2jkbr252t7-debug/Robot/obrazky/postupne/03_koncept_otocny_krk/B_rozpracovane/MG90S_porovnanie_s_modelom.png

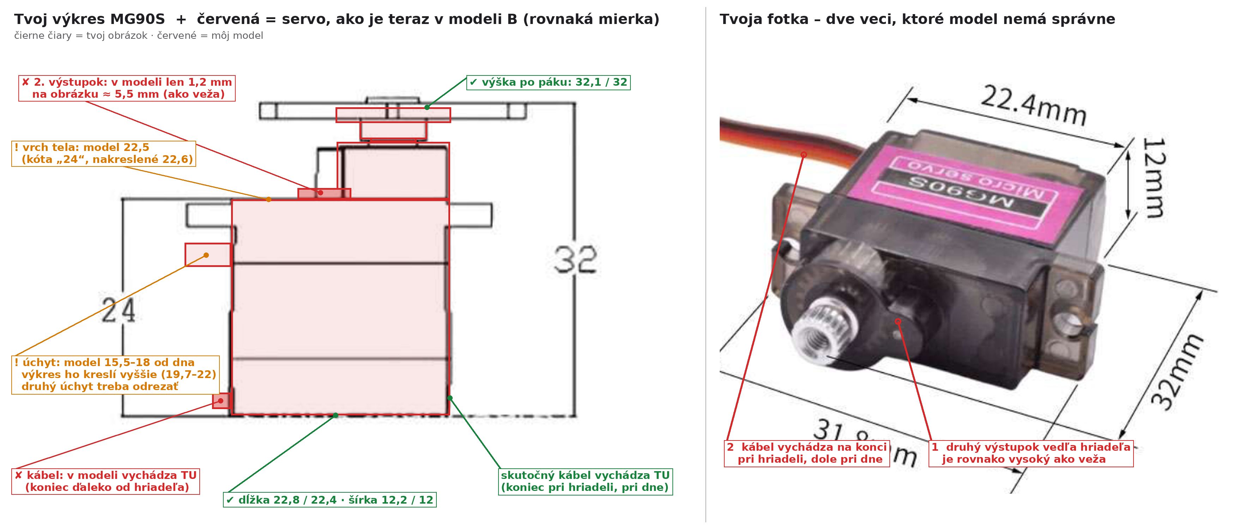
obrazky/postupne/03_koncept_otocny_krk/B_rozpracovane/MG90S_porovnanie_s_modelom.png
