2jkbr252t7-debug/Robot/obrazky/postupne/04_trup_rozpracovane/k2/koncept.md

# NOVA mini – K2 "off-axis gears, compact": internal packaging of torso + base

Files in `/tmp/claude-0/gapwf/fin/T1/k2/`: `layout.json` (t1lib, generated by `gen_layout.py`), `check.json`,
`envelope.json`, `head_keepout.json`, `head_real_check.json`, `prev_*.png` (rest + awake: iso, front, side, cut and
full sections `prev_*_rez_cut_side/front.png`). Coordinates: world mm, Z up, floor z = 0, FRONT = −Y, robot RIGHT = −X.
All shells in the layout are **soft placeholders** (torso superellipse n 2.35 with R16 edges, base n 2.35 with R10
edges, arms = rf 11.4 pills); they only prove that the internals fit a soft, modern body of R01 size.

## 0. Key numbers

| item | K2 value | R01 target | deviation |
|---|---|---|---|
| Z_TT (collar top) | 133.0 | – | head top 215 (range 205–215, upper end) |
| torso W × D × H | 89 × 80 × 89 (z 43–132) + collar plateau r 29.8 to z 133 | 91 × 78 × 87 | −2 % / +2.6 % / +2.3 % |
| base W × D × H | 142 × 110 × 34 (z 6–40), ground clearance 6 | 138 × 110 × 36–40 | +2.9 % / 0 / ok |
| arms | pill paddles 23 × 30 × 83, outer face ±69.5, shoulder axis X at (y 2, z 112) | 18–22 × 30 × 75–85, face ±67 | thickness +4.5 %, face +3.7 % |
| static clashes | **0** | | |
| sweep (18 STD + 23 own poses) | **0 unresolved** – residuals = 10 arm↔head instances in 4 STD poses forbidden by the firmware arm table + 3 t1lib head-envelope artefacts (2 poses at the B tilt-table limits) cleared with the real head mesh | | |
| mass / CoG | 892 g (head 165, neck + foot 49, pan stage 43, torso 232, arms 2 × 18, base 367); CoG rest (−0.1, −1.6, 74.8) | | |
| tipping (support: wheels ±54, casters y ±34) | rest: margin 27.4 mm, 20.1°, 16.1 mm left at 0.15 g; worst (arms 100° forward, head lifted + nodding 40°): 22.1 mm, 15.9°, 10.4 mm at 0.15 g | | stable |
| runtime (4 × 18650) | idle 13–15 h, typical 8.4–9.8 h (3000 / 3500 mAh, 85 % usable) | > 8 h | ok |

Why "K2": the two yaw joints are driven by spur gears from servos that sit **off the axis**, where a soft shell still
has room, and the vertical stack is kept as short as possible:

| z (world) | centre column (what sits on the J1 axis region) |
|---|---|
| 0–10.5 | ball casters Ø10 at y ±34; wheels Ø32 × 9 at x ±54 (axle z 16) |
| 6–8.2 | base bottom (battery covers) |
| 10–22.5 | 2 × N20 + magnetic encoders on the axle line, connectors meet at the centre |
| 10.8–30.0 | 4 × 18650 (2S2P): parallel group 1 = 2 cells in front of the axle, group 2 = 2 cells behind it, cells along X, series link over the axle |
| 23–30.8 | J1 hub bridge + steel-cored post (between the two battery groups) |
| 30.2–37.4 | J1 rolling-loop channel r 21.5–34 + 6805-2RS bearing r 12.5–18.5 |
| 38.8–42.0 | J1 gears: fixed brass sun m1 18T on the hub (slip clutch) + POM pinion m1 18T on the STS3215, centre distance 18 |
| 40 / 41–42.4 / 43 | base top / dark rotating plinth skirt r 34 / torso bottom |
| 45.5–80.5 | STS3215 shaft-down, offset −18 in X; pan servo STS3032 at the front (y −15…−28) |
| 81–82.8 | deck (carries the pan pivot pin, the pan servo, the frame) |
| 82.8–86.7 | PTFE washer, pan gear m0.8 36T + pinion 18T (front), pan rolling loop (back half, r 15.6–26.3, z 82.9–86.5) |
| 87.5–127 | pan stage: well 47 × 22, lift MG90S + crank behind the well, neck-wire lift loop at the +X end |
| 89.5–92.5 | neck foot at rest (109.5–112.5 extended) |
| 112 | shoulder axis (arm servos are in the paddles) |
| 118.5–124.5 | pan journal Ø56.4 in a POM-lined ring |
| 127–133 | collar disc + ring (finished variant B) |

## 1. Joints

### J1 – torso yaw ±150°
* **Actuator:** Feetech STS3215 (7.4 V version, 19.5 kg·cm = 1.91 N·m stall, 12-bit magnetic encoder over 360°,
  45.2 × 24.7 × 35 mm, 55 g; datasheet / vendor listings, confidence high for the footprint, medium for the height –
  I used the larger envelope 35 mm case + 2.6 mm spline boss, plus 11.3 mm for the two 5264 plugs and their bend).
  Inside the torso, shaft **down**, shaft at (−18, 0).
* **Transmission:** 1:1 external spur pair, module 1.0, 18T/18T (pitch Ø18, tip Ø20), centre distance 18.0, face 3.2
  (the stack has exactly 1.0 mm to the hub below and to the torso floor above). The sun gear is fixed to the base hub; the pinion (25T female spline + M3 axial screw) orbits it with the torso, so the
  servo turns exactly by the torso angle (310° of its 360° used). Why off-axis: with the shaft on the axis the servo's
  plug end lands at x ≈ 44.7, outside the soft torso (interior a 42.3 and smaller in the rounded bottom); with the 18 mm
  offset servo + plugs span x −29.5…+27 and stay centred. The pinion/sun pair lives in the 3 mm plinth gap and the base
  top layer, so the servo body starts directly on the torso floor.
* **Bearing:** 6805-2RS 25 × 37 × 7 (C 4.3 kN) – inner ring snapped on the static hub (POM collet on a steel M8 core,
  PETG post on a bridge between the battery groups), outer ring pressed into the rotating dark foot ring r 18.5–20.5. The bearing carries weight and
  tipping moments; the pinion floats axially (0.3 mm) on the spline, so the servo only sees torque.
* **Range / stops:** firmware ±150°; hard stops ±155° = tooth on the foot ring against a block on the hub (below the
  gears, outside the cable channel).
* **Torque:** yaw inertia of torso + head + arms ≈ 6·10⁻⁴ kg·m²; 90° in 0.6 s (triangular profile) → α 17.5 rad/s² →
  0.011 N·m; friction (2RS seals ≈ 0.015, mesh 5 %, rolling loop 0.002) ≈ 0.02 N·m → **0.03 N·m needed vs 1.91 N·m
  stall (≈ 60×)**. Holding: zero (vertical axis).
* **Tooth strength (the K2 weak point):** at full servo stall the m1 tooth would see 212 N (Lewis σ ≈ 220 MPa at 3.2 mm face) – too
  much for POM. Therefore (a) STS3215 torque limit 15 % (0.29 N·m → 32 N, σ ≈ 33 MPa on the 3.2 mm POM pinion, still ≈ 10× the need),
  (b) the brass sun gear sits on a **slip clutch** (wave spring + friction ring, slip 0.25 N·m) so a child twisting the torso
  slips the clutch instead of stripping teeth; the STS3215 load register detects a slip and the firmware re-homes on the
  ±155° stop at low torque, (c) preferred material: brass sun gear + POM pinion (quiet, wear-matched).
* **Backlash:** printed m1 pair 0.08–0.12 mm → 0.5–0.75° of torso yaw (0.6–0.8 mm at the display corner, r 64). Fix:
  slotted servo cradle (±0.3 mm centre distance) set to 0.02–0.03 mm → ≈ 0.2°; option: scissor sun gear (2 × 1.9 mm,
  wire spring). Firmware: approach targets from one side.

### PAN – head yaw ±85° (±90° mechanical)
* **Actuator:** Feetech STS3032 bus servo (360° magnetic encoder, 4.5 kg·cm @ 6 V, ≈ 3.7 kg·cm @ 5 V; vendor listings
  give 23.2 × 12.1 × 28.5 mm, 20–21 g – envelope used 23.5 × 12.5 case, 32.5 tabs, spline top 28.5; confidence medium),
  static in the torso front, shaft up at (0, −21.6).
* **Transmission:** spur m0.8, pinion 18T (Ø14.4) → gear 36T (Ø28.8) on the pan stage, **2:1 reduction**, centre
  distance 21.6, face 3.2/3.5 (POM). Servo ±170° → pan ±85°; resolution 0.044°/step. The gear is toothed only over the
  ~200° that can face the pinion; the remaining back sector is a smooth drum on which the pan rolling loop lies.
* **Bearing:** two-point: bottom = Ø6 steel pin fixed in the deck + bronze sleeve in the gear hub (radial) and a PTFE
  washer under the gear (axial, ≈ 3 N); top = Ø56.4 journal around the well (z 118.5–124.5) in a POM-lined ring of the
  frame (0.05–0.1 mm radial). Bearing span 36 mm → joint play ≤ 0.1/36 rad → ≤ 0.25 mm at the head top.
* **Stops:** pin under the gear in a 180° arc slot of the deck → ±90°; firmware ±85°.
* **Torque:** pan inertia (head + neck + stage) ≈ 2.7·10⁻⁴ kg·m², 85° in 0.35 s → 48 rad/s² → 0.013 N·m; friction
  (PTFE thrust 0.003, journal 0.007, loop 0.002) → 0.026 N·m needed vs 0.72 N·m at the gear (≈ 28×). Tooth: with the
  servo torque limit at 40 % the m0.8 tooth stays < 30 MPa; a 5 N push on the head edge gives only 19 N on the tooth.
* **Backlash:** gear 0.08 mm at r 14.4 (0.32°) + servo internal backlash halved by the 2:1 (≈ 0.25°) → ≈ 0.6° ⇒
  ≈ 0.6 mm at the display corner. Option: a light torsion spring (0.01 N·m) between frame and pan stage to bias one flank.

### LIFT – neck 0…20 mm
* **Actuator:** MG90S (22.8 × 12.2 × 28.5, 13.4 g, 1.8 kg·cm @ 4.8 V / 2.2 @ 6 V; electronics_dims.json) on the pan stage
  **behind the well**, shaft along X at (y 19.1, z 104.8); its lower mounting tab is cut off (as the B neck servo).
* **Mechanism:** crank r 10 (POM) with a Ø2 steel pin in a 2.2 × 12.2 horizontal slot of the **ear** of the neck foot.
  The foot (POM, 45 × 20 × 3) is screwed into the neck bottom (allowed new part) and passes through the collar slot; the
  ear is a separate POM link screwed to the foot through a 4.5 mm window in the well's back wall. lift = 10·(1 − cos θ),
  θ 0 → 180°: **dead centres at rest and at full lift → zero holding torque in both end positions**; the well (47 × 22,
  1 mm clearance, two PTFE tape strips) remains the linear guide.
* **Stops:** crank dead centres; backups: foot 1.0 mm above the well floor, ear 1.4 mm below the journal ring at 20 mm.
* **Torque:** neck + head + foot 213 g → 2.1 N, guide friction (CoG offset y −8 → 0.4 N) + loop 0.1 N → 2.6 N ×
  r 10 = 0.026 N·m max (mid-stroke) vs 0.177 N·m stall @ 5 V → **6.8×**. Holding at the awake pose (12.5 mm, θ 104.5°):
  0.025 N·m (≈ 15 % of stall, acceptable; dead centres are used for rest and full lift). Full stroke 0.36 s at 5 V
  (firmware ramps to ≈ 0.5 s).

### TILT – unchanged (variant B rev. E2)
MG90S in the neck, tilt-vs-lift interlock table of `B/montaz.txt`; PWM and 5 V from the torso controller through the
pan loop. Verified here with the **real head mesh** against the K2 placeholder top over the whole table and pan
−85…85: min 0.45 mm at the collar plateau edge (r 29.8, same B criterion ≥ 0.25), ≥ 1 mm elsewhere; real hinge lugs vs
the K2 well: 1.0 mm (`head_real_check.json`).

### ARMS – one servo inside each paddle
* **Actuator:** slim metal-gear micro servo, EMAX ES9052MD class (listings: 19.9 × 8.8 × 23.1–26.35 mm, 5.5–6 g,
  1.3 kg·cm @ 6 V; envelope used 21 case + 5.35 boss/spline along X, 20.5 × 9.4 – larger listing, confidence medium).
  The case is fixed in the paddle and turns with the arm; its spline sits in a **static spline socket** on the side
  column of the torso frame (r 7 hub at |x| 37.5–43). The arm pulls off sideways (magnetic detent) for service.
* Why in the paddle: inside the torso the shoulder servos would sit exactly in the pan-stage sweep (r ≤ 35.9 around the
  well); in the paddle they cost only 2–3 mm of paddle thickness.
* **Range:** −45…+135° (180° servo travel, verify 500–2500 µs on purchase). The head (|x| 55, ears 58.8) is wider than
  the arm's inner face (|x| 46.5), so the upper limit depends on the head pose – firmware table `check.json →
  arm_limit_table_deg` (every entry verified with ≥ 2 mm to the head envelope). Right arm at pan 0: 102° (rest), 125°
  (lift 20), 95–98° while the head nods down (lift 12.5/+30°, lift 20/+40°), 144–151° while it looks up; with the head
  panned ≥ 60° and not nodding towards that arm the geometry allows 180°, i.e. the full 135° servo travel. Left arm =
  same table with the pan sign inverted. The firmware clamps the arm command to this table (interpolated, −2° margin).
* **Torque:** paddle 10.6 g with CoG 25 mm below the axis + servo on the axis → 0.003 N·m holding at 90°, 0.0014 N·m to
  accelerate 90° in 0.25 s → 0.0045 N·m vs 0.108 N·m @ 5 V (≈ 24×).
* Clearances: paddle ↔ torso 2.0 mm, black cap ↔ shoulder pocket 1.0 mm, paddle ↔ base ≥ 5.0 mm (tip at z 45 over the
  base top z 40, also over J1 ±150°), the two arms never meet.

### WHEELS – differential drive
* 2 × N20 6 V 1:150 with magnetic encoder (12 × 10 × 34 + encoder 8 + plug 5; 7 PPR × 4 × 150 = 4200 counts/wheel
  rev), wheels Ø32 × 9 (TPU tyre) at x ±54, track 108, axle z 16, 6 mm below the base bottom; DRV8833 (Pololu
  20.3 × 15.2). Two 3/8″ ball casters at y ±34 (support diamond). Ground clearance 6 mm.
* **Torque:** robot ≈ 0.89 kg: rolling 0.2 N + 0.5 m/s² + 5° ramp 0.85 N → 1.55 N → 0.012 N·m per wheel vs
  ≈ 0.2 N·m stall (≈ 16×). Speed ≈ 110 rpm → 0.18 m/s at 6 V (desk use 0.05–0.12 m/s).

### Checks (t1lib, `check.json`)
* **Static:** 0 clashes (73 K2 components + 10 B envelopes, all pairs except the listed intended fits: gear meshes,
  bearing seats, journal, PTFE washer, crank pin in the ear slot, light guides / ports through the shells).
* **Sweep STD_POSES (18):** 10 clash instances in 4 poses, all arm ↔ head (arm at 135–180° with the head in front of it);
  every one is outside the arm limit table and therefore forbidden by firmware. Nothing else.
* **Own extra poses (23):** pan ±85 with lift 0 / 5 / 10 / 12.5 / 15 / 20 and the table tilts (+5/−10 at lift 0, +30/−40
  at 12.5, ±40 at 20), intermediate pans/lifts (±30, ±45, ±60), awake pose, arms −45/0/45/100/180 combined with head
  poses, J1 ±150 / ±75 with arms forward/up/back. Result: 3 instances in 2 poses (pan −85 with lift 12.5/tilt −40 and lift 0/tilt −10:
  T_shell ↔ B_hlava, P_sachta ↔ B_uska) – all at the limits of the B tilt table and caused by the t1lib head envelopes
  (rf-14 box, lug box), which are lower/larger than the real head. Re-checked with the real B rev. E2 meshes over the
  whole tilt table × pan −85…85 (`head_real_check.json`): head ↔ torso top ≥ 0.45 mm (over the plateau, B criterion),
  real lugs ↔ K2 well 1.0 mm. 0 unresolved.
* **Min clearances of K2 moving parts:** lift servo/crank/loop ↔ torso internals 1.0; neck foot + ear ↔ torso 1.15,
  ↔ well 1.0; well corners ↔ pan channel 1.0; pan stage ↔ torso shell 1.9; J1 rotating parts ↔ base 1.0 (foot ring ↔ FPC
  channel, sun gear ↔ torso floor); arm ↔ torso 1.0 (cap in the pocket) / 2.0 (paddle); arm ↔ base 5.0; arm ↔ head ≥ 2.0
  inside the table. Intended < 1 mm: collar disc/ring seam 0.25 (B), pan journal running fit, pan loop resting on its
  drum, real head over the collar plateau 0.45 (B criterion ≥ 0.25).

## 2. Cable routing

**J1 (6 conductors, ±155°):** VBAT ×2, GND ×2, servo/node bus, wake/spare. Default: custom polyimide FPC 6.0 × 0.15 mm
(2 oz Cu: VBAT/GND traces 1.3 mm, bus/wake 0.4 mm; ≈ 4 A peak total); alternative: 4 × AWG26 + 2 × AWG30 silicone
Kapton-bonded on edge (6.4 mm). Path: base charger/BMS area (back) → static anchor on the outer wall of the channel
(inner face r 32.5, ≈ 120°) → outer run on the static wall → U-turn → inner run on the rotating foot ring (r 20.5) → rotating anchor →
up through the torso floor at r ≈ 20 → JST-GH 6p on the torso controller. Rolling loop in the annulus r 21.5–34,
z 30.6–37.2: U-turn centreline radius ≈ 5.3 mm (≈ 35× FPC thickness), U-turn travel 0.40 × Δθ (125° for 310°),
**loop length in the channel ≈ 103 mm** (+ 2 × 15 mm leads → 135 mm). No slip ring, no twist.

**PAN (8 conductors, ±85° + 20 mm lift):** head 4 (5 V_H, GND_H AWG28 PTFE Ø0.85; TX, RX AWG30) + servo group 4
(5 V_S, GND_S AWG28; PWM tilt, PWM lift AWG30) as a 2 × 4 Kapton-bonded ribbon 3.6 × 1.8 mm. Path: head → neck
channels (B) → neck bottom exit (x 13.8) → channel inside the POM foot → foot +X end → window in the well's +X end wall →
**vertical lift loop** on the outside of that wall (x 25.3–27.8, z 89.5–113; U-turn rises 10 mm for 20 mm lift) → down
under the well → rotating anchor on the smooth drum sector of the pan gear → inner run on the drum (r 15.7) → U-turn
(centreline R 5.2) → outer run on the static back-half wall (r 26.1) → static anchor ≈ 20° → through the deck to the
controller (JST-SH 4p + 4p). Loop in the channel ≈ 56 mm; U-turn travel 0.37 × Δθ (63° for 170°); everything stays in the
back half, away from the pan pinion at the front. Lift-servo leads (3) join the ribbon on the pan stage via a 2 × 3 pin
micro-junction (shared 5 V_S/GND_S).

**Arms:** 3 × AWG30 per arm, one-turn flat spiral in the shoulder pocket (r 7.5–12.5, |x| 41.2–43.2), JST-SH 3p inside
the torso. Range 180° → spiral rotates ±0.25 turn.

## 3. Electronics and power

```
 2S2P 18650 (7.2 V nom, 6.0–8.4 V, 43–50 Wh) ── 2S BMS (balance, OCP 8 A) ── AO4407A main switch (self-locking button, back)
   │ base                                         │ J1 rolling FPC (VBAT×2, GND×2, BUS, WAKE)
   ├ DRV8833 → 2× N20 (PWM-limited to 6 V)        │ torso
   ├ D24V10F5 5 V/1 A → RP2040-Zero node,        ├ STS3215 J1 (VBAT direct, bus ID 1)
   │   encoders (PIO), 4× ITR8307 cliff (ADC),   ├ D36V28F5 5 V/2.8 A + 470 µF → 5 V rail:
   │   VL53L1X ToF (I2C), base LED bar (8× 2020)  │     head (5 V_H, UART 1 Mbps via pan loop), tilt MG90S, lift MG90S,
   └ IP2326 2S charger ← USB-C 5 V/2 A (back)     │     2× arm ES9052MD, pan STS3032 (bus ID 2), ESP32-S3-Zero,
                                                  │     torso LED bar (6× 2020), MAX98357A → Ø28 speaker
                                                  └ ESP32-S3-Zero: UART head, half-duplex bus (74LVC1G126), 4× PWM, I2S, LED
```
* The base node (RP2040-Zero, 23.5 × 18) is bus ID 20: wheel speeds, encoder counts (PIO quadrature), cliff stop
  locally within 1 ms, ToF, charger status, LED bar. Battery voltage is read from the STS3215 voltage register.
* **5 V rail (torso):** typical 0.55 A; firmware-capped peak 2.5 A (max. two micro-servos in fast motion at once, audio
  peaks buffered by 470 µF) < 2.8 A of the D36V28F5.
* **Charging:** IP2326 boost charger (5 V/2 A in, 8.4 V CC/CV ≈ 1 A, ≈ 6–7 h for 6 Ah). The robot may stay on while
  charging (USB 10 W > 2.8 W idle), but the charger only terminates when the robot is off or asleep (< 50 mA); a full
  charge is therefore done with the main switch off. Charge state shown on the base LED bar + a small LED at the port.
  (True power-path is a phase-2 option: buck-boost NVDC charger.)

| power at the battery | idle (awake, no motion) | typical | peak (< 1 s) |
|---|---|---|---|
| head board + LCD + ears | 1.25 W | 1.6 W | 2.5 W |
| torso MCU + bus driver | 0.20 | 0.25 | 0.4 |
| STS3215 / STS3032 | 0.23 | 0.45 | 7.4 + 2.0 |
| 4 micro servos (tilt, lift, 2 arms; lift holding at 12.5 mm) | 0.28 | 0.6 | (5 V cap) |
| LED bars (20 %) | 0.20 | 0.25 | 1.2 |
| audio | 0.01 | 0.15 | 1.8 |
| base node, encoders, ToF, cliff | 0.35 | 0.40 | 0.5 |
| N20 + DRV8833 | 0 | 0.20 | 7 |
| converter + BMS losses | 0.30 | 0.45 | 3 |
| **total** | **≈ 2.8 W** | **≈ 4.35 W** | **≈ 30 W** (5 V rail capped at 14 W; pack 4.7 A = 2.3 A/cell) |

Runtime, 85 % usable: 3000 mAh (36.7 Wh) → idle 13.1 h, typical 8.4 h; 3500 mAh (42.8 Wh) → idle 15.3 h, typical 9.8 h;
sleep (display off, servos unpowered, ≈ 0.35 W) > 100 h.

## 4. Mass, CoG, tipping
| group | g | main items (bought = datasheet/listing, printed = volume × density) |
|---|---|---|
| head (finished B) | 165 | shell, display board, ears (t1lib B_HEAD_MASS) |
| neck + foot (lift group) | 49.4 | neck + MG90S tilt 45, POM foot + ear 4.4 |
| pan stage | 43.0 | collar disc 8.8, well + journal (resin) 15.1, MG90S lift 13.4, pan gear 3.8, crank 0.9, wires 1 |
| torso | 232.1 | resin shell 2.2 mm 69.6, STS3215 55, 6805-2RS 22, STS3032 21, deck/cradle/columns/ring PETG ≈ 23, controller 8, speaker 6, J1 skirt/foot/pinion ≈ 9, buck/amp/cap/LED ≈ 9.5, cables ≈ 4 |
| arms (2×) | 36.2 | per arm: resin paddle 10.6, ES9052MD 6, cap 1, cable 0.5 |
| base | 366.5 | 4 × 18650 incl. strips 196, resin shell 77.7, 2 × N20 + encoder 24, wheels 14, casters 8, brass sun gear 8.5, hub/channel/FPC ≈ 15, charger/BMS/USB/switch 11, node/driver/buck/ToF/LED/cliff ≈ 11 |
| **total** | **892** | CoG rest (−0.1, −1.6, 74.8) |

| pose (t1lib `tipping`, accel 0.15 g) | CoG (x, y, z) | static margin | tip angle | margin at 0.15 g |
|---|---|---|---|---|
| rest | (−0.1, −1.6, 74.8) | 27.4 mm | 20.1° | 16.1 mm |
| awake (lift 12.5, tilt 10, pan 30, arms 60/−20) | (1.2, −3.0, 77.6) | 25.6 | 18.2° | 13.9 |
| arms 100/100, lift 20, tilt 40 (worst) | (−0.1, −7.9, 77.4) | 22.1 | 15.9° | 10.4 |
| J1 90, pan 85, lift 20, tilt 40, arms 90 | (1.9, 6.3, 77.3) | 22.4 | 16.2° | 10.9 |
| J1 45, pan 85, lift 20, tilt 40, arms 100 | (5.8, 3.2, 77.4) | 22.9 | 16.5° | 11.3 |
| arms −45, lift 20, tilt −40 | (−0.1, 5.1, 78.6) | 24.4 | 17.3° | 12.6 |

Support polygon = diamond of the wheels (±54, 0) and casters (0, ±34); its four diagonal edges are 28.8 mm from the
centre. 41 % of the mass sits in the base below z 40, which keeps the CoG at 75–79 mm in every pose.

## 5. Assembly order, service, hidden fasteners
**Base:** (1) heat-set inserts in the white top shell; (2) chassis (PETG) with motor clamps, hub bridge, J1 hub
(steel M8 core) + slip-clutch sun gear, J1 channel with the FPC static anchor; (3) motors + encoders + wheels; (4) PCBs:
node, DRV8833, buck (corner pockets beside the battery bays), BMS, charger + USB-C + switch (on top of the battery
groups, outside r 35), ToF + LED bar at the front; (5) dark bottom plate with casters and cliff boards; (6) the two
battery groups (series link + balance lead, XT30 + JST-XH, no hot glue) drop into two bays from below, each closed by
a cover with 2 × M2 – **the only screws of the base, all on the underside**.
**Torso:** (1) printed frame = cradle + deck + 4 columns + top journal ring (2 parts, screwed); (2) STS3215 into the
cradle (4 × M2 side holes), pinion; (3) STS3032 + pinion (2 tab screws); (4) pan stage: pivot pin, PTFE washer, pan gear
(stop pin), well, lift MG90S + crank; (5) controller, buck, amp, cap, speaker, LED bar, arm spline sockets + cable
spirals; (6) shell = rear shell + front panel (R01 front-panel seams): rear shell screwed from the torso bottom (inside
the plinth gap, invisible), front panel on 4 N52 magnets + 2 locating pins; (7) collar ring glued in; (8) neck + head
from above per B montaz: neck + foot pass through the collar slot, then the ear link is screwed to the foot through
the back-wall window (rear shell off), collar disc on; (9) torso onto the base: the 6805 (pressed into the foot ring)
slides over the sun gear (Ø20 < bore Ø25) and snaps over a 3-finger POM collet lip of the hub (pull-off ≈ 30 N, 8× the
weight of the base, so the robot can be lifted by the torso), the pinion meshes vertically, FPC plugged through the
rear opening.
**Service:** battery – bottom covers; USB-C/switch – on the back of the base; arm servo – pull the arm off, unplug
JST-SH; lift servo, controller, pan loop – rear shell off (screws under the torso); pan servo – front panel off;
STS3215 – pull the torso off the collet, unplug the FPC (15 mm slack), 4 screws. No screws on top/front/sides.

## 6. How much the soft shell constrains K2
The minimum interior that encloses all K2 internals + 1.0 mm (`envelope.json`, slices every 5 mm, superellipse with the
placeholder aspect b/a = 0.9) is **a ≥ 40.9 mm** for n 2.35–3.0 (41.2 for n 2.2), set by the pan/lift sweep at
z 88–118 and by the J1-servo zone at z 53–73 → with a 2.2 mm wall the smallest soft torso is **≈ 86 × 78 mm**; R01's
91 × 78 fits. The placeholder is 89 × 80 because parts that are screwed to the shell anyway (side columns with the arm
spline sockets at |x| ≤ 41.5, speaker at |y| ≤ 36.6) sit right at the wall. The base needs a ≥ 68.0 (n 2.35,
b/a 0.775) → **≥ 140.4 × 109.8 mm**; the exponent barely matters (68.1 at n 2.2) because the critical points are the
wheels (|x| 59.5), the ToF window and the battery-pack ends, not the corners.

What the soft shell actually cost:
1. **J1 servo off the axis.** With the STS3215 shaft on the axis its plug end (+11 mm) lands at x ≈ 44.7, outside the
   rounded interior (42.3, less in the R16 bottom). The 18 mm offset + 1:1 spur pair keeps servo and plugs within
   x −29.5…+27 – the main reason for K2's gears.
2. **Depth is set by the lift crank:** the crank/ear sweep r 35.9 about Z (back and right sector) needs an interior
   depth ≥ 2 × 36.9 → 78.2 mm outside with a 2.2 wall (placeholder 80).
3. **Bottom rounding (R16):** below z 53 only the centred STS3215 fits; the amp, buck and controller moved up to
   z ≥ 52–55, the pan servo into the front band (y −15…−28) where the superellipse still has full depth.
4. **Top:** a 1 mm collar plateau r 29.8 is needed in every direction, because pan ±85° swings the nodding head over the
   wide X sides where a plain R16 edge stays too high (real-head check: 0.45 mm over the plateau, ≥ 1 mm beyond). The
   arm sockets (axis 21 mm below the top) sit just under the R16 top edge, so the shoulder pockets are partly cut into
   the rounded shoulder – the R01 look of caps on the upper corners.
5. **Base corners:** the four 66.5 mm cells end 1–2 mm from the n 2.35 / 142 × 110 interior; the four small boards
   (node, driver, buck, charger) live in the triangular pockets beside the cell ends.
6. **Plinth:** with ≥ R15 edges the torso's flat bottom is only ≈ 57 × 48, so the rotating dark skirt r 34 shows under
   the rounded belly as the R01 plinth ring – a feature, but it fixes the base top as flat to r 36.

## 7. Top risks
1. **J1 gear mesh is the weakest link** against a user twisting the torso → slip clutch + torque limit + re-homing are
   mandatory, brass sun gear recommended.
2. **Yaw backlash** of two gear pairs (J1 + pan) ≈ 0.2–0.8° each → visible head wobble of 0.3–0.8 mm if not adjusted.
3. **Zero vertical slack** in the torso stack (STS3215 top 80.5 → deck 81). The STS3215 height is taken as the larger
   envelope (35 + 2.6); if the real servo is 35 overall we gain 2.6 mm.
4. **Pan loop on a half-toothed drum** is novel; fallback = loose 8-wire S-loop behind the well (needs ≈ 8 mm more torso
   height).
5. **Arm/head interference** is inherent to R01 proportions → firmware table; the slim arm servo (8.8 mm class) must be
   verified for 180° travel and availability; with an MG90S the paddle grows to ≈ 26 mm.
6. **Lift holds torque away from the dead centres** (awake pose 12.5 mm): MG90S hum; consider dead-centre-only poses or a
   bus servo (SCS0009) for silent holding.
7. **Base corners:** the battery groups end 1–2 mm from the placeholder base wall at the four corners – the exterior
   must keep ≥ 142 × 110 at z 11–30 with n ≥ 2.3 or the base grows.
8. **Head top clearance in X:** the wide torso (89) must still drop ≥ 1 mm beyond r 30 in every direction (pan ±85 swings
   the nodding head over the X sides) – collar plateau r 29.8 + 1 mm step in the placeholder.

## Zhrnutie (SK)
* K2 = otočné kĺby poháňané ozubenými kolesami zo serv mimo osi: trup (J1) Feetech STS3215 posunutý o 18 mm s prevodom
  1 : 1 (modul 1, 18/18 zubov), otáčanie hlavy Feetech STS3032 vpredu s prevodom 2 : 1 (modul 0,8, 18/36 zubov).
* Vďaka tomu sa všetko zmestí do mäkkého trupu 89 × 80 × 90 mm (R01: 91 × 78 × 87); najmenší možný mäkký trup je ≈ 86 × 78.
* Zdvih krku: MG90S za šachtou, kľuka r 10 s mŕtvymi bodmi na oboch koncoch (v pokoji aj hore servo nedrží záťaž).
* Servá ramien sú priamo v lopatkách (hrúbka 23 mm), ramená idú −45…+135°; horná hranica závisí od polohy hlavy (tabuľka).
* Podstavec 142 × 110 × 34: 4 × 18650 (2S2P) v dvoch dvojiciach pred a za nápravou, výmena zospodu, USB-C a vypínač vzadu.
* Káble cez otočné kĺby idú vo valivých slučkách (J1: 6 vodičov, 103 mm; hlava: 8 vodičov, 56 mm) – bez zberacích krúžkov.
* Kontroly: 0 statických kolízií, 0 nevyriešených kolízií v 41 polohách; hmotnosť 892 g, ťažisko vo výške 75 mm,
  robot sa prevráti až pri náklone 20°.
* Výdrž: v pokoji 13–15 h, pri bežnom používaní 8,4–9,8 h. Hlavné riziká: zuby J1 pri násilnom otočení trupu (riešenie:
  trecia spojka + obmedzenie momentu), vôľa ozubení (0,2–0,8°) a nulová výšková rezerva v trupe.
