2jkbr252t7-debug/Robot/obrazky/00_NOVA_prehlad.png

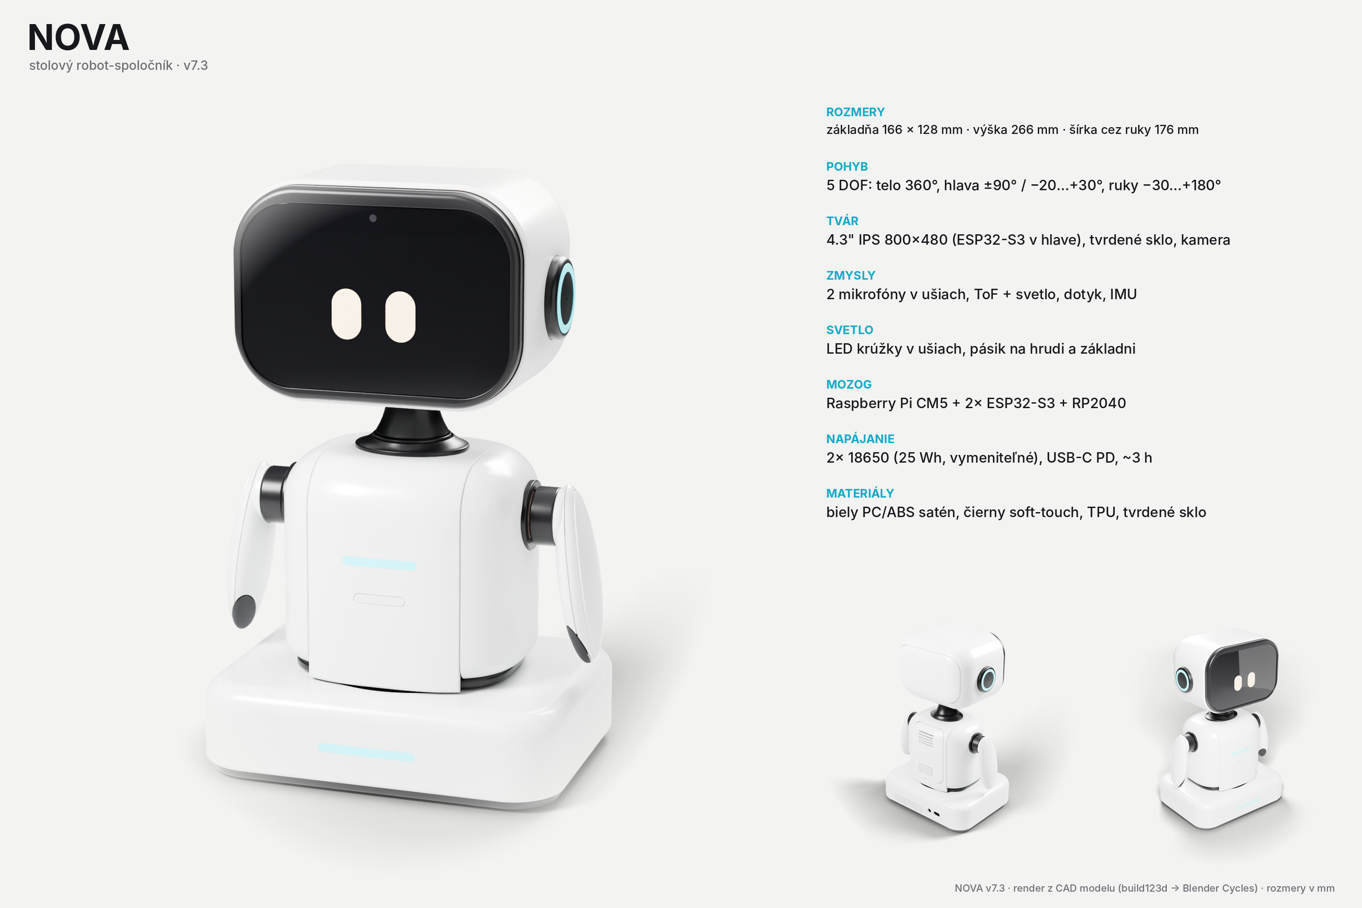
obrazky/00_NOVA_prehlad.png
