2jkbr252t7-debug/Robot/obrazky/00b_NOVA_hero.png

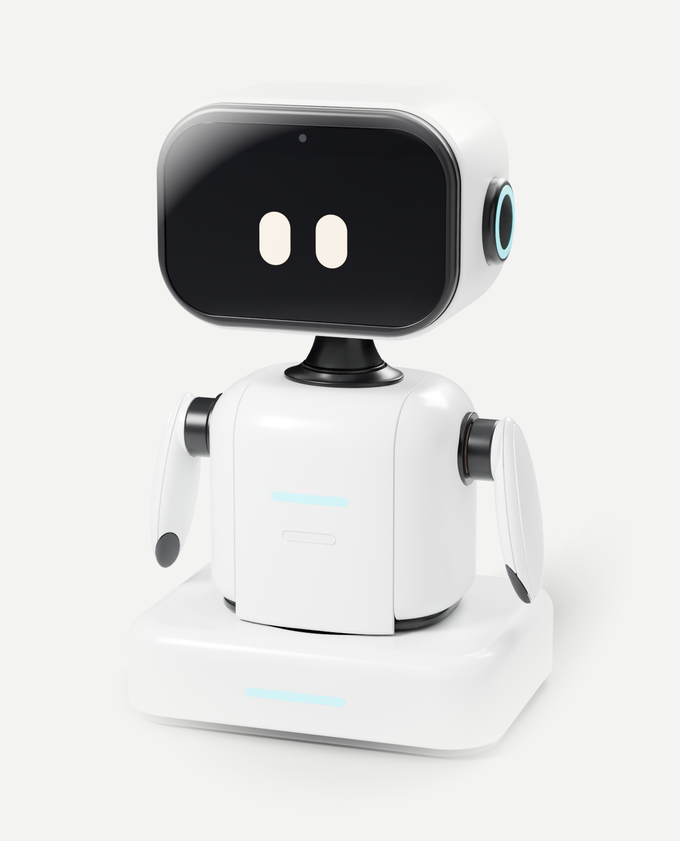
obrazky/00b_NOVA_hero.png
