2jkbr252t7-debug/Robot/obrazky/01_NOVA_celok_6_pohladov.png

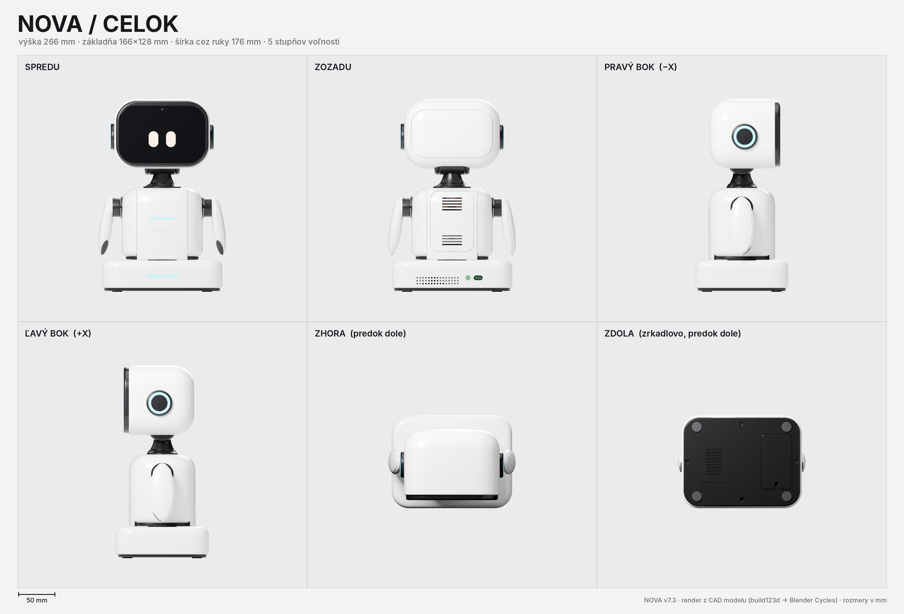
obrazky/01_NOVA_celok_6_pohladov.png
