2jkbr252t7-debug/Robot/obrazky/02_NOVA_rozmery.png

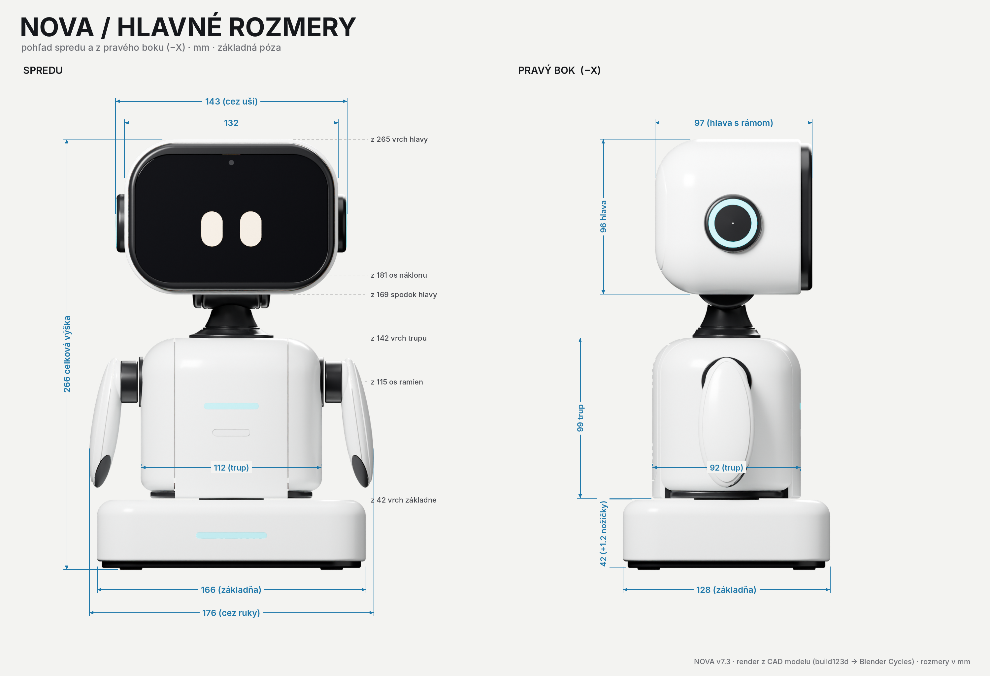
obrazky/02_NOVA_rozmery.png
