2jkbr252t7-debug/Robot/obrazky/03_NOVA_rozlozeny_pohlad.png

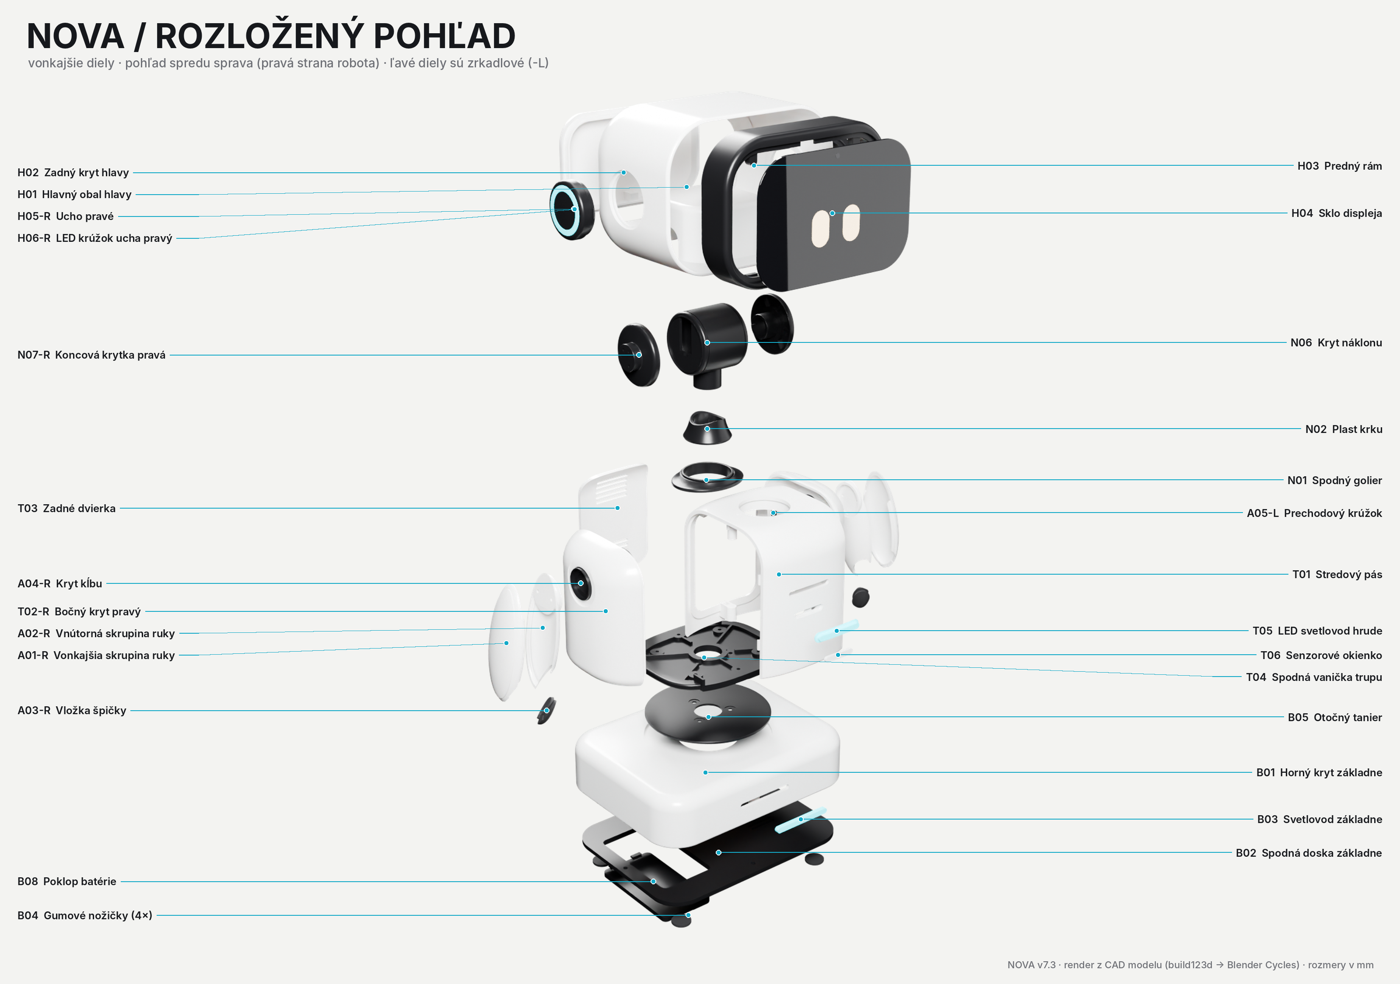
obrazky/03_NOVA_rozlozeny_pohlad.png
