2jkbr252t7-debug/Robot/obrazky/04_NOVA_rezy.png

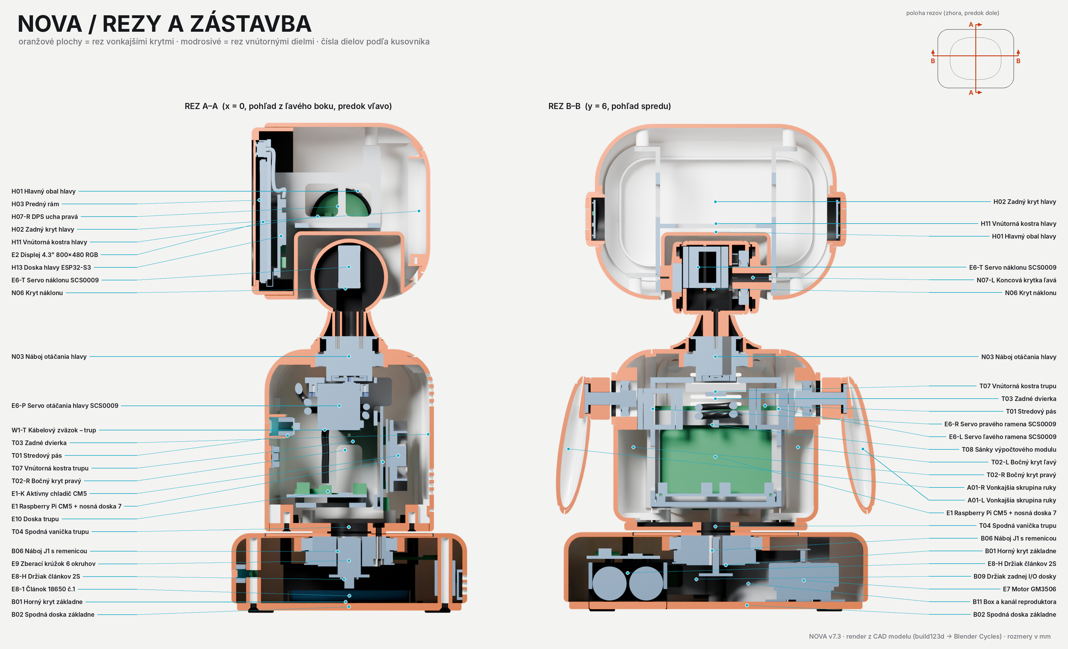
obrazky/04_NOVA_rezy.png
