2jkbr252t7-debug/Robot/obrazky/05_NOVA_vnutro.png

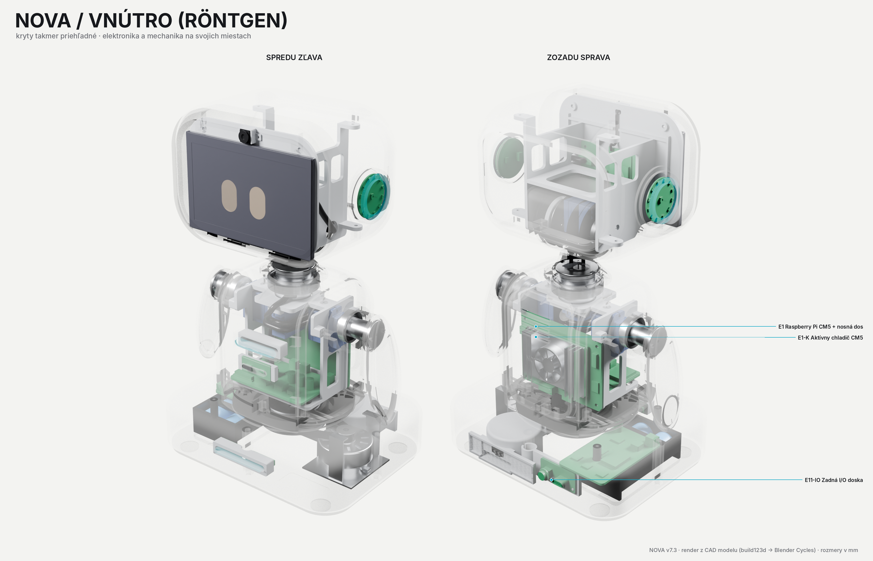
obrazky/05_NOVA_vnutro.png
