2jkbr252t7-debug/Robot/obrazky/06_NOVA_kinematika.png

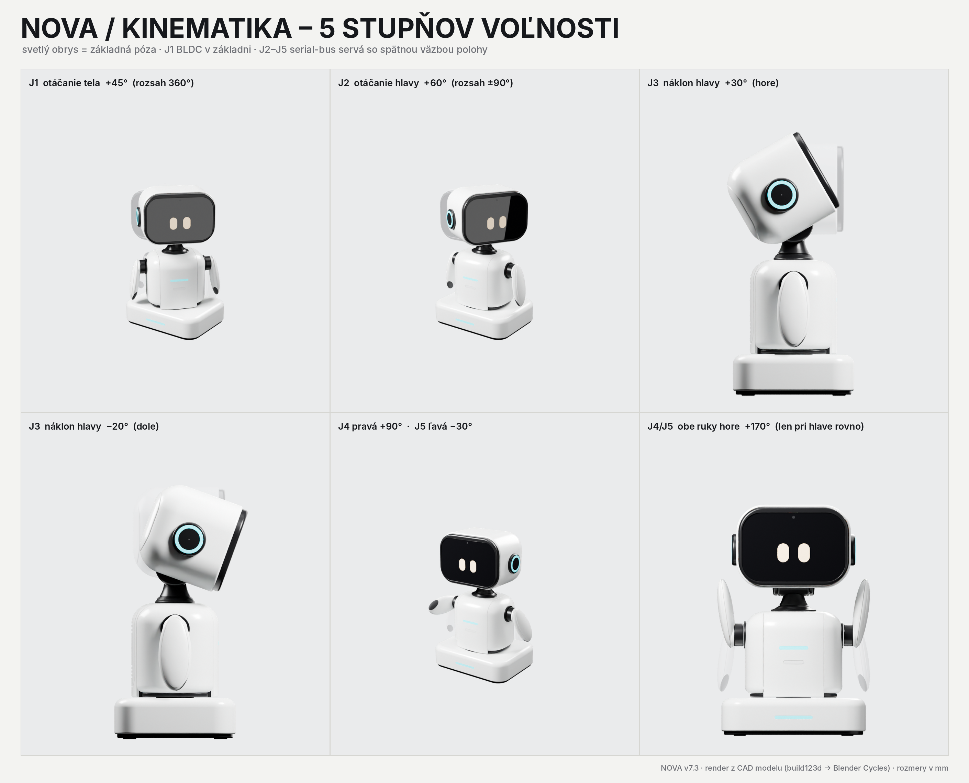
obrazky/06_NOVA_kinematika.png
