2jkbr252t7-debug/Robot/obrazky/07_NOVA_hlava.png

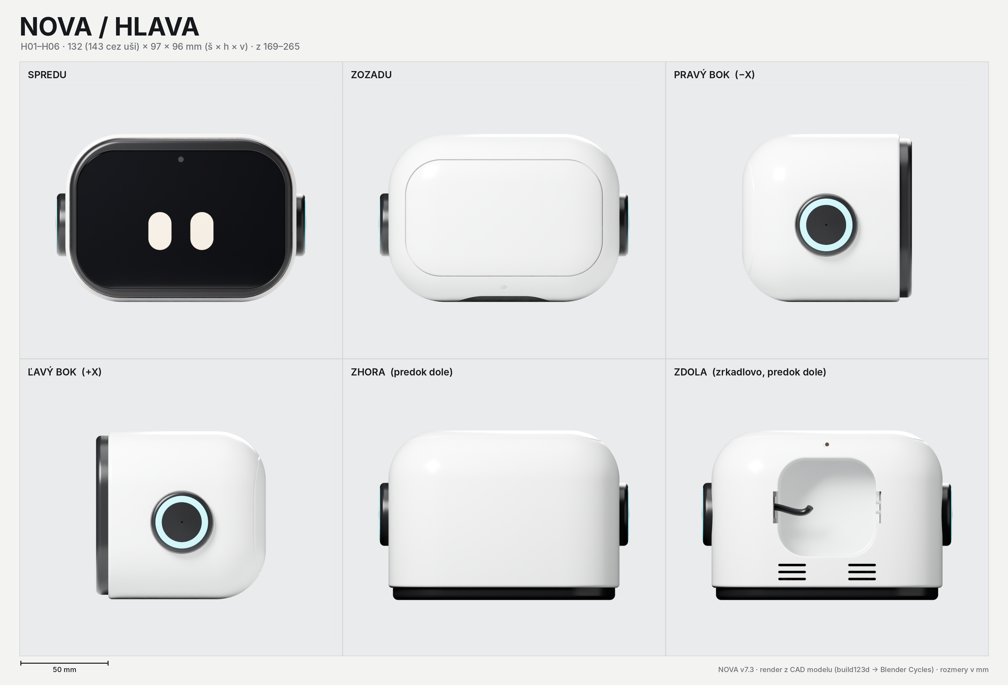
obrazky/07_NOVA_hlava.png
