2jkbr252t7-debug/Robot/obrazky/08_NOVA_kryty_hlavy.png

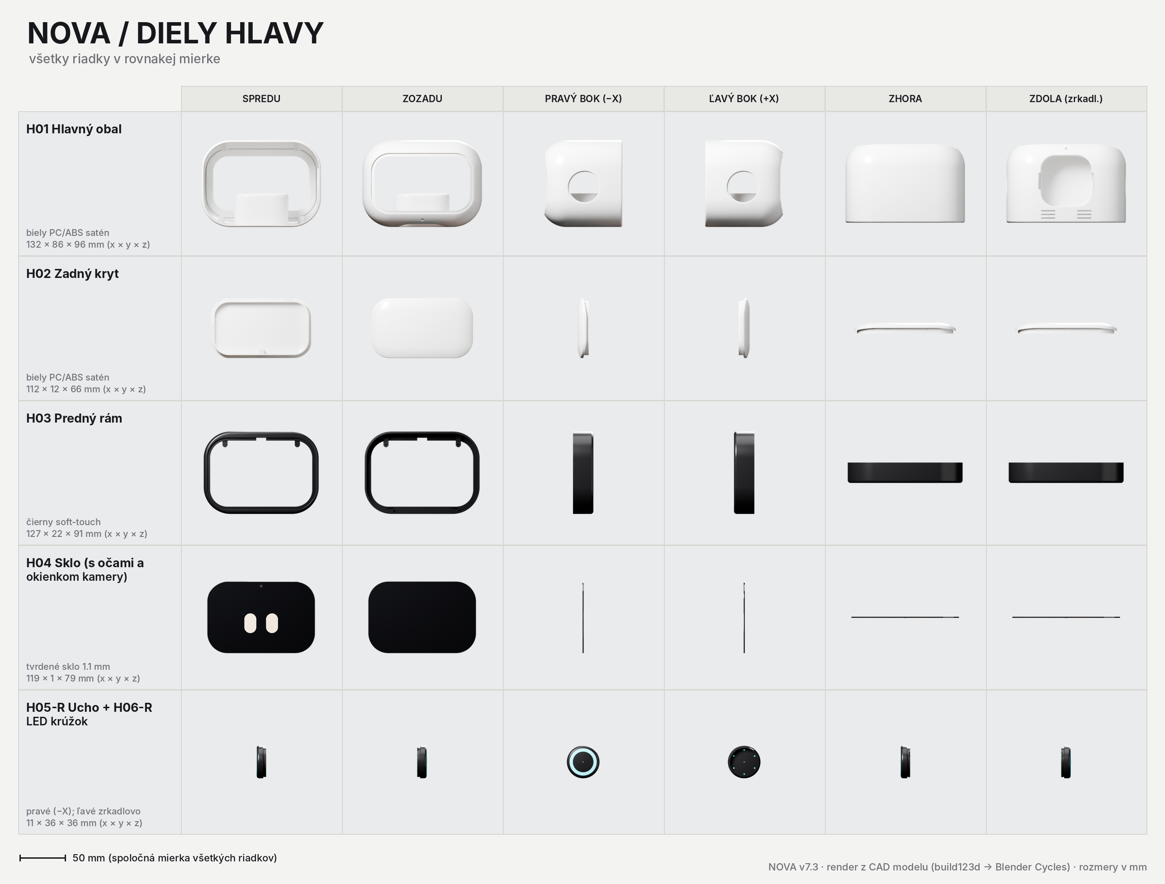
obrazky/08_NOVA_kryty_hlavy.png
