2jkbr252t7-debug/Robot/obrazky/09_NOVA_krk.png

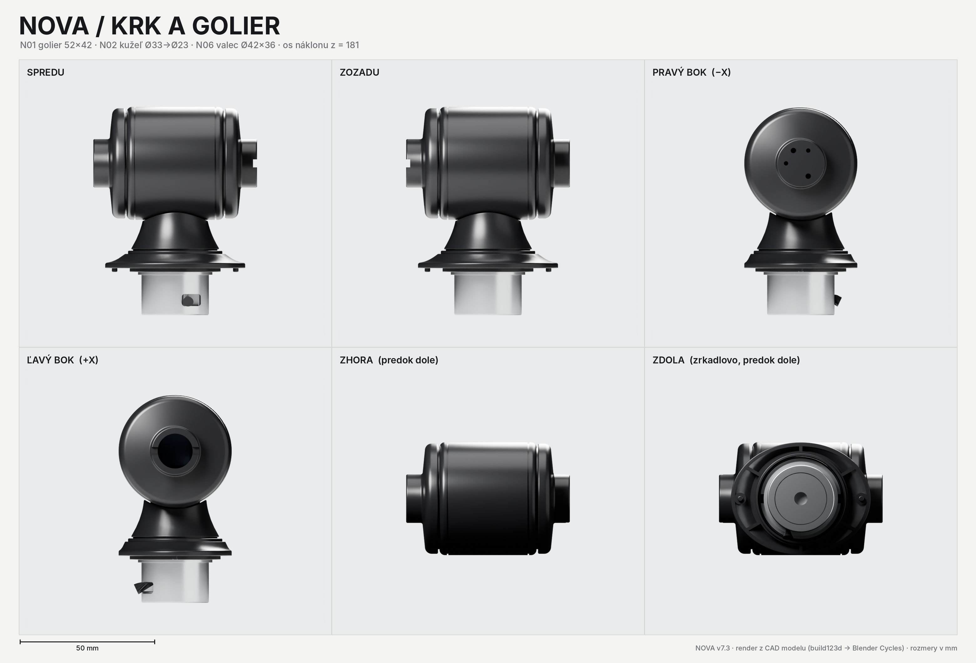
obrazky/09_NOVA_krk.png
