2jkbr252t7-debug/Robot/obrazky/10_NOVA_kryty_krku.png

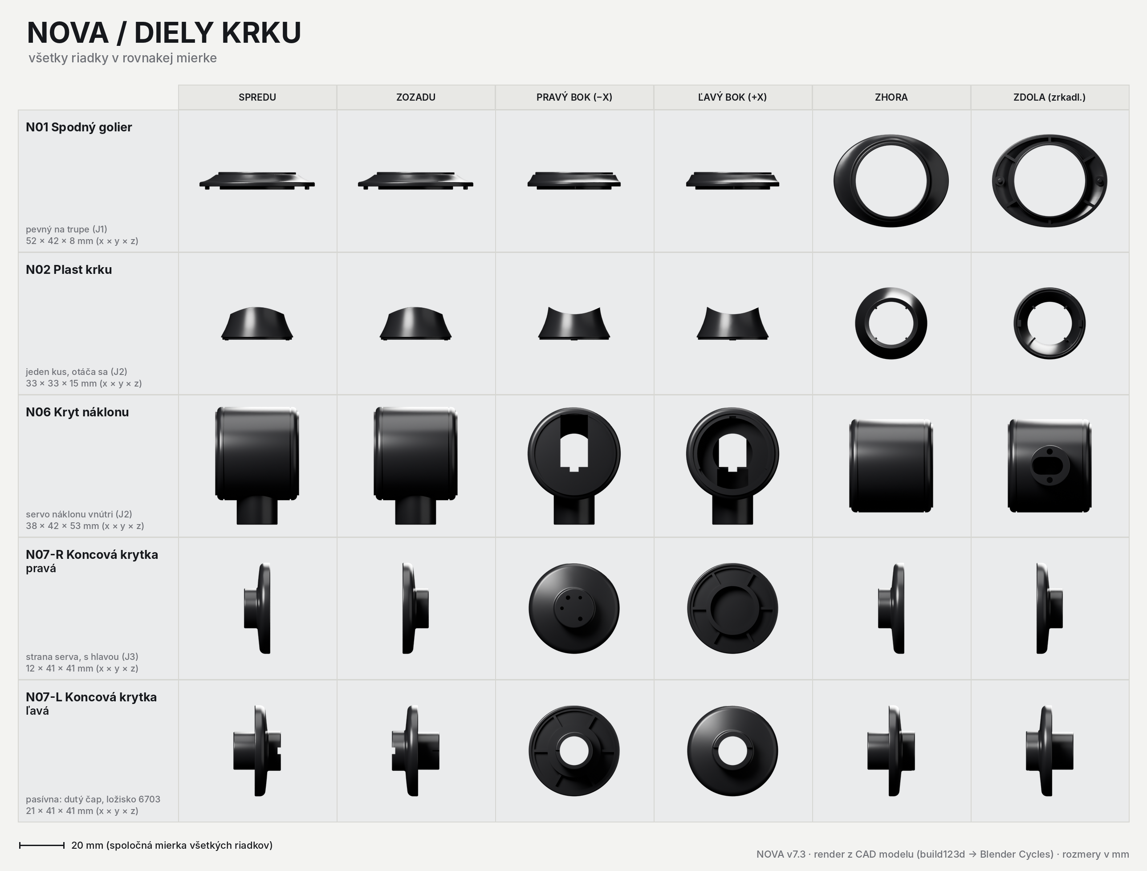
obrazky/10_NOVA_kryty_krku.png
