2jkbr252t7-debug/Robot/obrazky/11_NOVA_trup.png

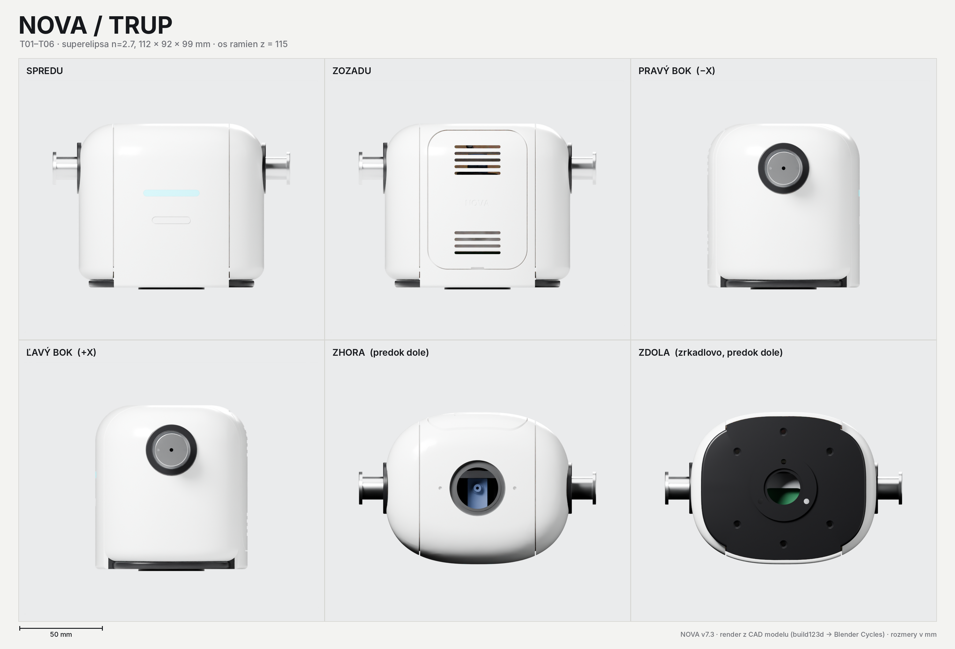
obrazky/11_NOVA_trup.png
