2jkbr252t7-debug/Robot/obrazky/12_NOVA_kryty_trupu.png

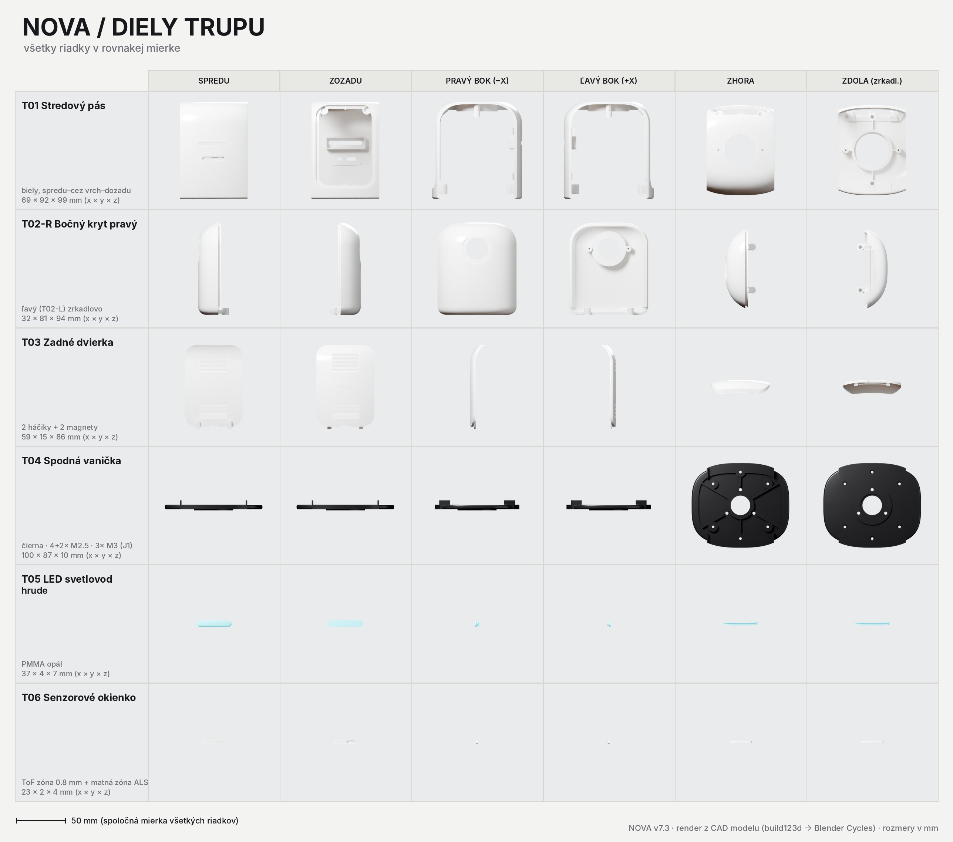
obrazky/12_NOVA_kryty_trupu.png
