2jkbr252t7-debug/Robot/obrazky/13_NOVA_prava_ruka.png

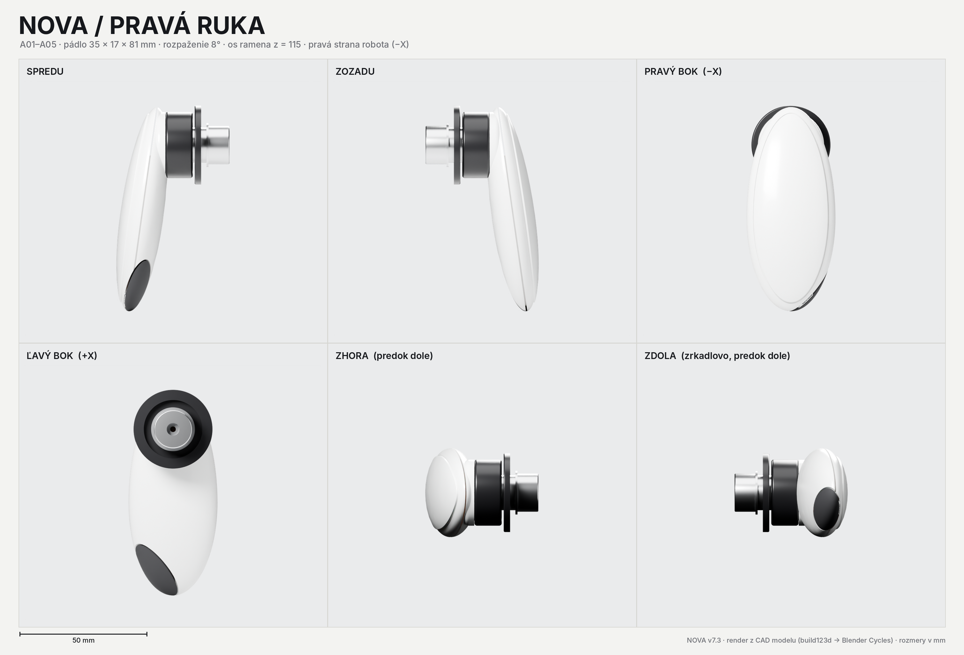
obrazky/13_NOVA_prava_ruka.png
