2jkbr252t7-debug/Robot/obrazky/14_NOVA_lava_ruka.png

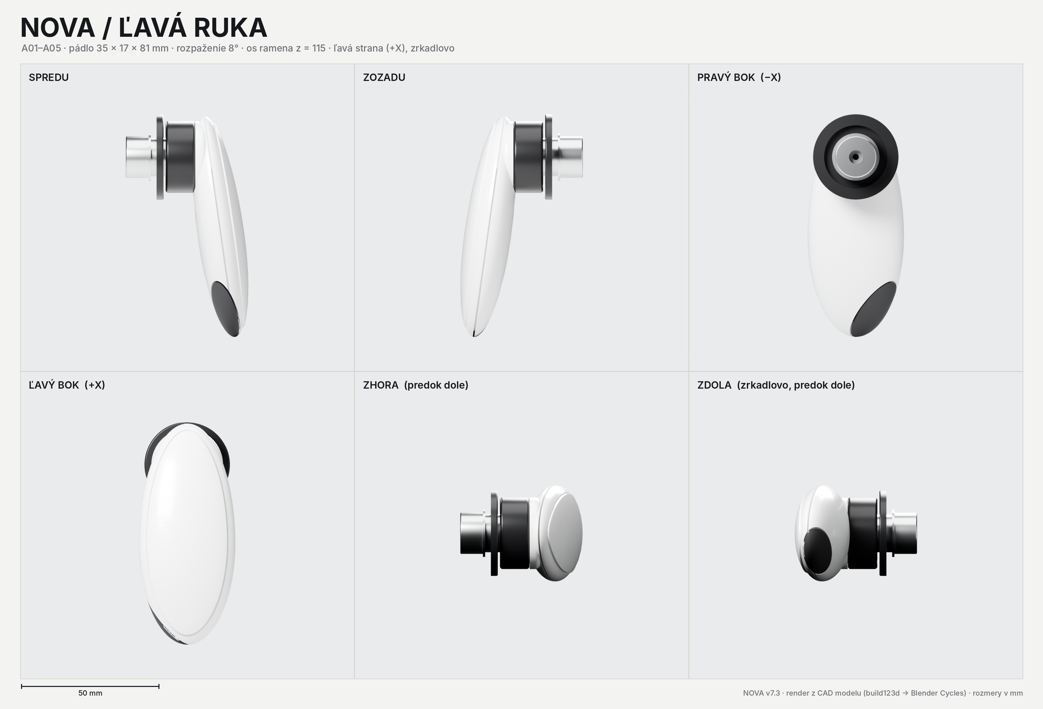
obrazky/14_NOVA_lava_ruka.png
