2jkbr252t7-debug/Robot/obrazky/15_NOVA_diely_ruky.png

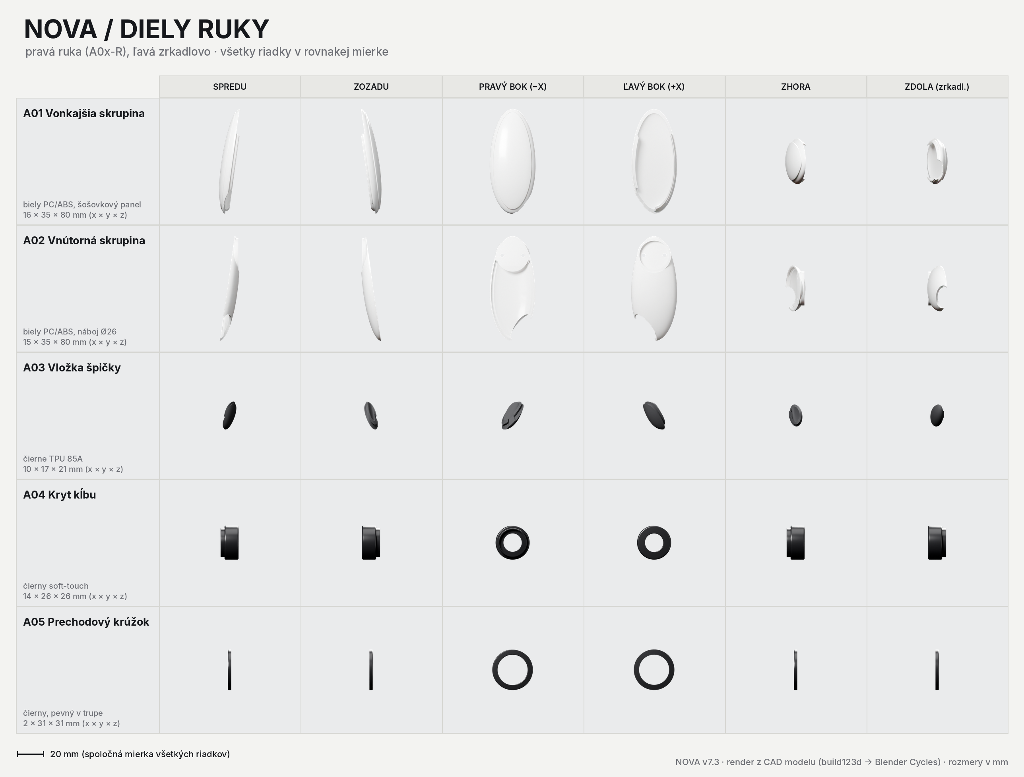
obrazky/15_NOVA_diely_ruky.png
