2jkbr252t7-debug/Robot/obrazky/16_NOVA_ruka_skladanie.png

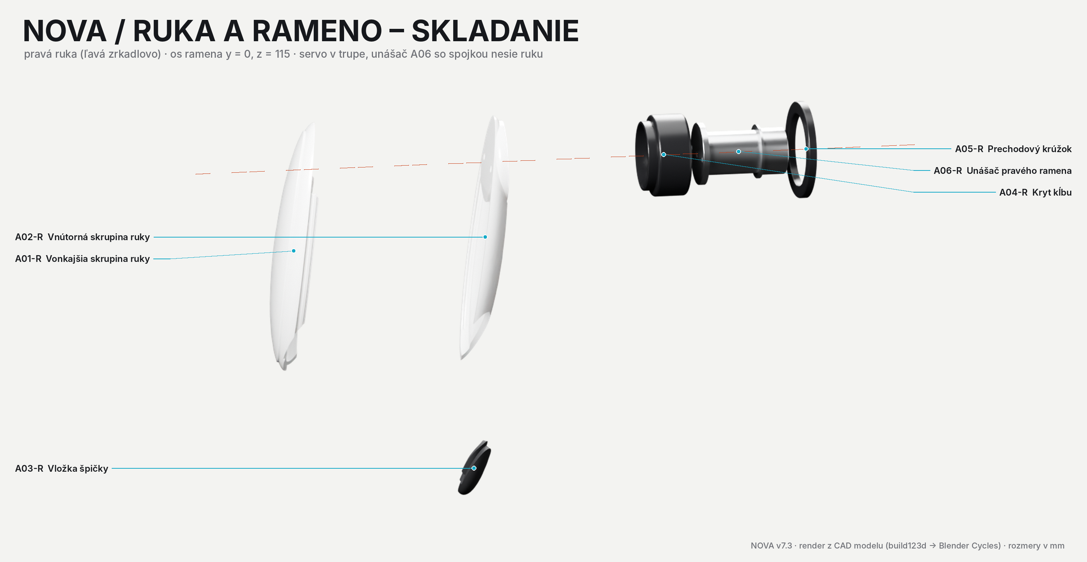
obrazky/16_NOVA_ruka_skladanie.png
