2jkbr252t7-debug/Robot/obrazky/17_NOVA_zakladna.png

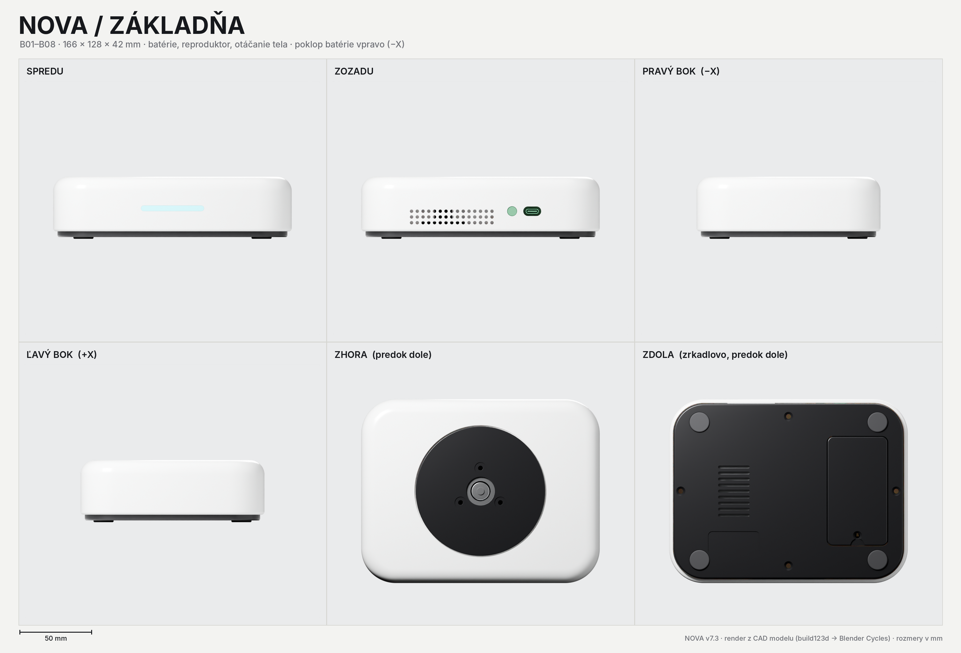
obrazky/17_NOVA_zakladna.png
