2jkbr252t7-debug/Robot/obrazky/18_NOVA_kryty_zakladne.png

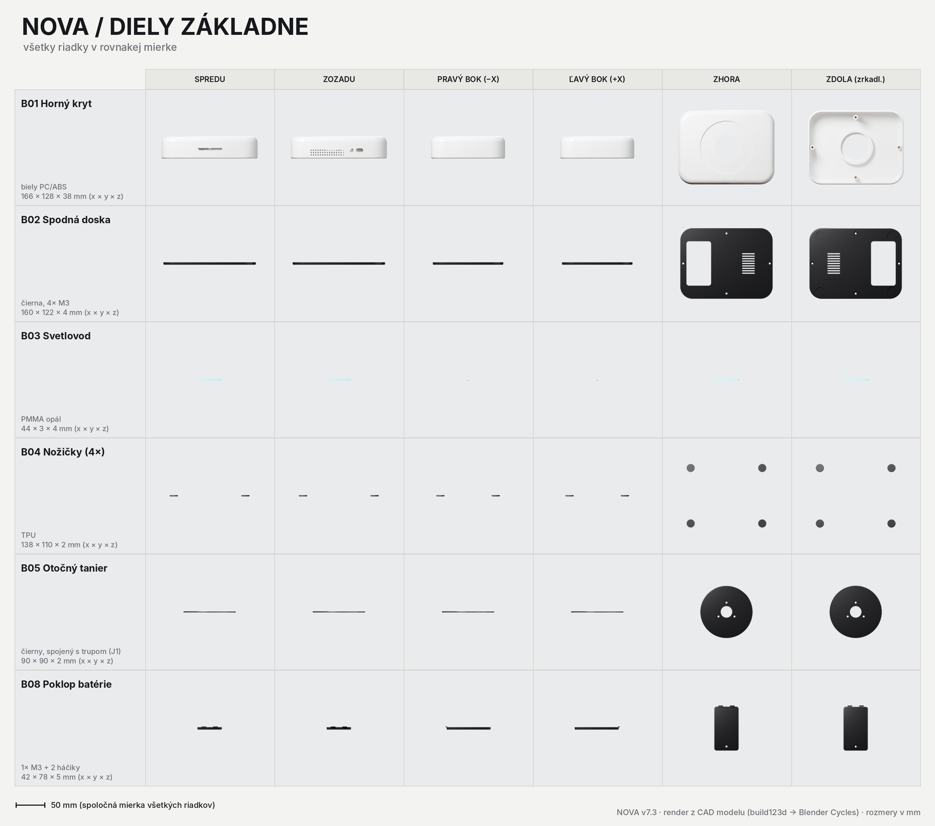
obrazky/18_NOVA_kryty_zakladne.png
