2jkbr252t7-debug/Robot/obrazky/19_NOVA_vnutorna_elektronika.png

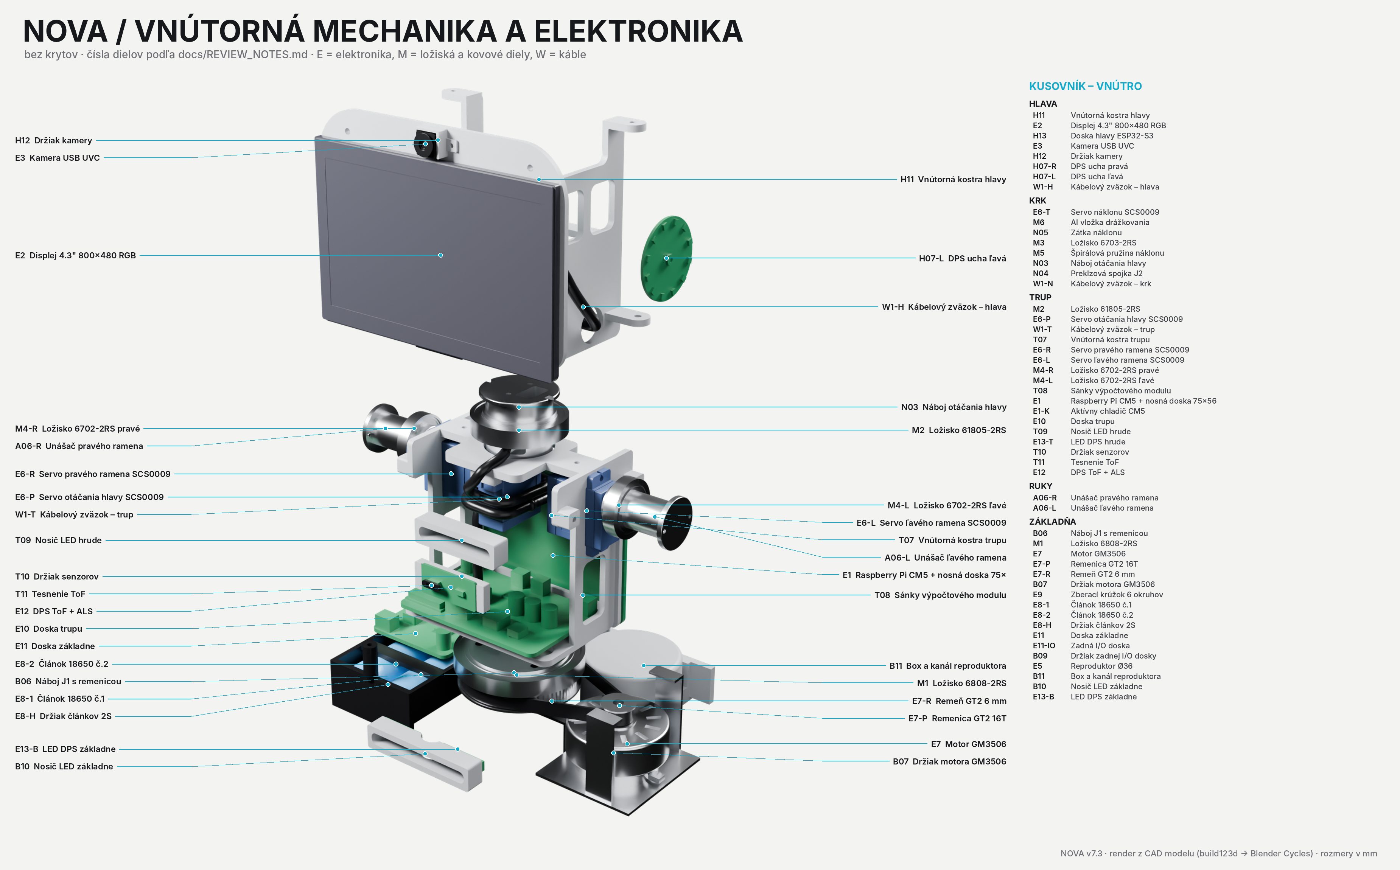
obrazky/19_NOVA_vnutorna_elektronika.png
