2jkbr252t7-debug/Robot/obrazky/20_NOVA_displej_vyrazy.png

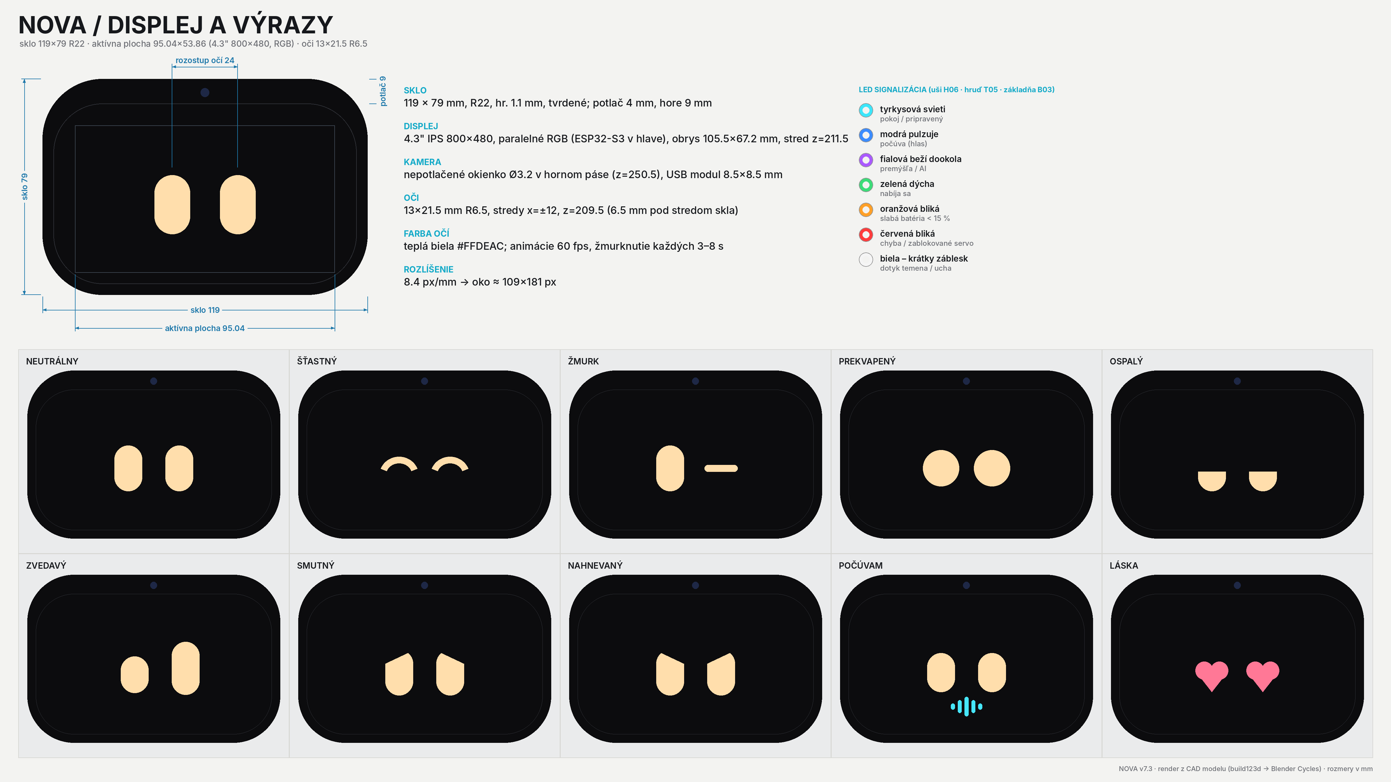
obrazky/20_NOVA_displej_vyrazy.png
