2jkbr252t7-debug/Robot/obrazky/21_NOVA_porovnanie_so_zadanim.png

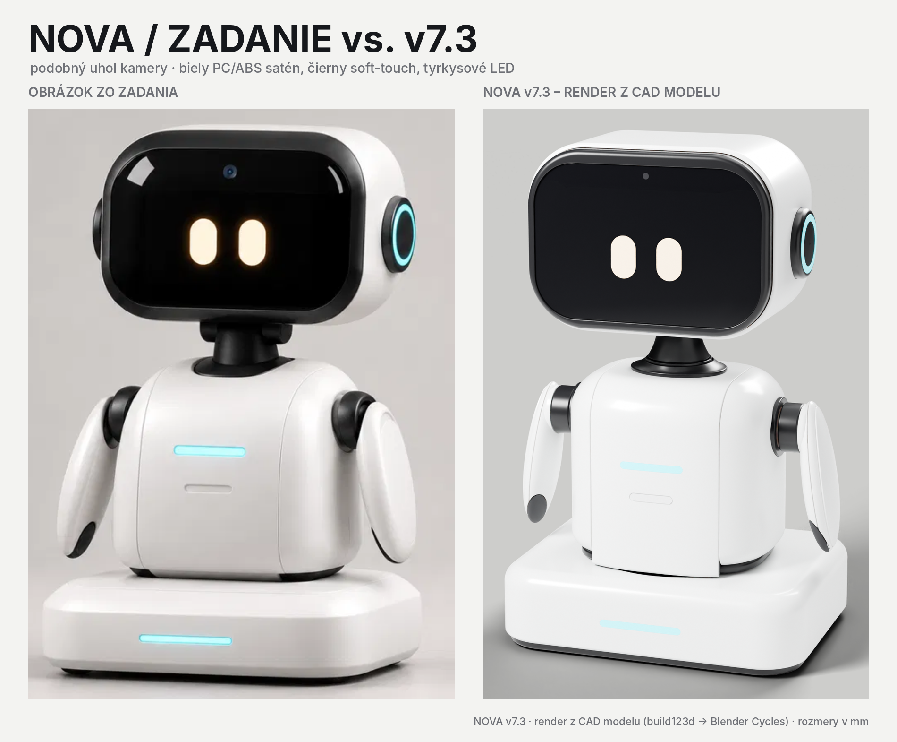
obrazky/21_NOVA_porovnanie_so_zadanim.png
