2jkbr252t7-debug/Robot/obrazky/postupne/01_hlava_skrupina/NOVA_mini_01_hlava_skrupina.png

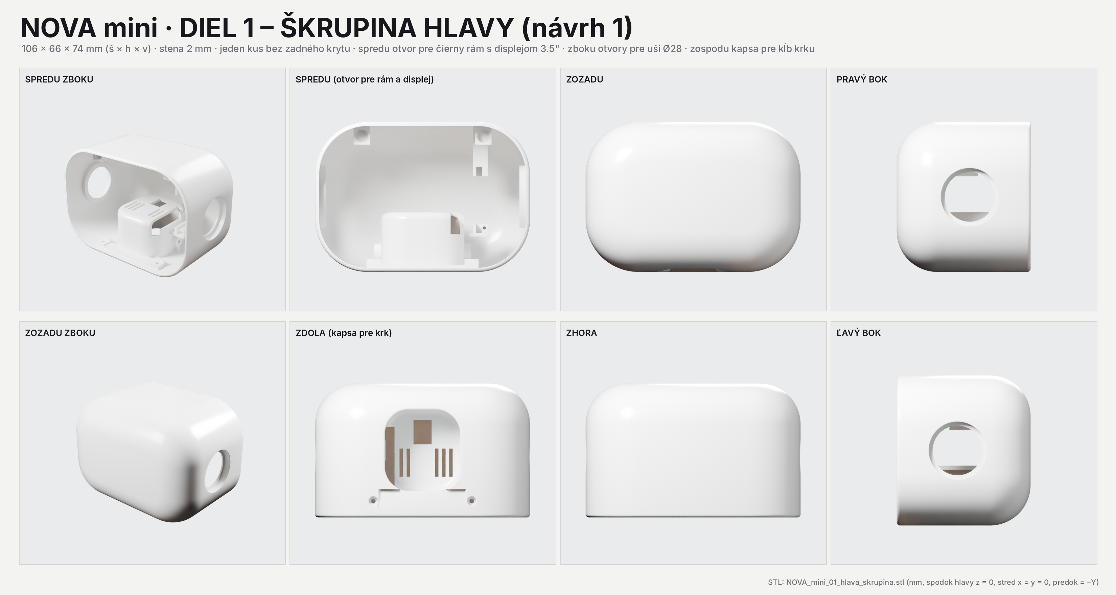
obrazky/postupne/01_hlava_skrupina/NOVA_mini_01_hlava_skrupina.png
