2jkbr252t7-debug/Robot/obrazky/postupne/01_hlava_skrupina/NOVA_mini_01_hlava_skrupina_navrh3.png

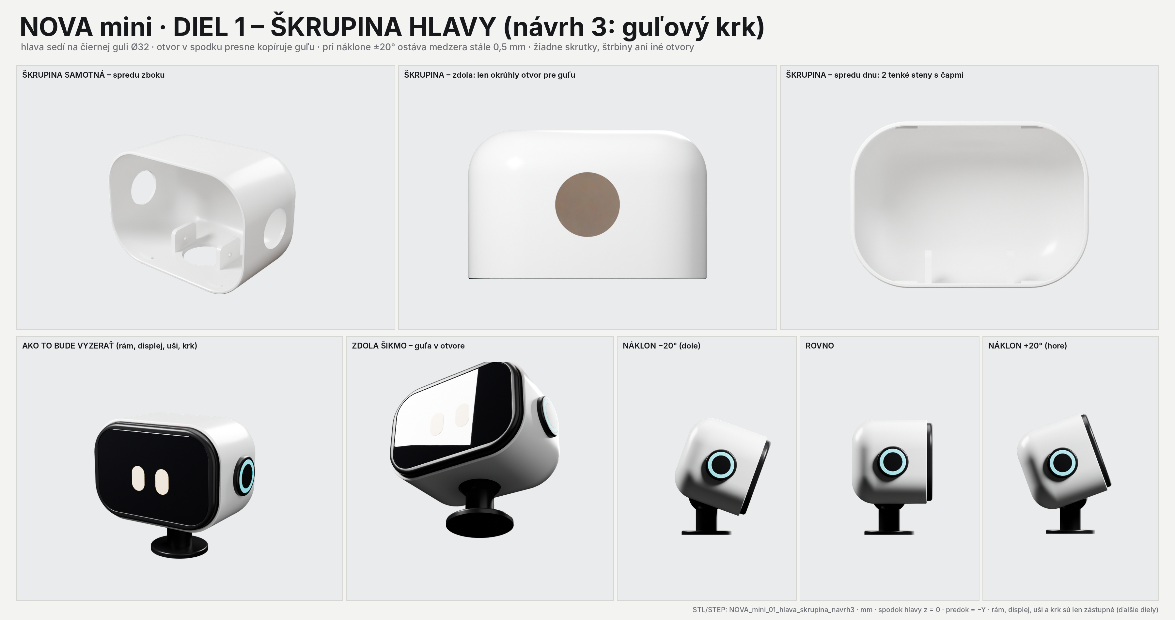
obrazky/postupne/01_hlava_skrupina/NOVA_mini_01_hlava_skrupina_navrh3.png
