2jkbr252t7-debug/Robot/obrazky/postupne/01_hlava_skrupina/NOVA_mini_krk_3_moznosti.png

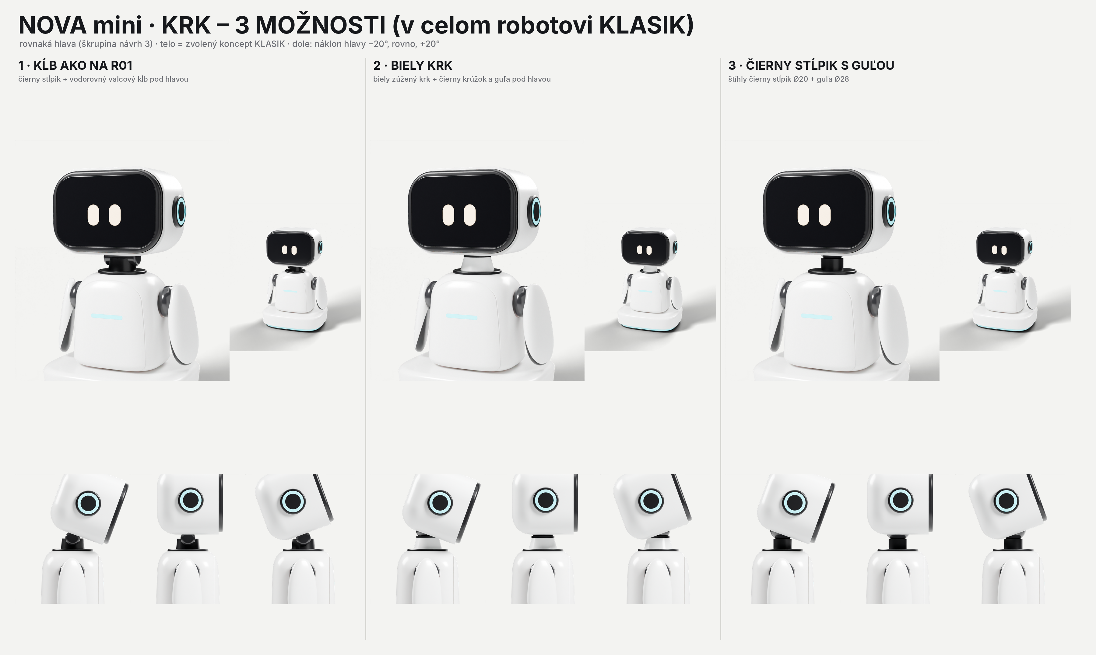
obrazky/postupne/01_hlava_skrupina/NOVA_mini_krk_3_moznosti.png
