2jkbr252t7-debug/Robot/obrazky/postupne/01_hlava_skrupina/NOVA_mini_krk_plynuly.png

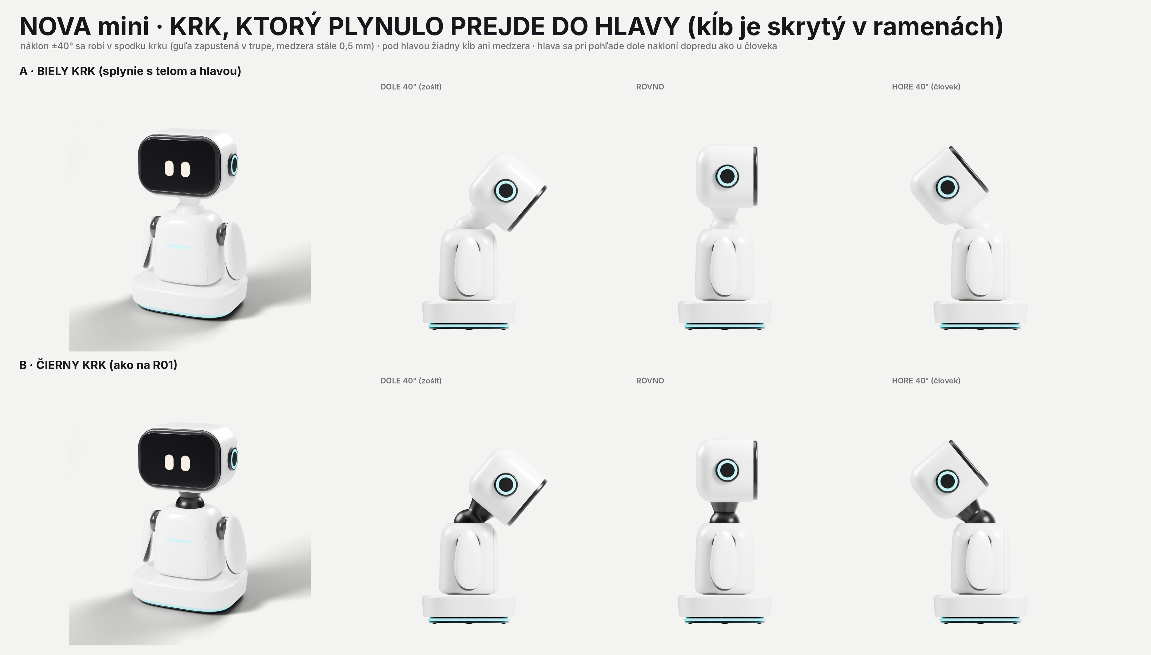
obrazky/postupne/01_hlava_skrupina/NOVA_mini_krk_plynuly.png
