2jkbr252t7-debug/Robot/obrazky/postupne/01_hlava_skrupina/NOVA_mini_naklon_40.png

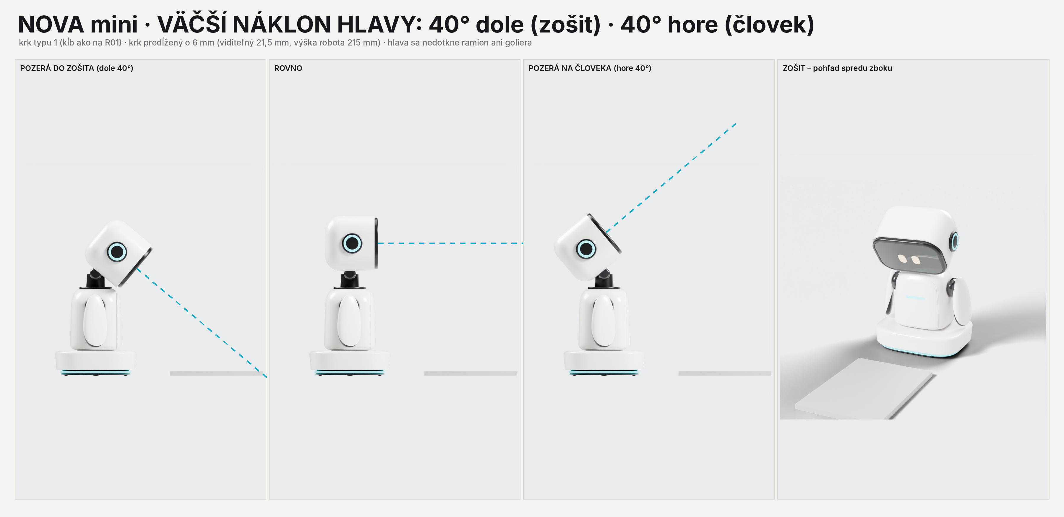
obrazky/postupne/01_hlava_skrupina/NOVA_mini_naklon_40.png
