2jkbr252t7-debug/Robot/obrazky/postupne/02_krk/NOVA_mini_krk_1_jeden_diel_vs_R04.png

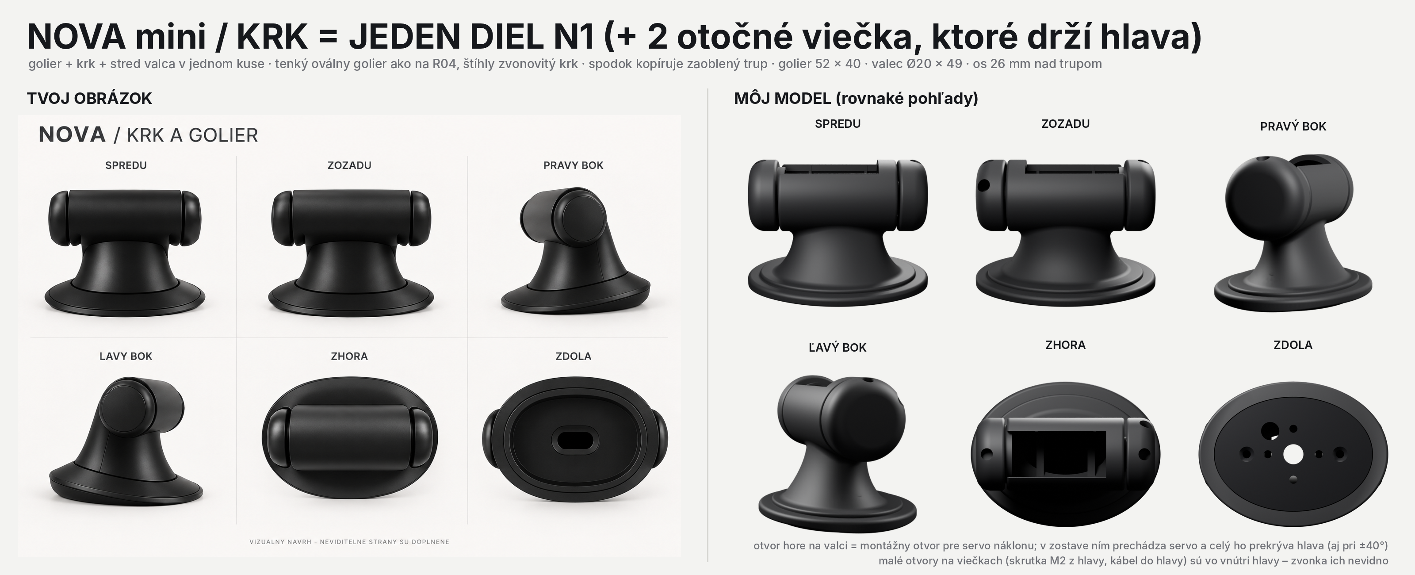
obrazky/postupne/02_krk/NOVA_mini_krk_1_jeden_diel_vs_R04.png
