2jkbr252t7-debug/Robot/obrazky/postupne/02_krk/NOVA_mini_krk_2_mechanizmus_naklonu.png

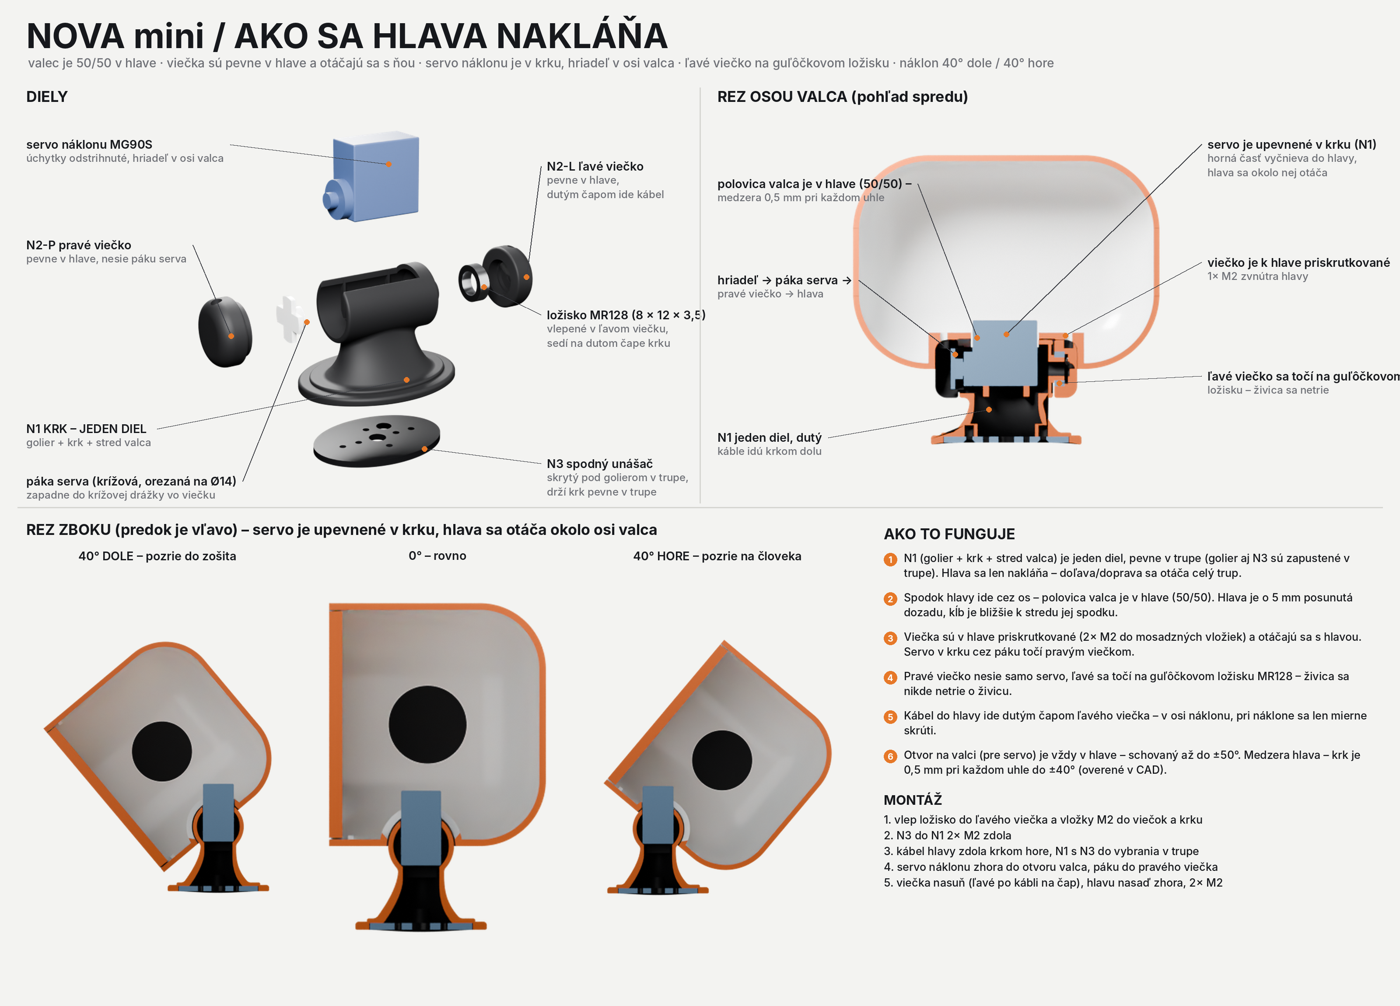
obrazky/postupne/02_krk/NOVA_mini_krk_2_mechanizmus_naklonu.png
