2jkbr252t7-debug/Robot/obrazky/postupne/02_krk/NOVA_mini_krk_3_naklon_na_robotovi.png

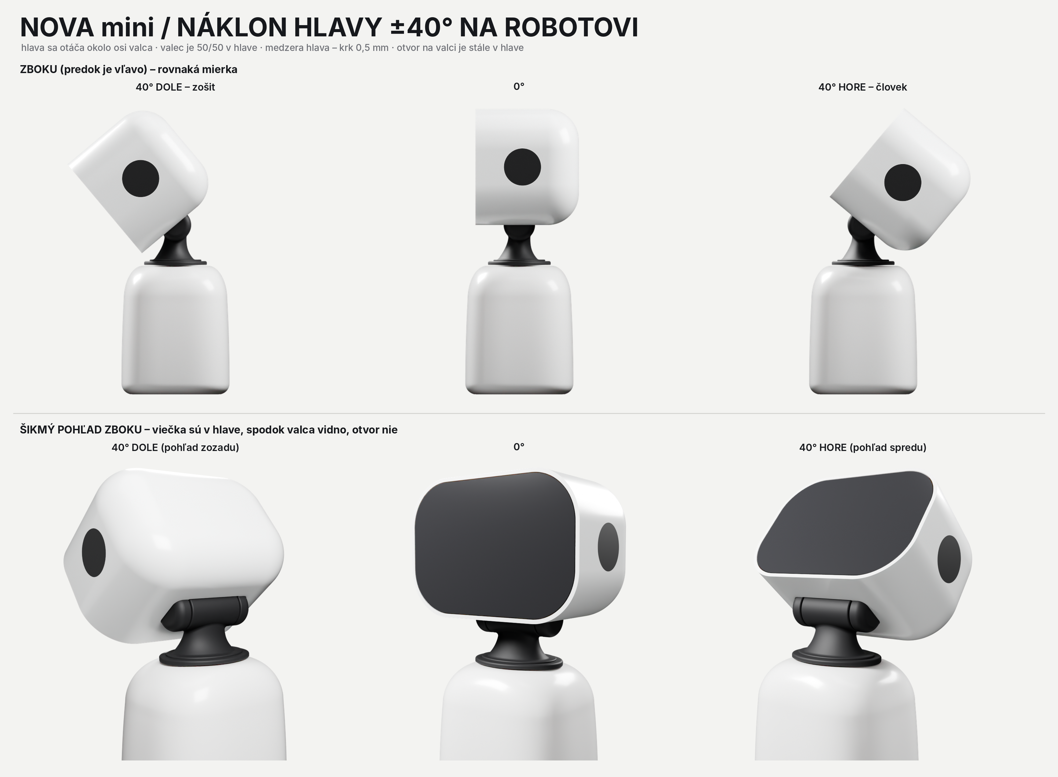
obrazky/postupne/02_krk/NOVA_mini_krk_3_naklon_na_robotovi.png
