2jkbr252t7-debug/Robot/obrazky/postupne/02_krk/NOVA_mini_krk_4_zapusteny_v_trupe.png

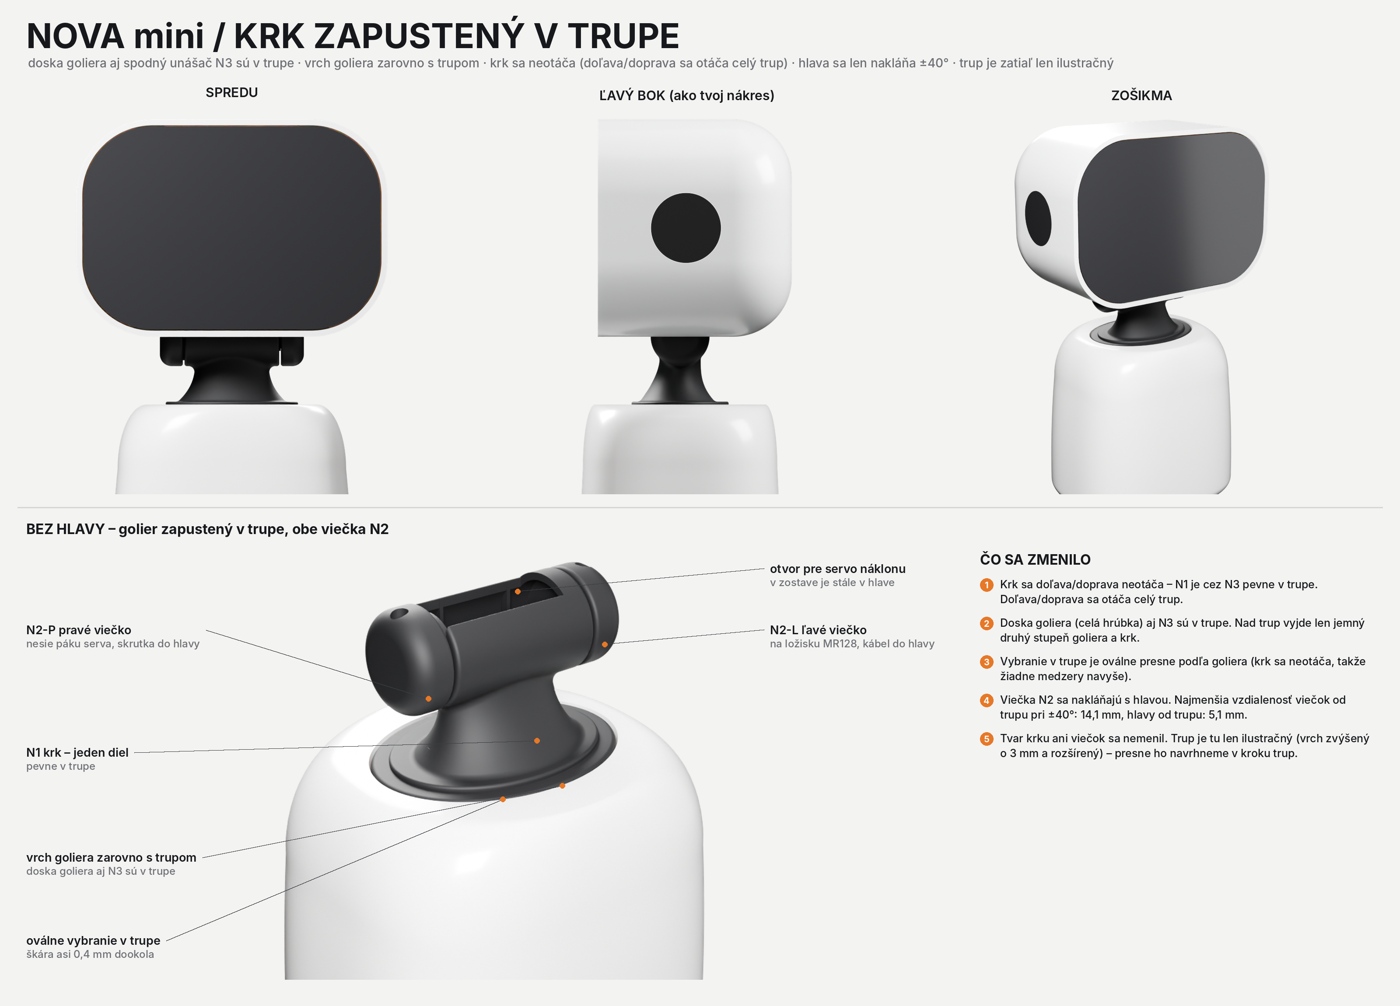
obrazky/postupne/02_krk/NOVA_mini_krk_4_zapusteny_v_trupe.png
