2jkbr252t7-debug/Robot/obrazky/postupne/02_krk/NOVA_mini_krk_5_koncept_otacanie_rychly.png

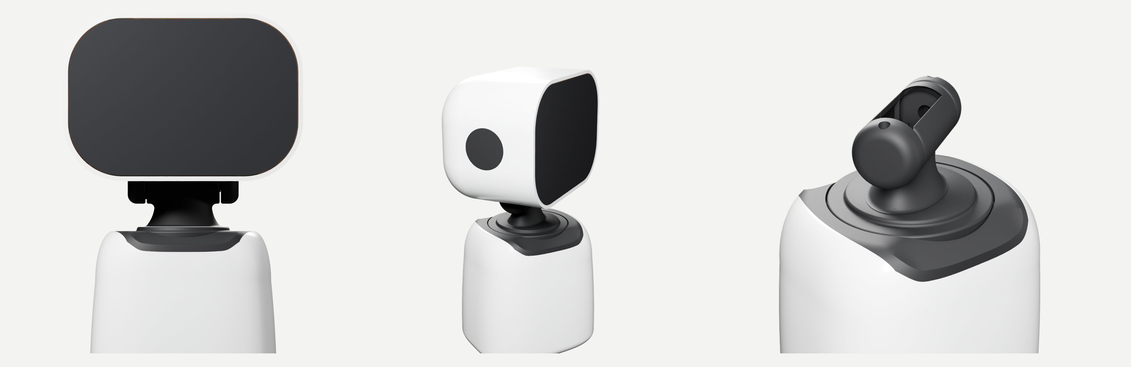
obrazky/postupne/02_krk/NOVA_mini_krk_5_koncept_otacanie_rychly.png
