2jkbr252t7-debug/Robot/obrazky/postupne/02_krk/NOVA_mini_krk_6_otocny_krk_rychly.png

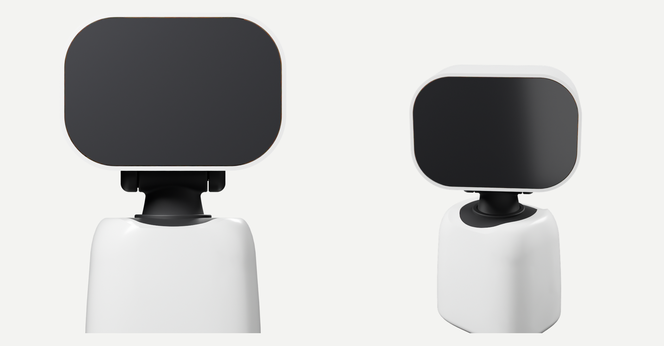
obrazky/postupne/02_krk/NOVA_mini_krk_6_otocny_krk_rychly.png
