2jkbr252t7-debug/Robot/obrazky/postupne/02_krk/NOVA_mini_krk_7_navrh_podla_nakresu.png

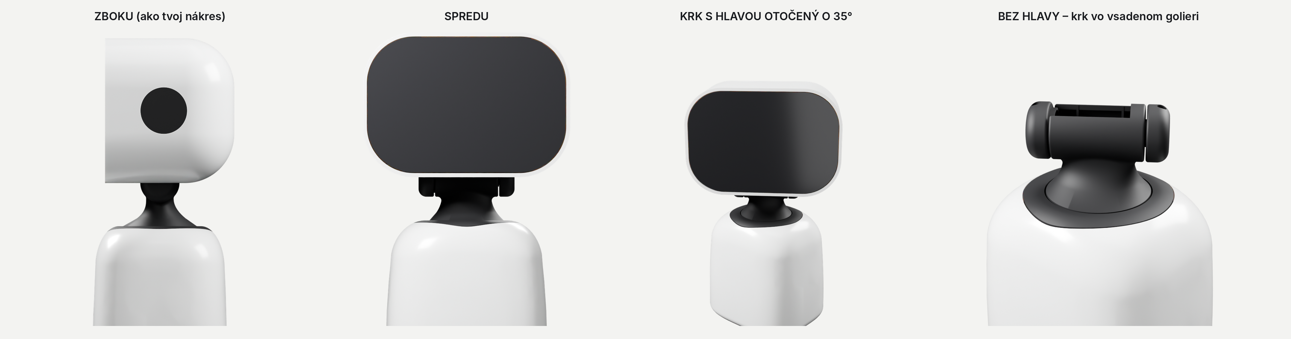
obrazky/postupne/02_krk/NOVA_mini_krk_7_navrh_podla_nakresu.png
