2jkbr252t7-debug/Robot/obrazky/postupne/02_krk/NOVA_mini_krk_8_vnutro_otocny_krk.png

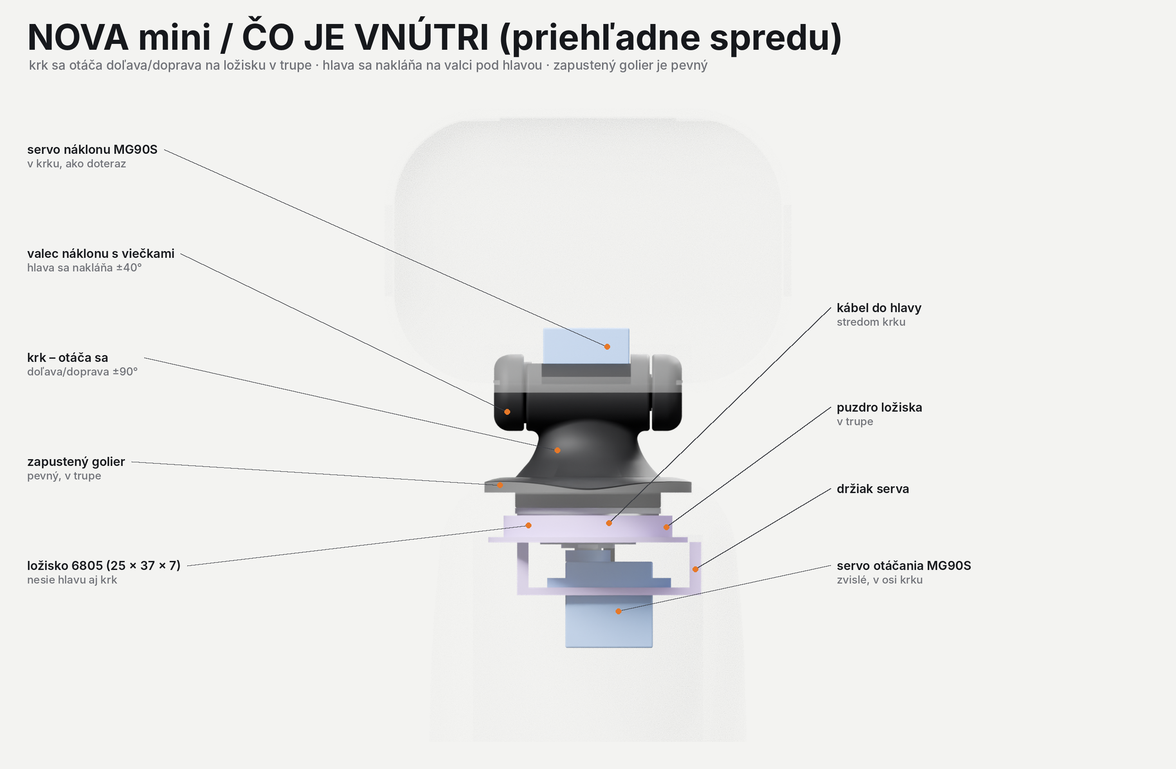
obrazky/postupne/02_krk/NOVA_mini_krk_8_vnutro_otocny_krk.png
