2jkbr252t7-debug/Robot/obrazky/postupne/02_krk/NOVA_mini_krk_9_uzsi_kuzelovy_krk.png

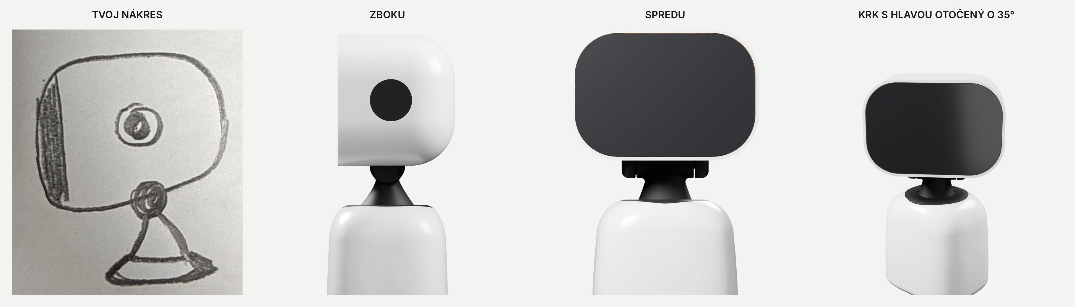
obrazky/postupne/02_krk/NOVA_mini_krk_9_uzsi_kuzelovy_krk.png
