2jkbr252t7-debug/Robot/obrazky/postupne/02_krk/NOVA_mini_krk_10_podla_nakresu_valec_mensi.png

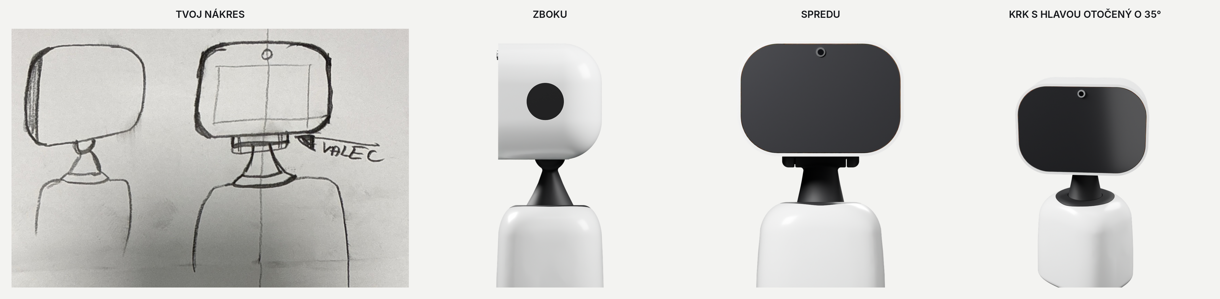
obrazky/postupne/02_krk/NOVA_mini_krk_10_podla_nakresu_valec_mensi.png
