2jkbr252t7-debug/Robot/obrazky/postupne/02_krk/NOVA_mini_krk_os_naklonu_2_moznosti.png

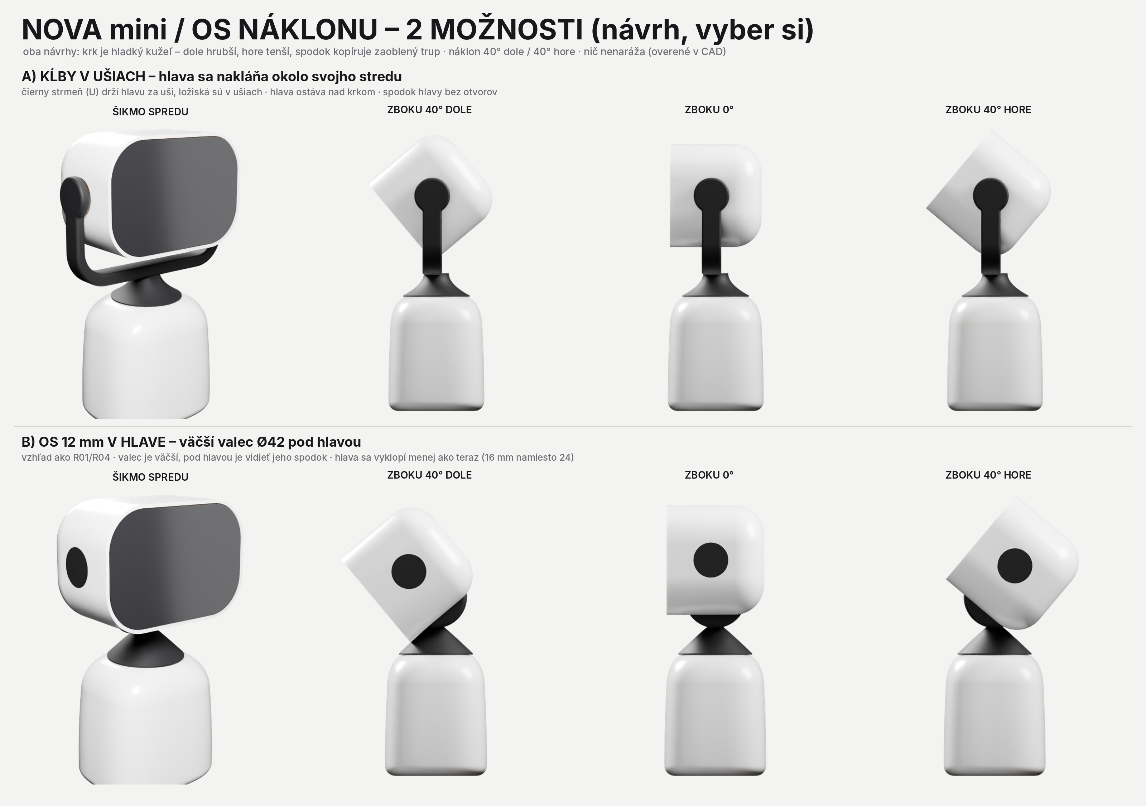
obrazky/postupne/02_krk/NOVA_mini_krk_os_naklonu_2_moznosti.png
