2jkbr252t7-debug/Robot/obrazky/postupne/02_krk_r04/NOVA_mini_krk_moj_model_ako_R04.png

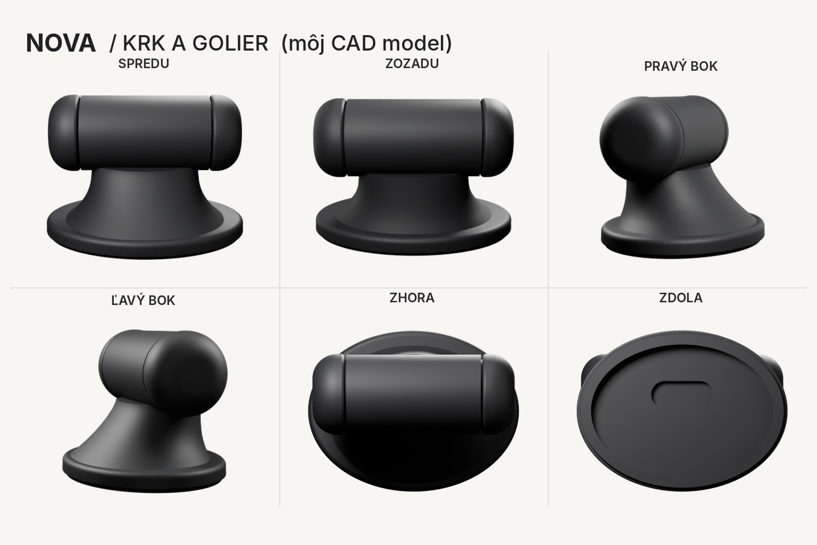
obrazky/postupne/02_krk_r04/NOVA_mini_krk_moj_model_ako_R04.png
