2jkbr252t7-debug/Robot/obrazky/postupne/02_krk_r04/NOVA_mini_krk_r04_na_robotovi.png

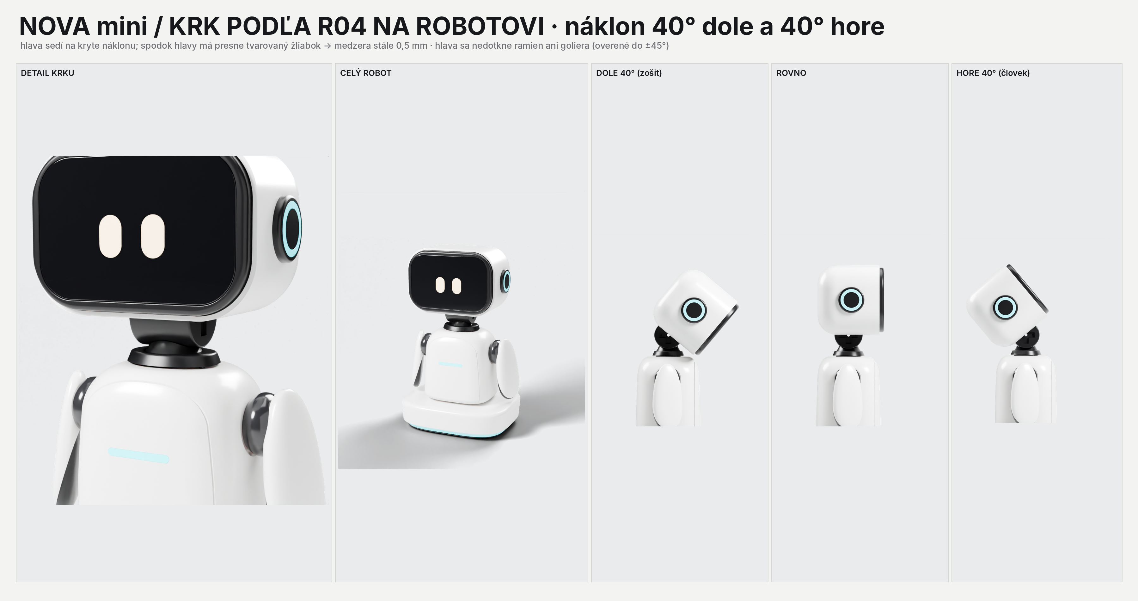
obrazky/postupne/02_krk_r04/NOVA_mini_krk_r04_na_robotovi.png
