2jkbr252t7-debug/Robot/obrazky/postupne/02_krk_r04/NOVA_mini_krk_vedla_seba.png

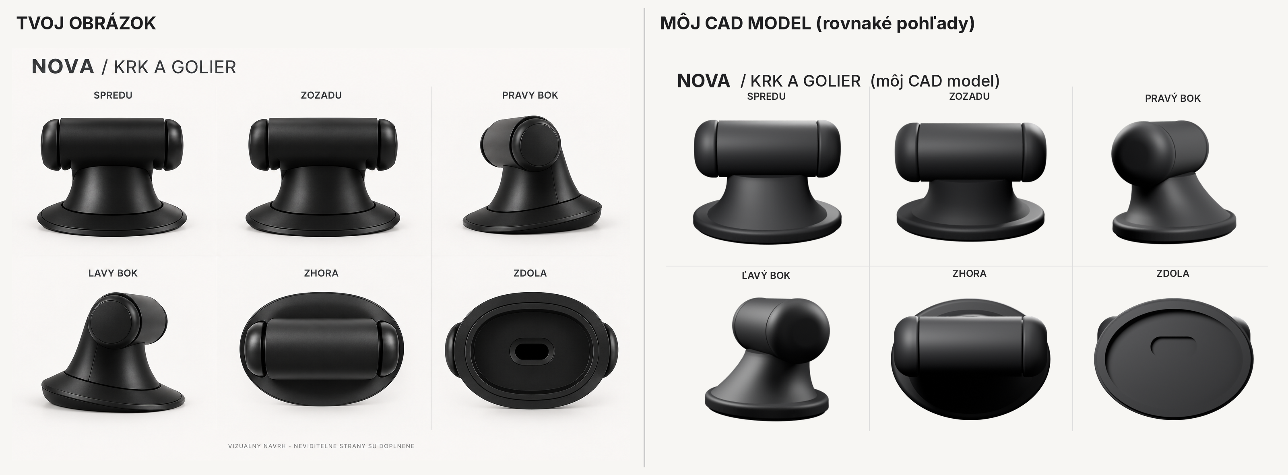
obrazky/postupne/02_krk_r04/NOVA_mini_krk_vedla_seba.png
