2jkbr252t7-debug/Robot/obrazky/postupne/03_koncept_otocny_krk/NOVA_mini_B_modul_displeja.png

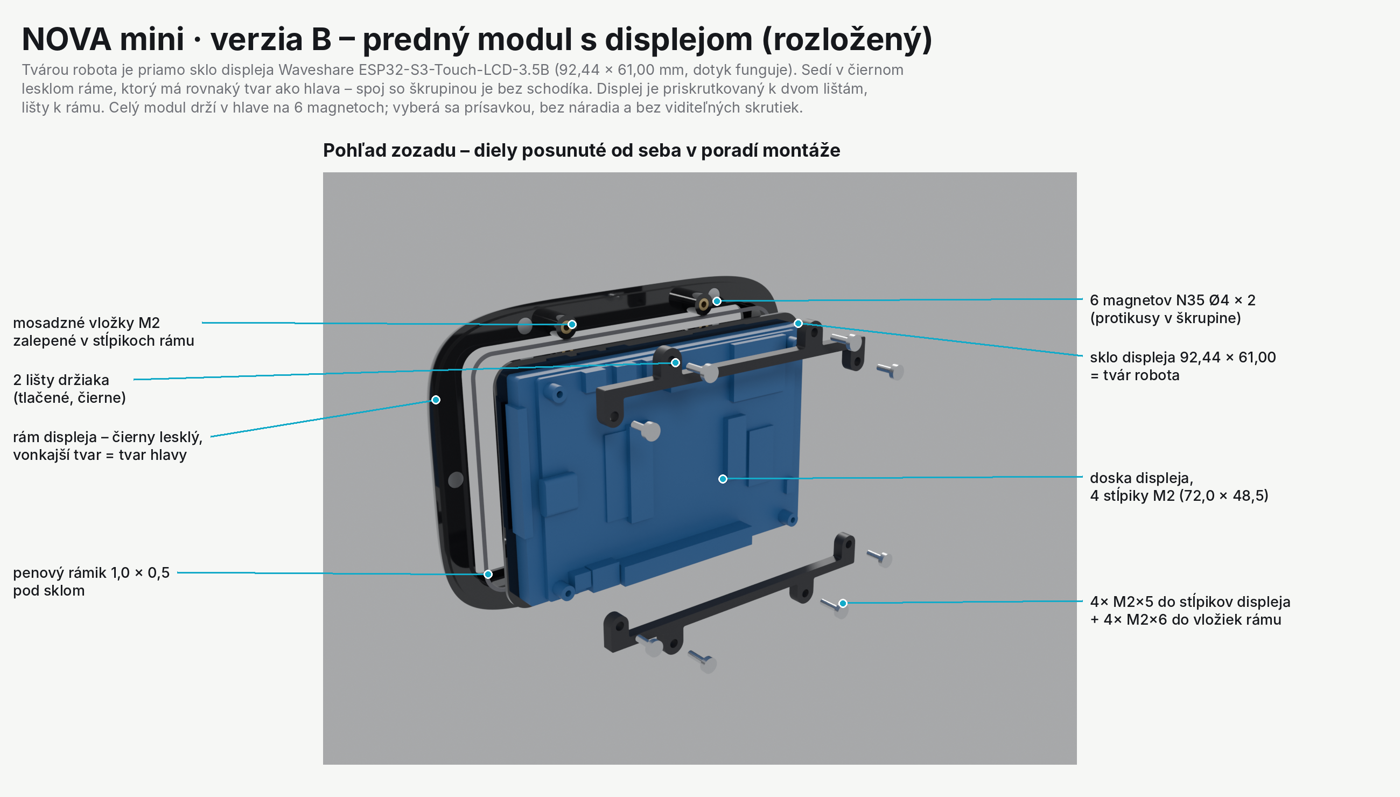
obrazky/postupne/03_koncept_otocny_krk/NOVA_mini_B_modul_displeja.png
