2jkbr252t7-debug/Robot/obrazky/postupne/03_koncept_otocny_krk/NOVA_mini_B_pant_co_drzi_co.png

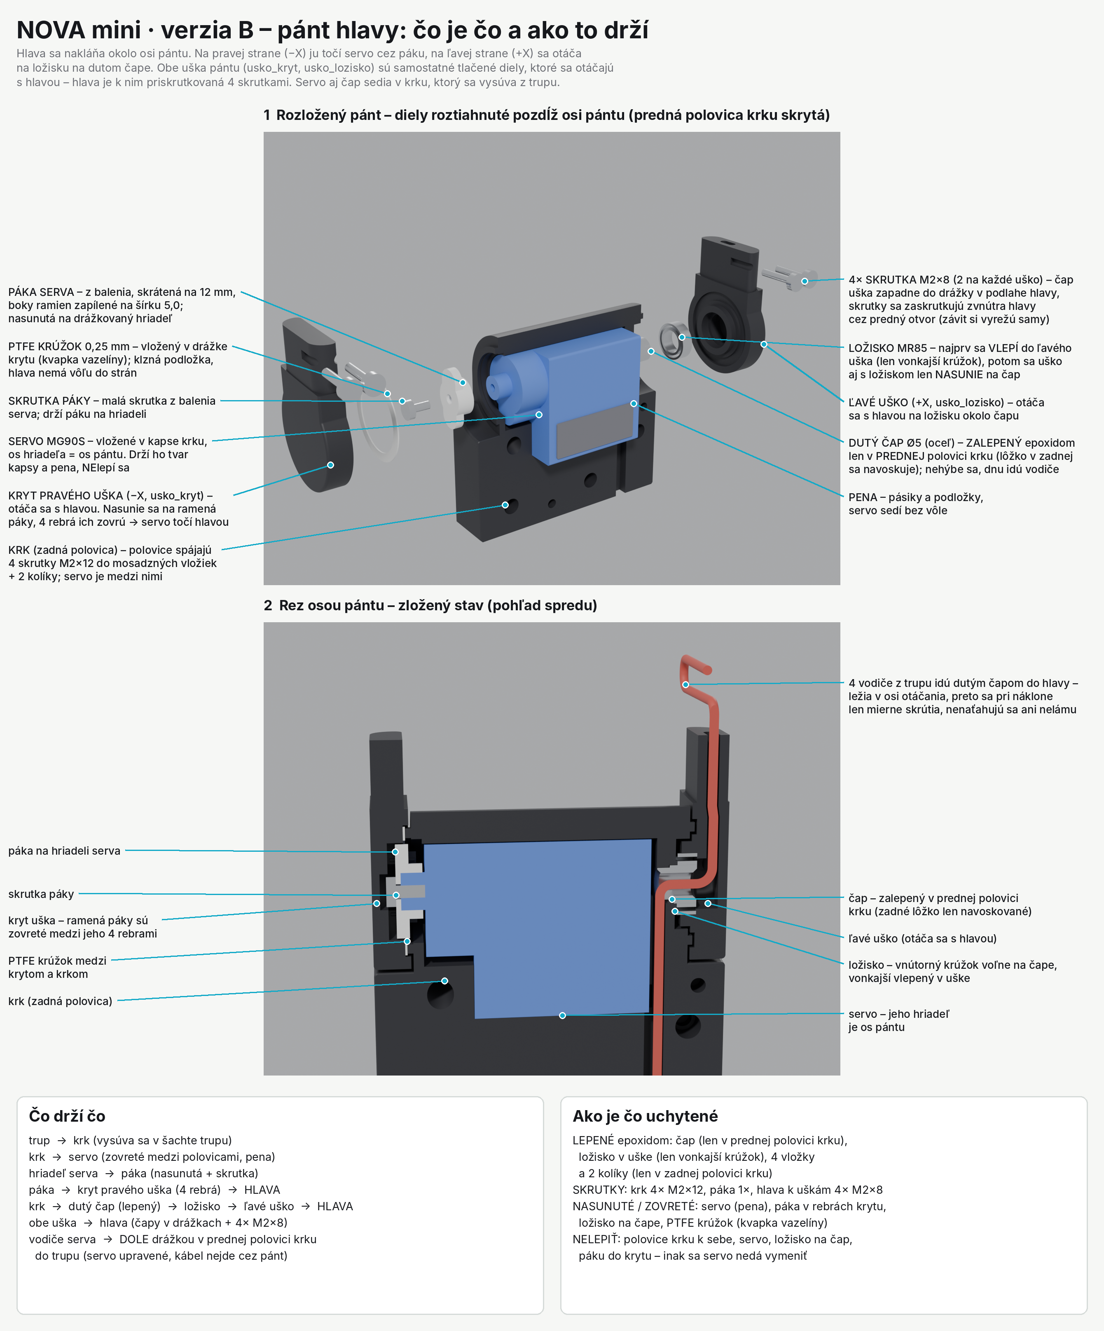
obrazky/postupne/03_koncept_otocny_krk/NOVA_mini_B_pant_co_drzi_co.png
