2jkbr252t7-debug/Robot/obrazky/postupne/03_koncept_otocny_krk/NOVA_mini_krk_3_male_medzery.png

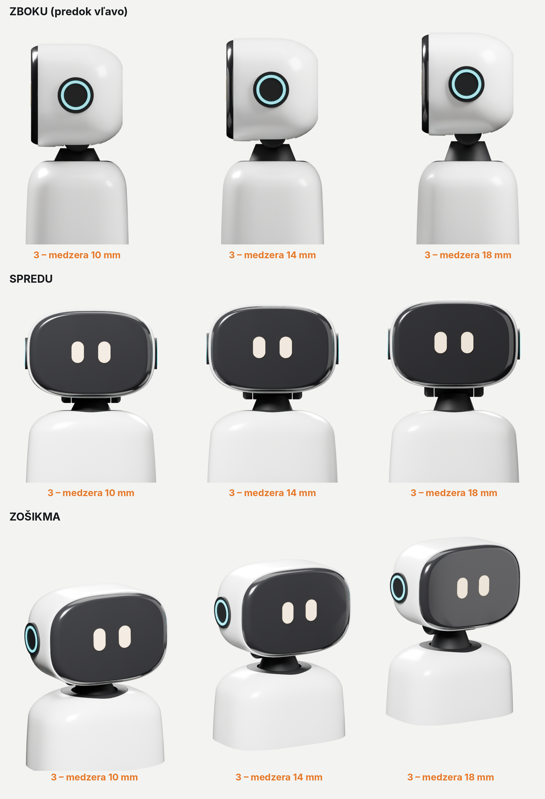
obrazky/postupne/03_koncept_otocny_krk/NOVA_mini_krk_3_male_medzery.png
