2jkbr252t7-debug/Robot/obrazky/postupne/03_koncept_otocny_krk/NOVA_mini_krk_A1_A2_C1_C2_D.png

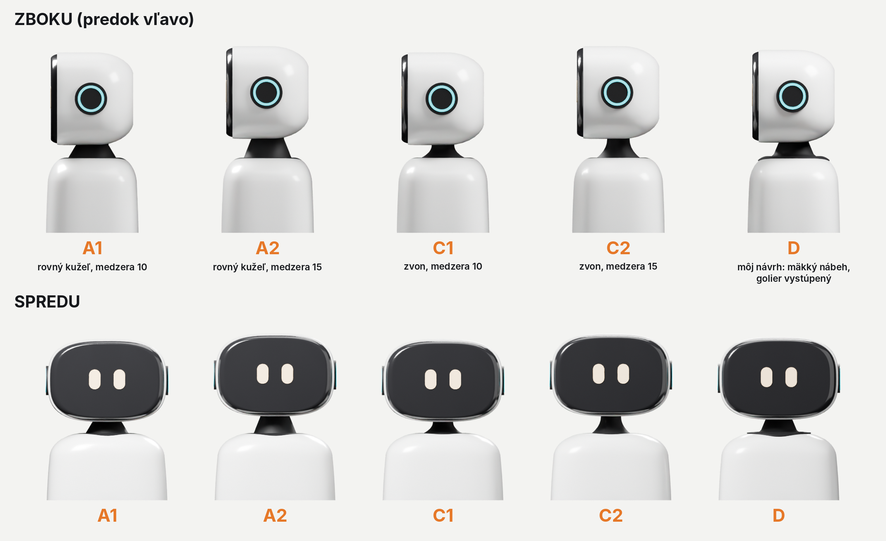
obrazky/postupne/03_koncept_otocny_krk/NOVA_mini_krk_A1_A2_C1_C2_D.png
