2jkbr252t7-debug/Robot/obrazky/postupne/03_koncept_otocny_krk/NOVA_mini_krk_B_pant_a_servo.png

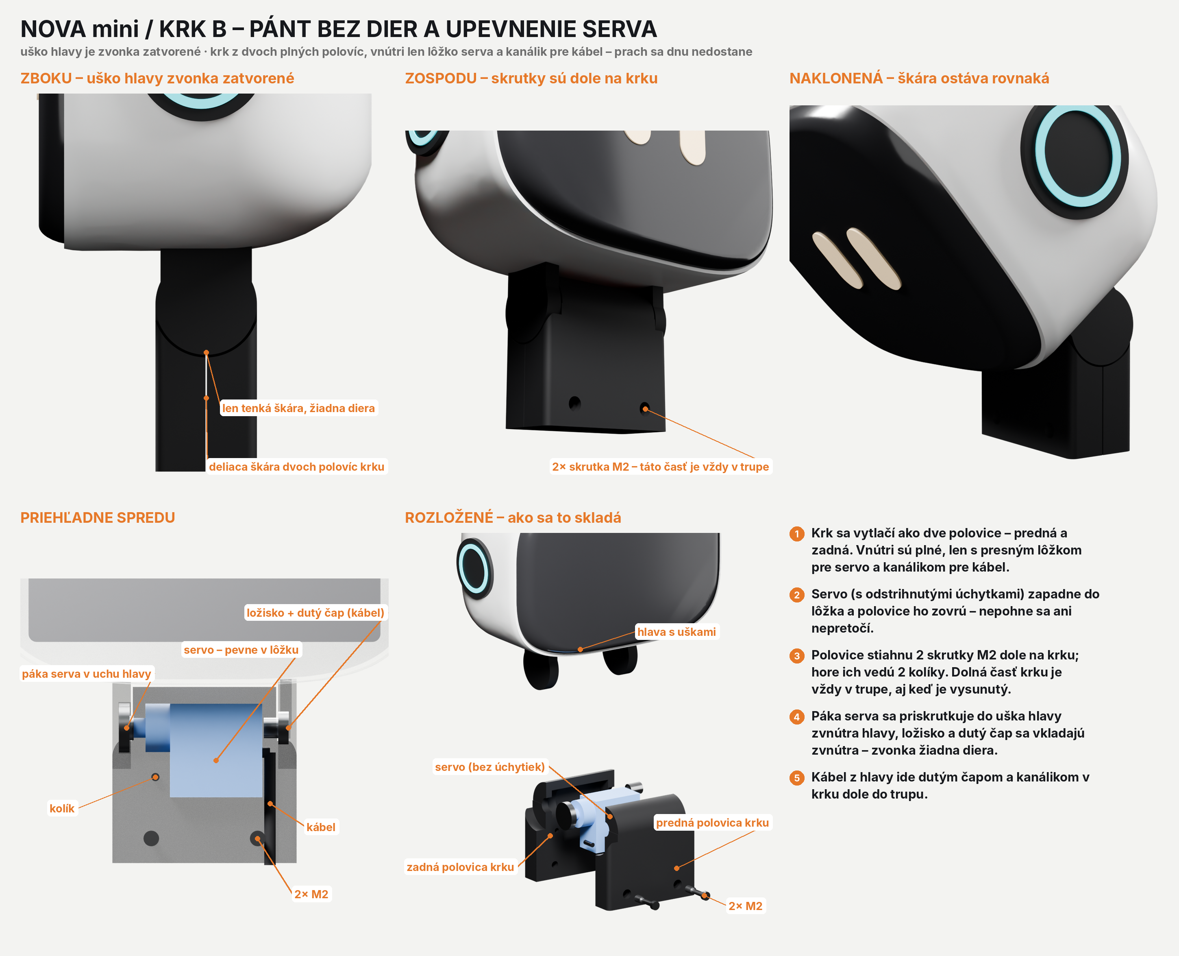
obrazky/postupne/03_koncept_otocny_krk/NOVA_mini_krk_B_pant_a_servo.png
