2jkbr252t7-debug/Robot/obrazky/postupne/03_koncept_otocny_krk/NOVA_mini_krk_dalsie_varianty_10mm.png

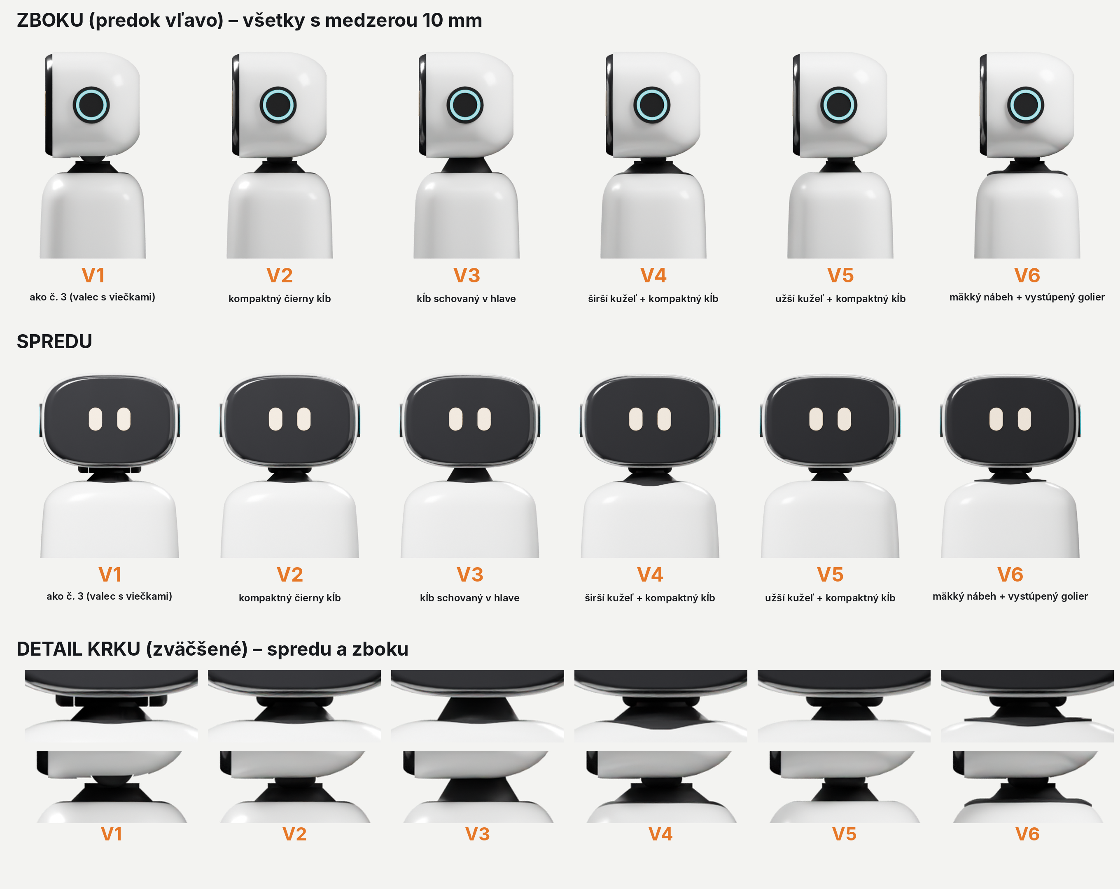
obrazky/postupne/03_koncept_otocny_krk/NOVA_mini_krk_dalsie_varianty_10mm.png
