2jkbr252t7-debug/Robot/obrazky/postupne/03_koncept_otocny_krk/NOVA_mini_krk_vidlica_loziska.png

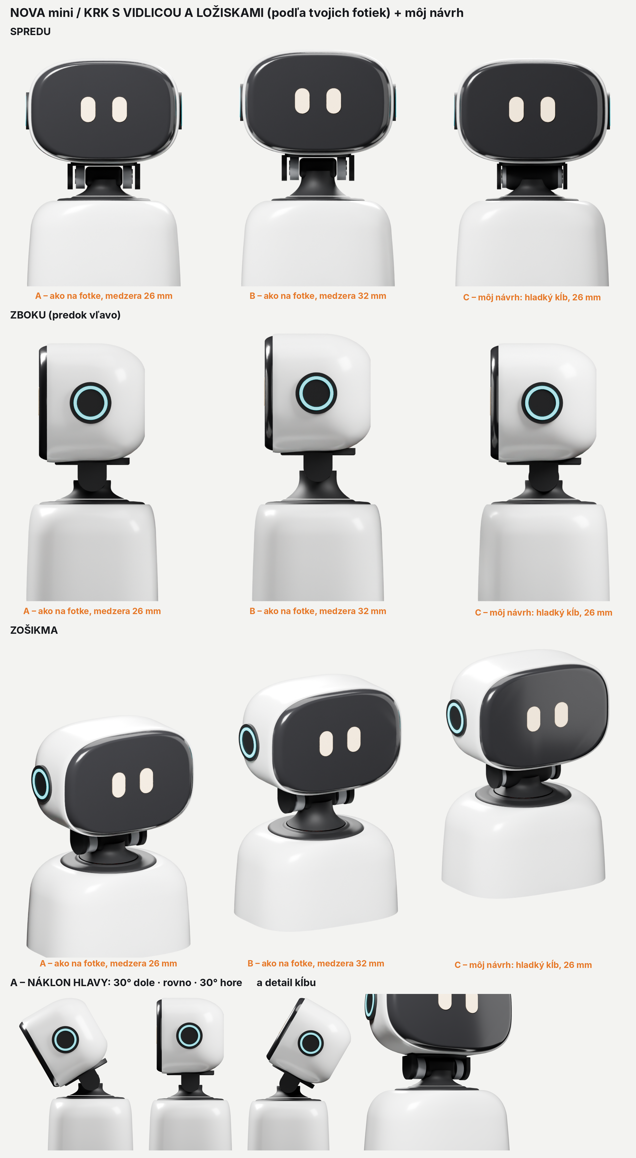
obrazky/postupne/03_koncept_otocny_krk/NOVA_mini_krk_vidlica_loziska.png
