2jkbr252t7-debug/Robot/obrazky/postupne/03_koncept_otocny_krk/NOVA_mini_novy_navrh_A_B.png

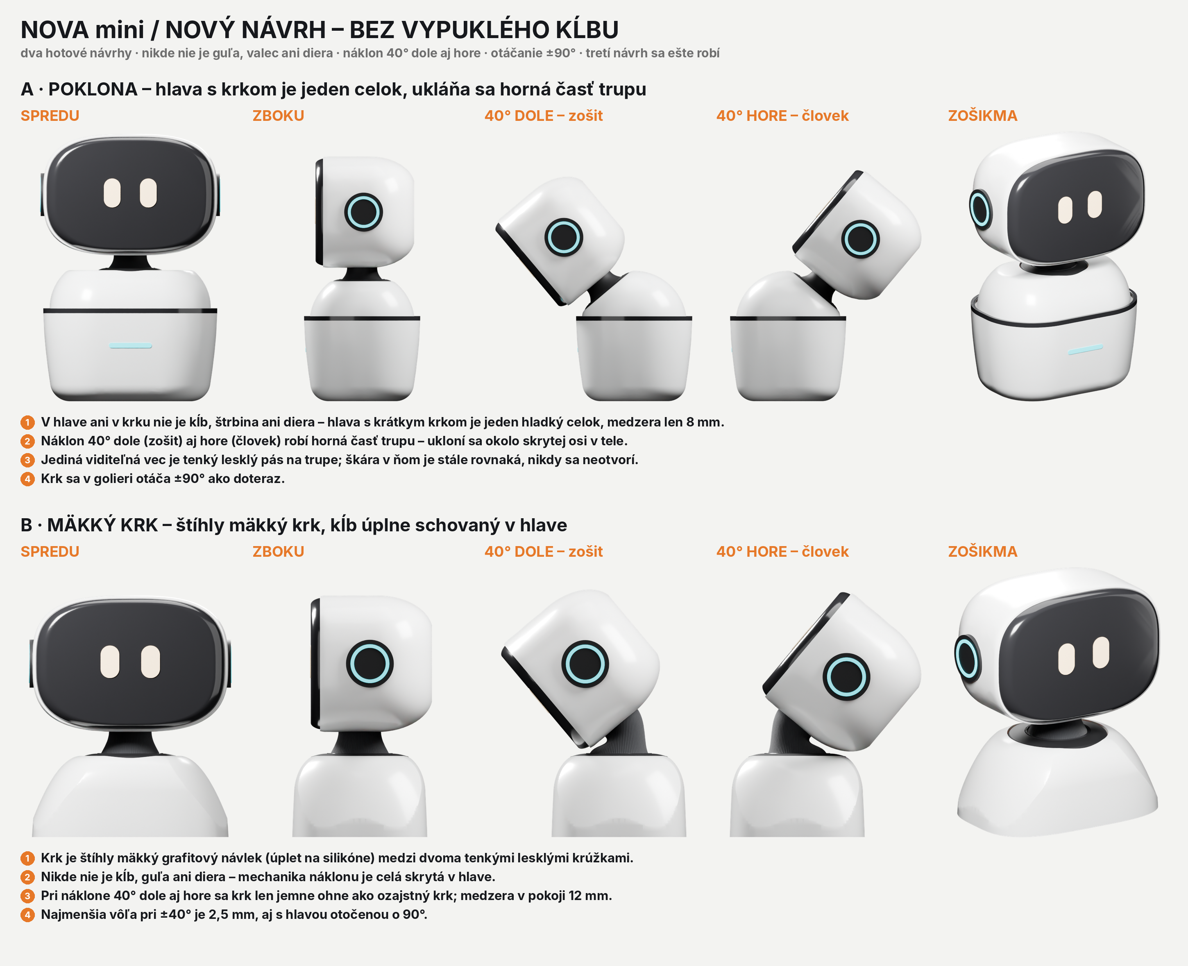
obrazky/postupne/03_koncept_otocny_krk/NOVA_mini_novy_navrh_A_B.png
