2jkbr252t7-debug/Robot/obrazky/postupne/03_koncept_otocny_krk/NOVA_mini_viditelny_klb_gula_olivka.png

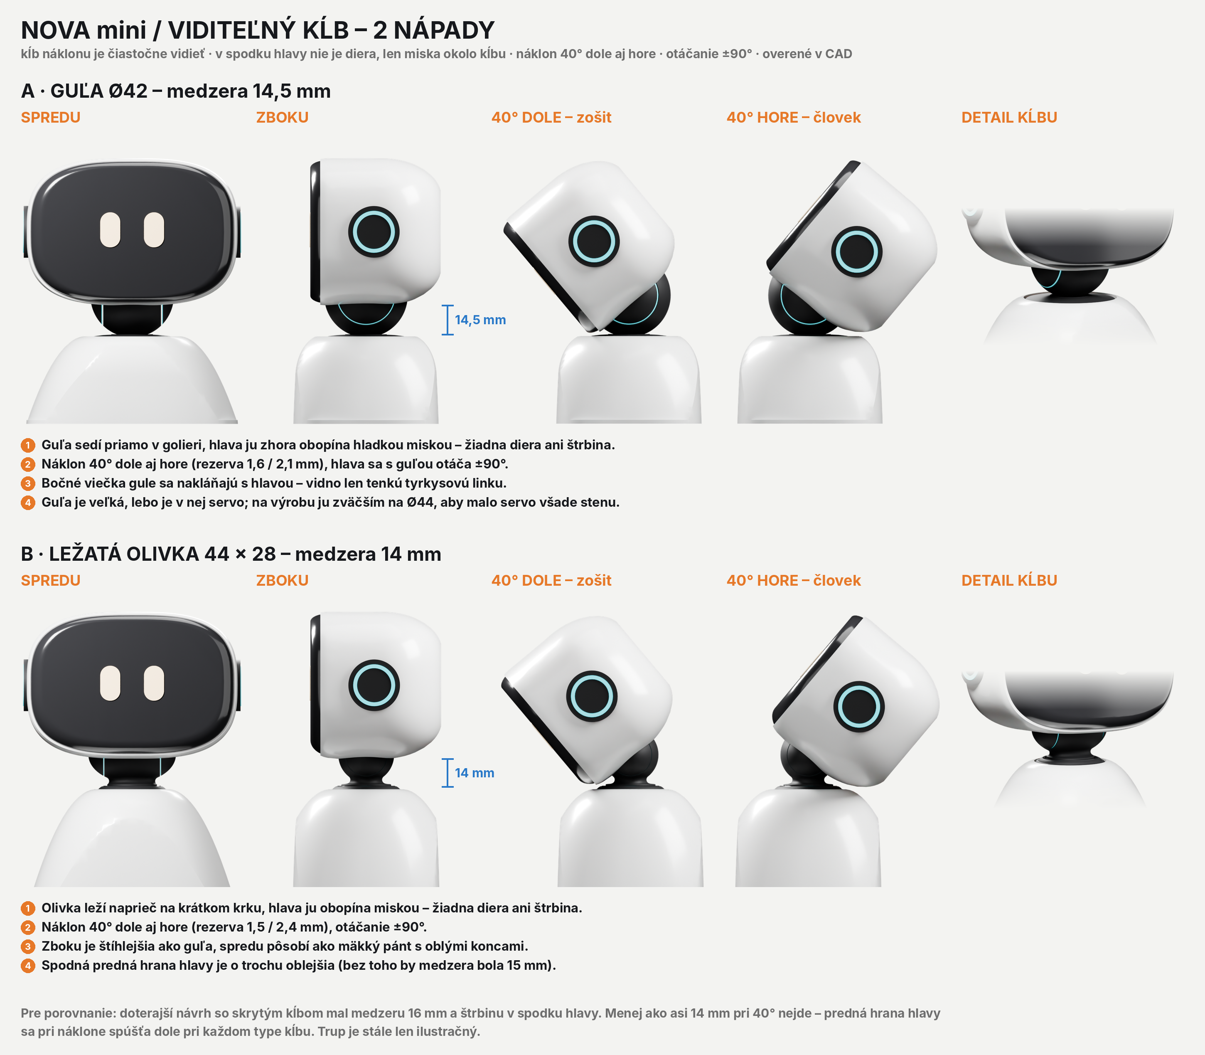
obrazky/postupne/03_koncept_otocny_krk/NOVA_mini_viditelny_klb_gula_olivka.png
