2jkbr252t7-debug/Robot/obrazky/postupne/04_trup_rozpracovane/formy/f1/render_hero.png

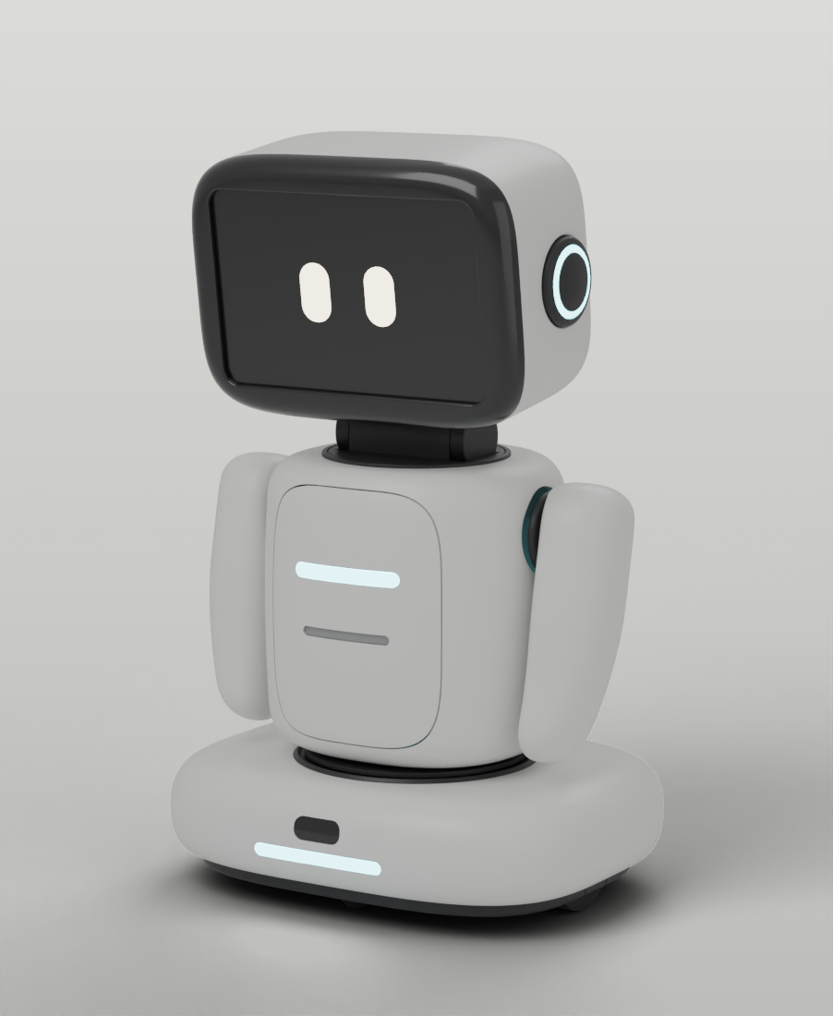
obrazky/postupne/04_trup_rozpracovane/formy/f1/render_hero.png
