2jkbr252t7-debug/Robot/obrazky/postupne/04_trup_rozpracovane/formy/f1/render_persona.png

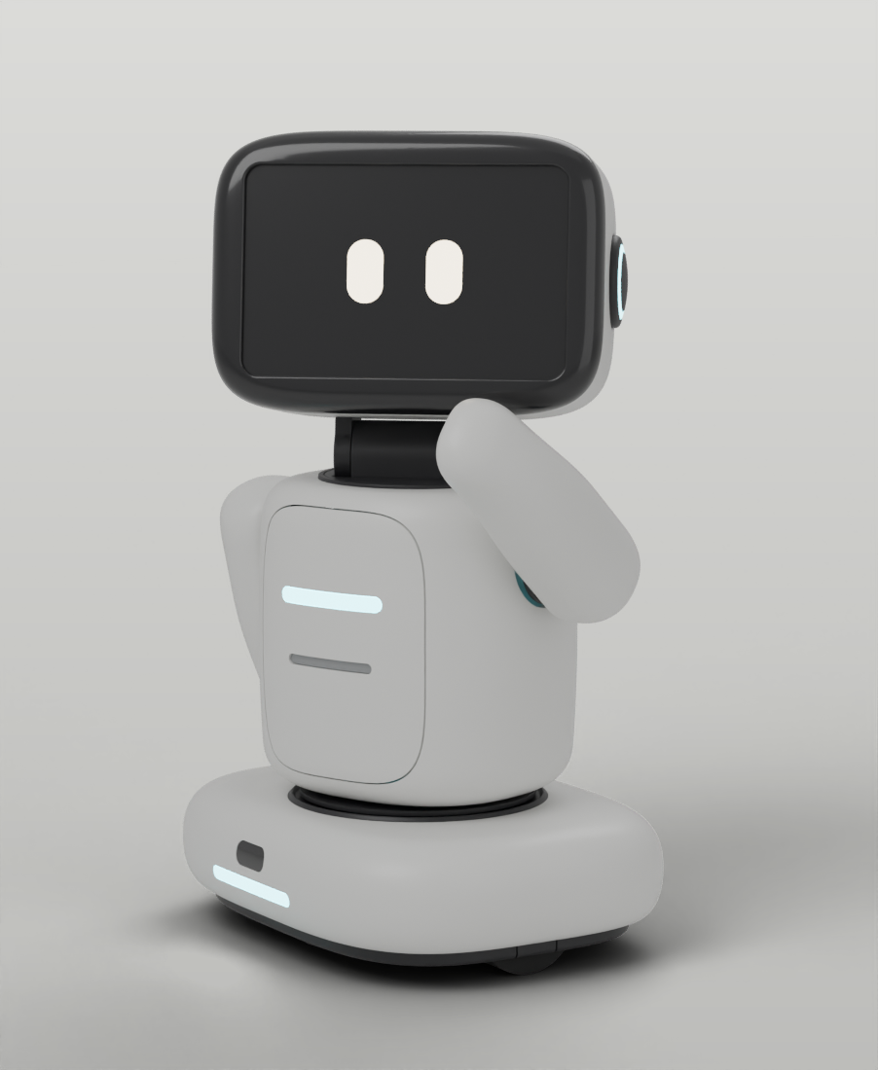
obrazky/postupne/04_trup_rozpracovane/formy/f1/render_persona.png
