2jkbr252t7-debug/Robot/obrazky/postupne/04_trup_rozpracovane/formy/f2/zebra_arm.png

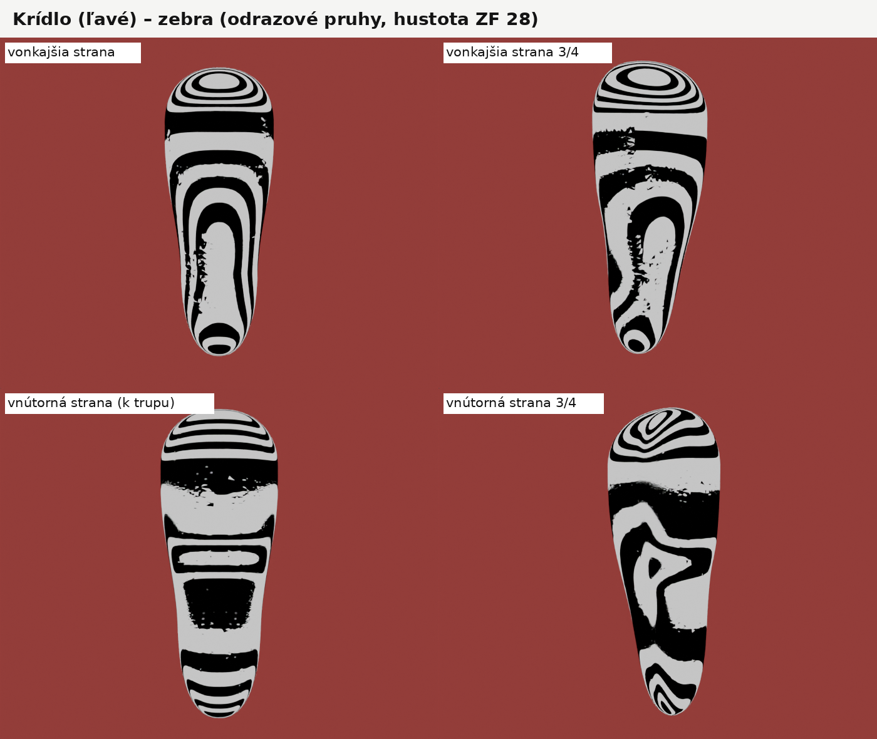
obrazky/postupne/04_trup_rozpracovane/formy/f2/zebra_arm.png
