2jkbr252t7-debug/Robot/obrazky/postupne/04_trup_rozpracovane/k2/prev_awake_cut.png

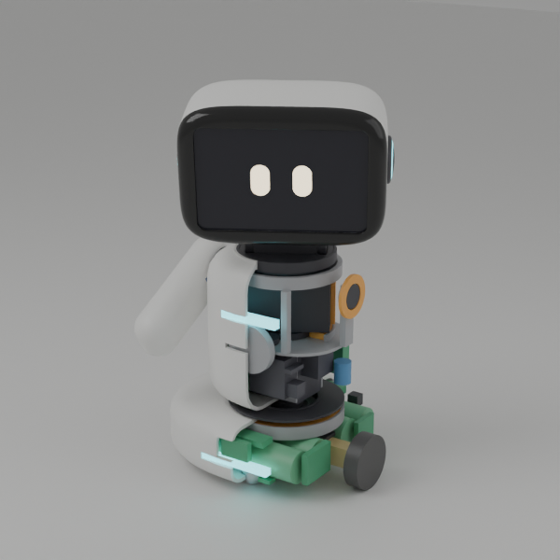
obrazky/postupne/04_trup_rozpracovane/k2/prev_awake_cut.png
