2jkbr252t7-debug/Robot/obrazky/postupne/04_trup_rozpracovane/k2/prev_awake_rez_cut_side.png

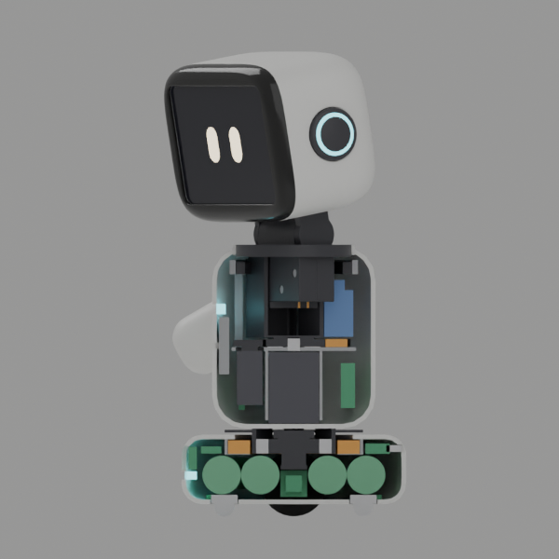
obrazky/postupne/04_trup_rozpracovane/k2/prev_awake_rez_cut_side.png
