2jkbr252t7-debug/Robot/obrazky/postupne/04_trup_rozpracovane/k2/prev_rest_iso.png

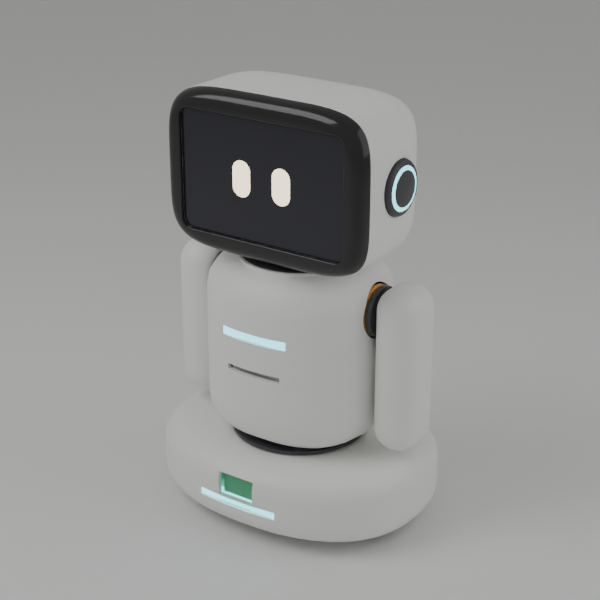
obrazky/postupne/04_trup_rozpracovane/k2/prev_rest_iso.png
