2jkbr252t7-debug/Robot/obrazky/postupne/04_trup_rozpracovane/k2/prev_rest_rez_cut_front.png

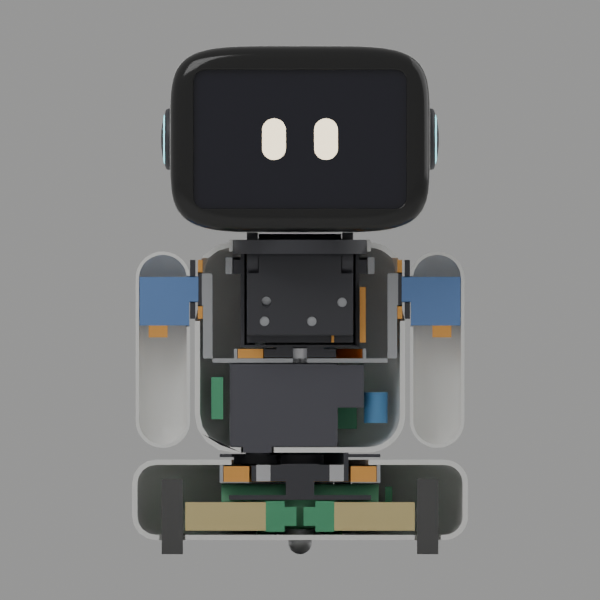
obrazky/postupne/04_trup_rozpracovane/k2/prev_rest_rez_cut_front.png
