2jkbr252t7-debug/Robot/obrazky/postupne/04_trup_rozpracovane/k3/prev_base_plan_iso.png

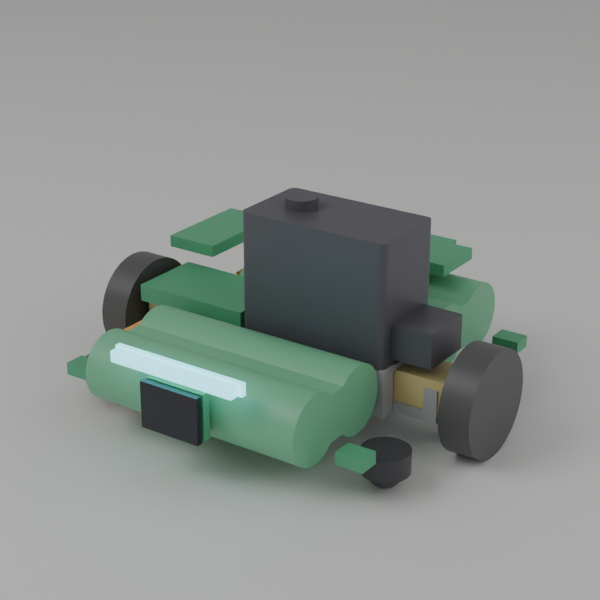
obrazky/postupne/04_trup_rozpracovane/k3/prev_base_plan_iso.png
