2jkbr252t7-debug/Robot/obrazky/postupne/04_trup_rozpracovane/pack/prev_base_plan_iso.png

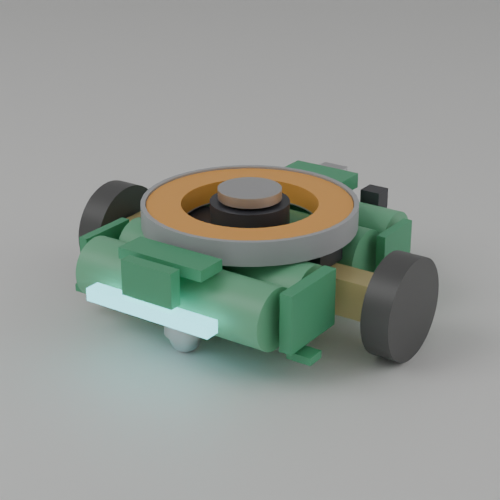
obrazky/postupne/04_trup_rozpracovane/pack/prev_base_plan_iso.png
