2jkbr252t7-debug/Robot/obrazky/postupne/04_trup_rozpracovane/pack/prev_torso_plan_top.png

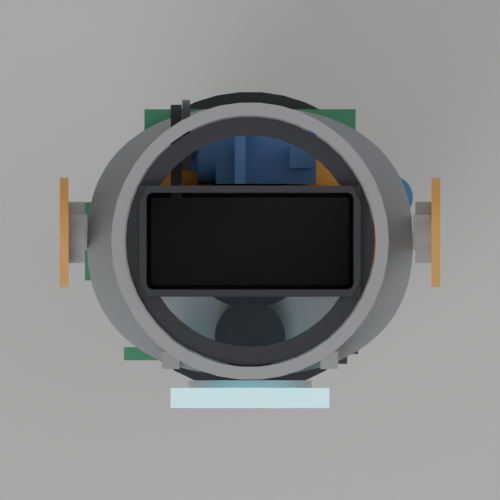
obrazky/postupne/04_trup_rozpracovane/pack/prev_torso_plan_top.png
