2jkbr252t7-debug/Robot/obrazky/v8_koncept/klasik_koncept_prehlad.png

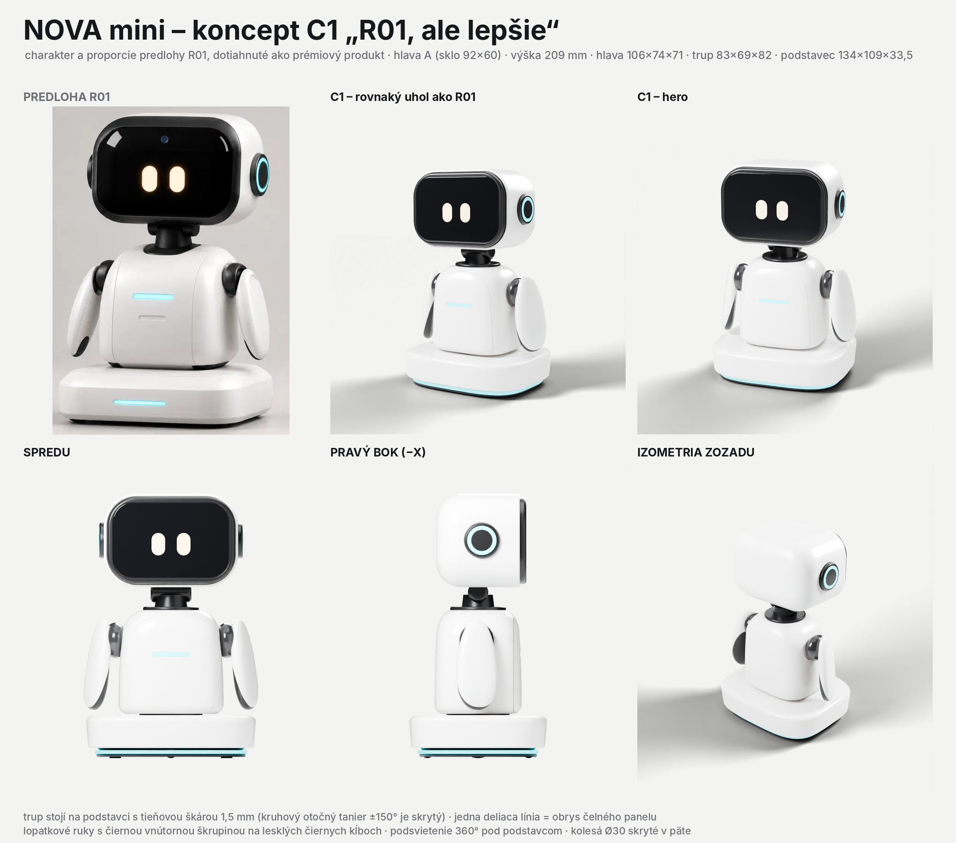
obrazky/v8_koncept/klasik_koncept_prehlad.png
