2jkbr252t7-debug/Robot/obrazky/v8_koncept/navrhy/c1_r01_hero.png

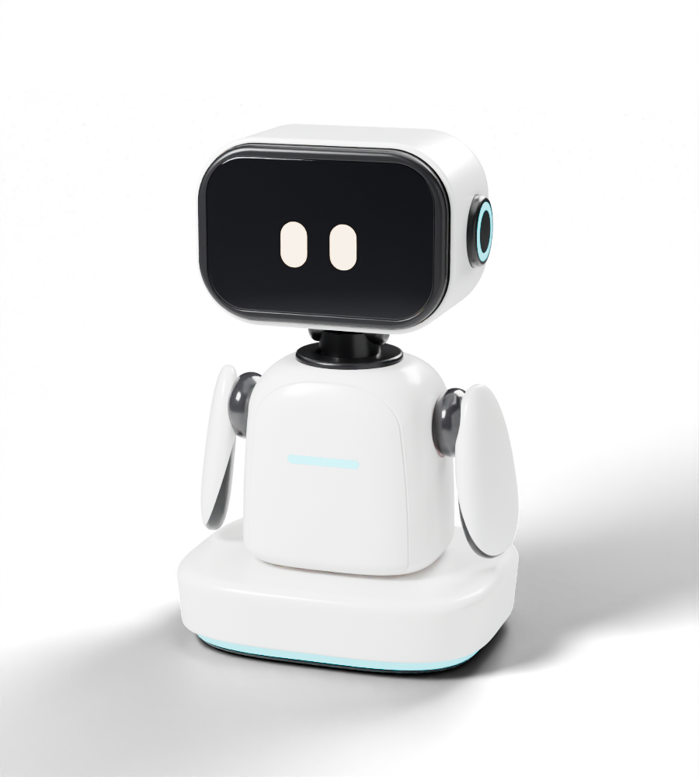
obrazky/v8_koncept/navrhy/c1_r01_hero.png
