2jkbr252t7-debug/Robot/obrazky/v8_koncept/navrhy/c2_kapsula_hero.png

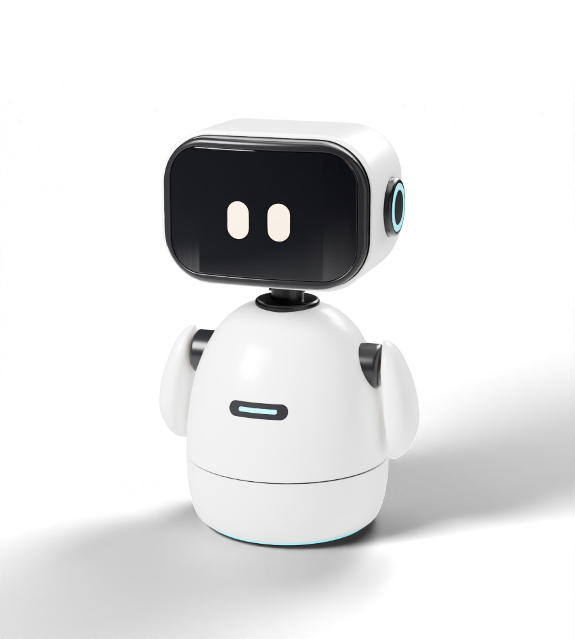
obrazky/v8_koncept/navrhy/c2_kapsula_hero.png
