2jkbr252t7-debug/Robot/obrazky/v8_koncept/navrhy/c4_stlp_hero.png

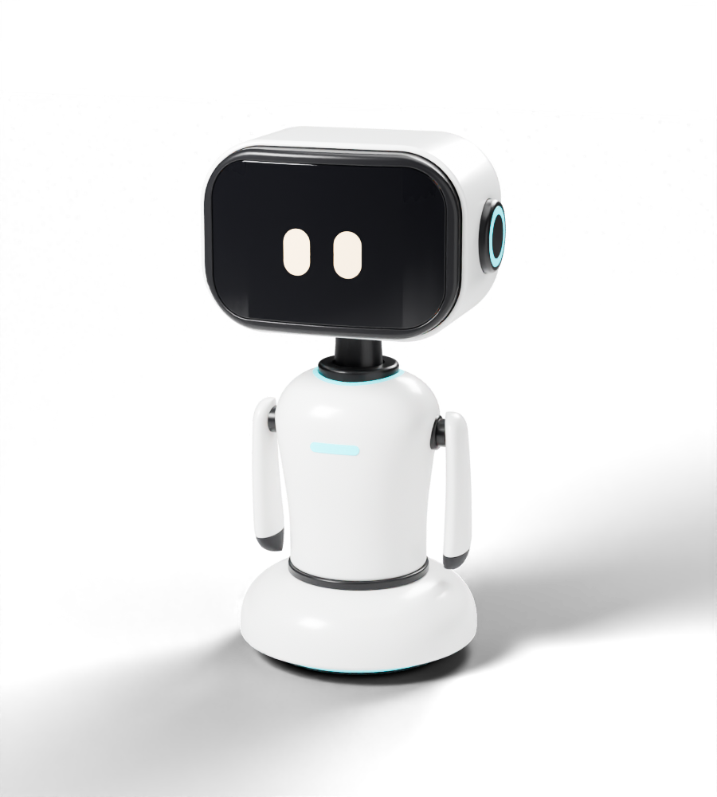
obrazky/v8_koncept/navrhy/c4_stlp_hero.png
