2jkbr252t7-debug/Robot/obrazky/v8_koncept/v8_4_navrhy.png

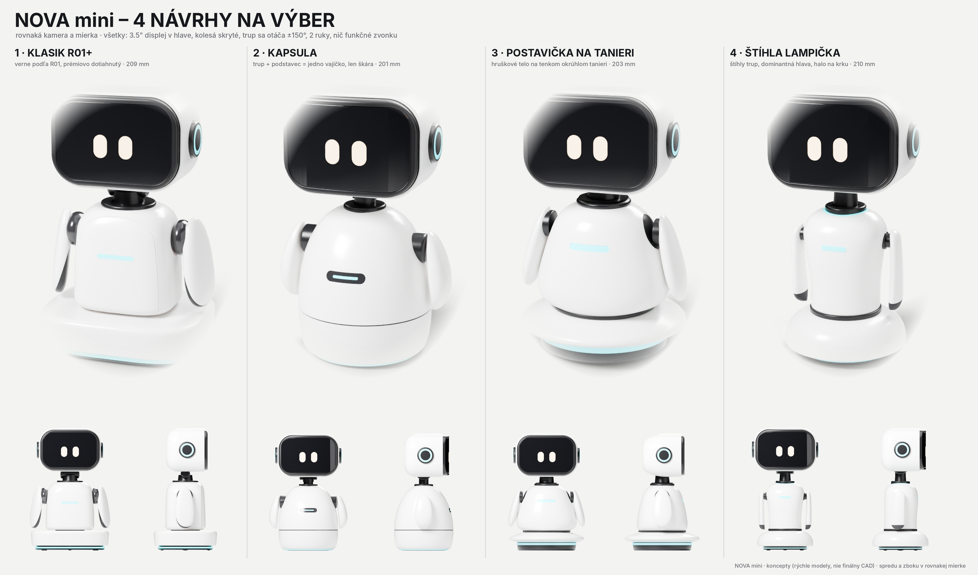
obrazky/v8_koncept/v8_4_navrhy.png
