2jkbr252t7-debug/Robot/obrazky/v8_koncept/v8_makke_tvary.png

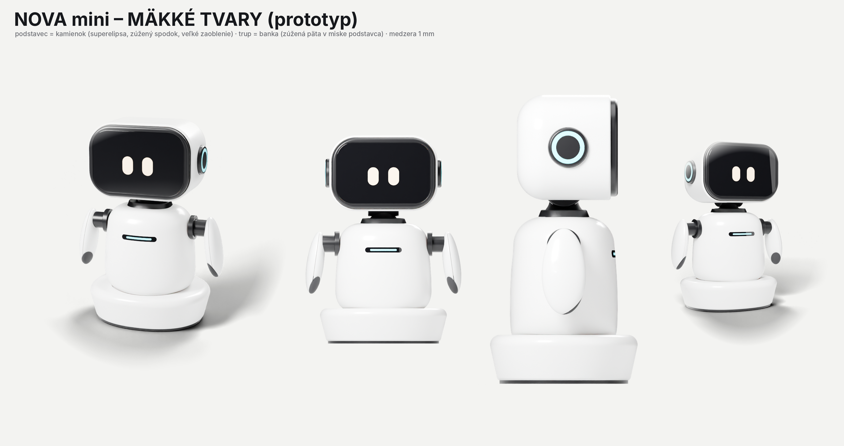
obrazky/v8_koncept/v8_makke_tvary.png
