2jkbr252t7-debug/Robot/obrazky/v8_koncept/v8_porovnanie_hlav.png

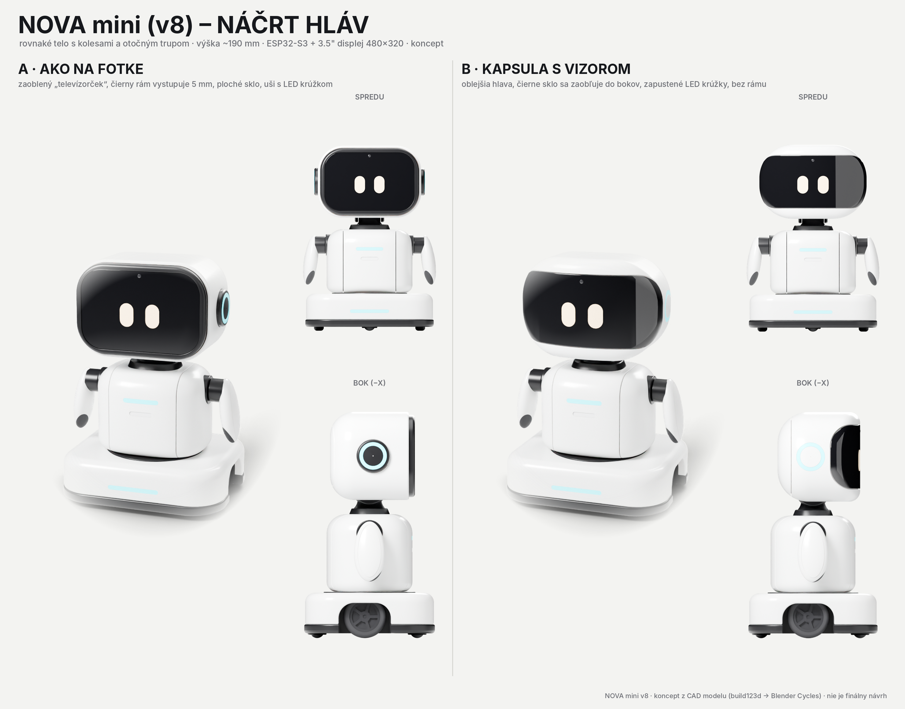
obrazky/v8_koncept/v8_porovnanie_hlav.png
