2jkbr252t7-debug/Robot/obrazky/v8_koncept/v8_studia_proporcii.png

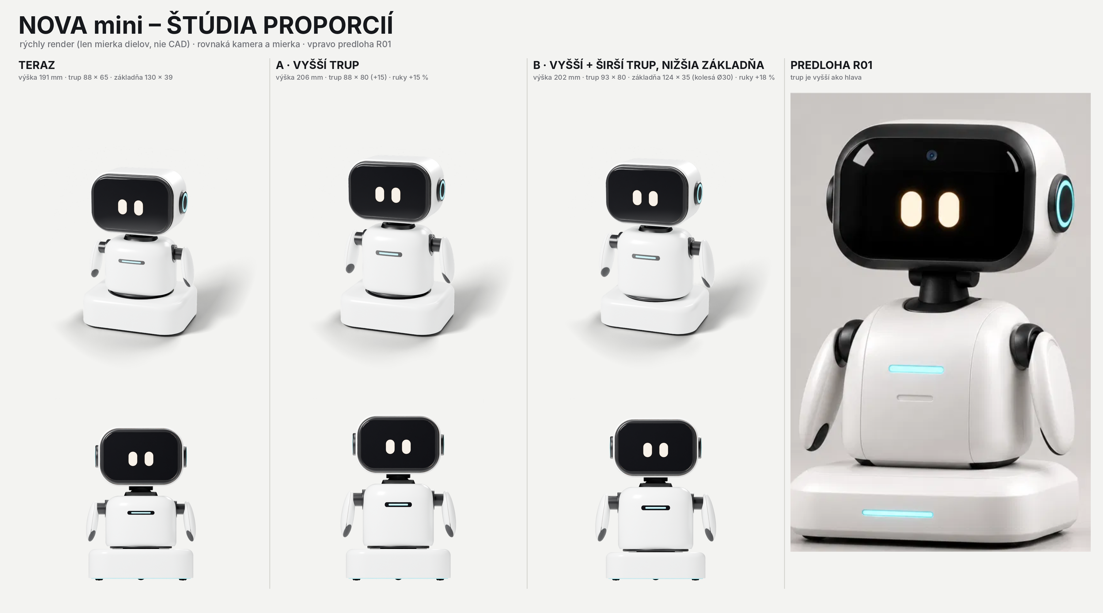
obrazky/v8_koncept/v8_studia_proporcii.png
