2jkbr252t7-debug/Robot/obrazky/v8_koncept/v8_varianty_hlavy.png

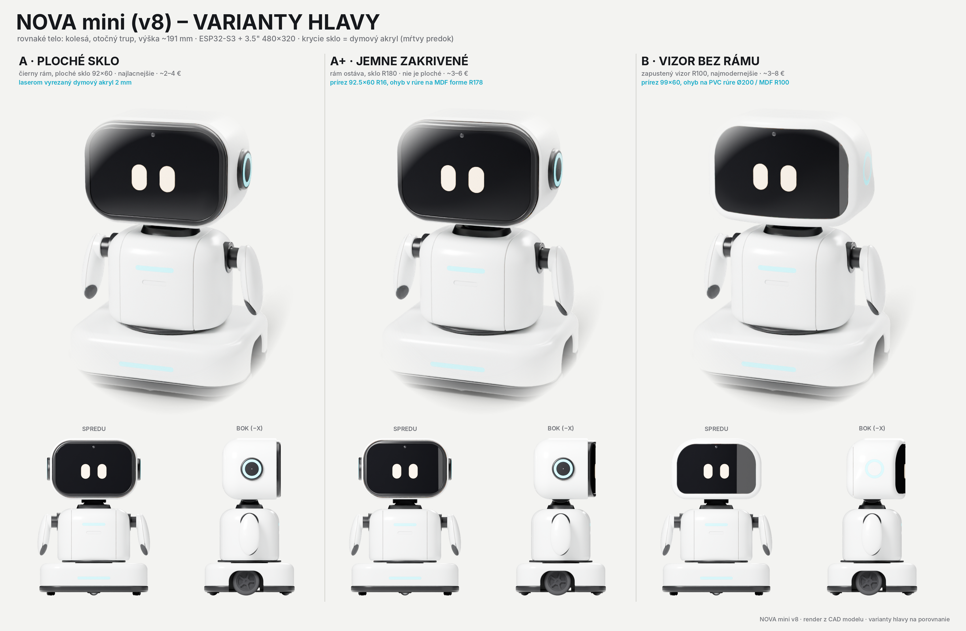
obrazky/v8_koncept/v8_varianty_hlavy.png
