2jkbr252t7-debug/Robot/referencie/R01_celok_zadanie.png

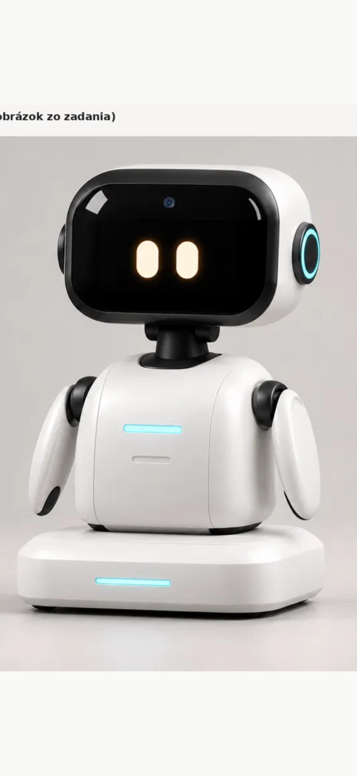
referencie/R01_celok_zadanie.png
