2jkbr252t7-debug/Robot/referencie/R02_prava_ruka.png

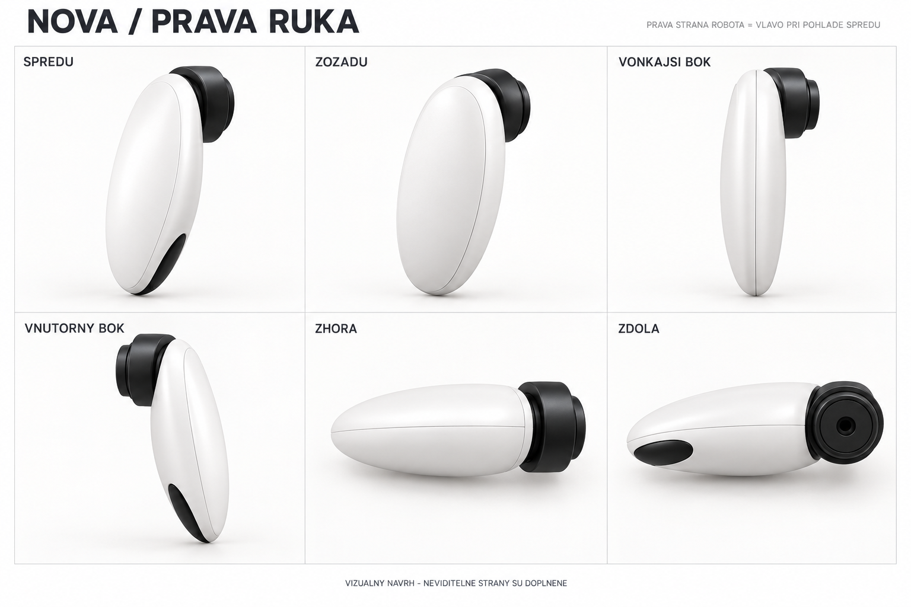
referencie/R02_prava_ruka.png
