2jkbr252t7-debug/Robot/referencie/R03_hlava.png

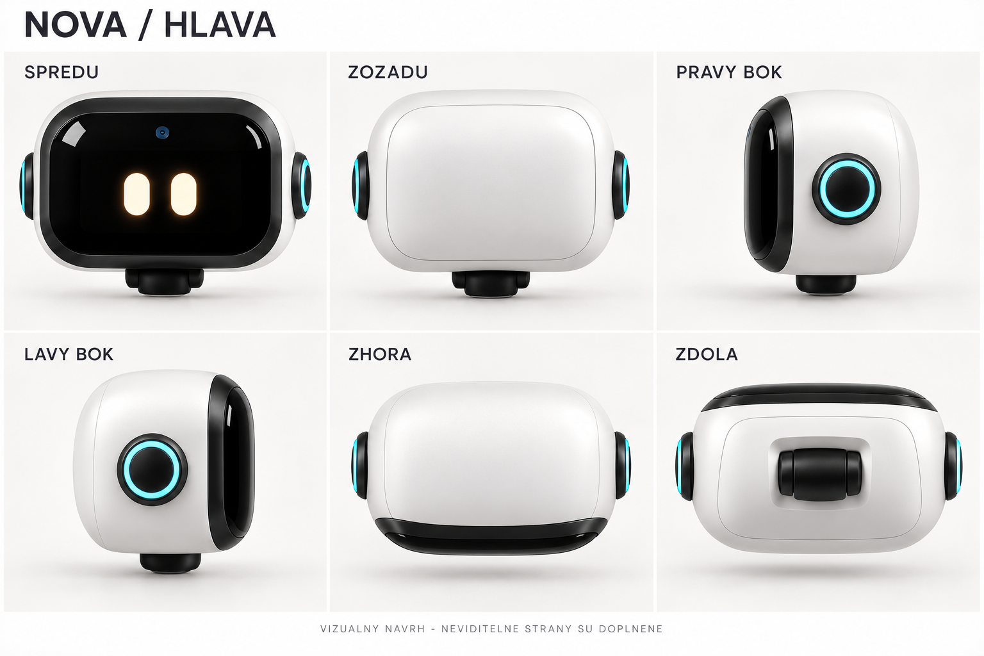
referencie/R03_hlava.png
