2jkbr252t7-debug/Robot/referencie/R04_krk_golier.png

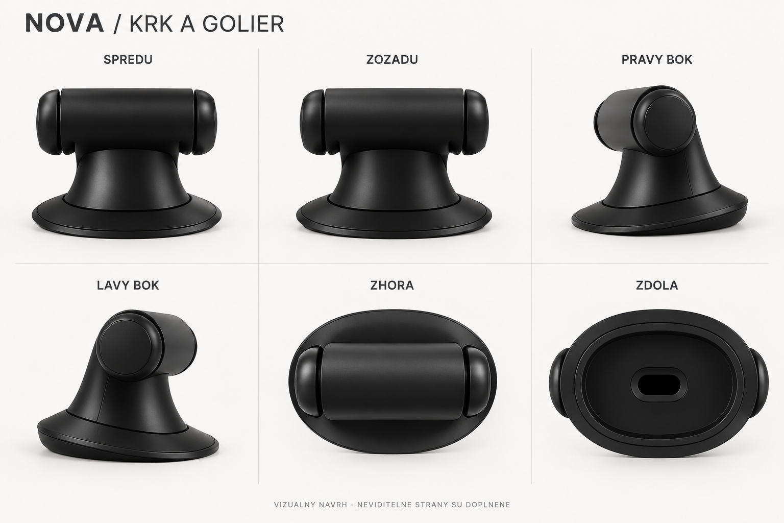
referencie/R04_krk_golier.png
