2jkbr252t7-debug/Robot/referencie/R05_trup.png

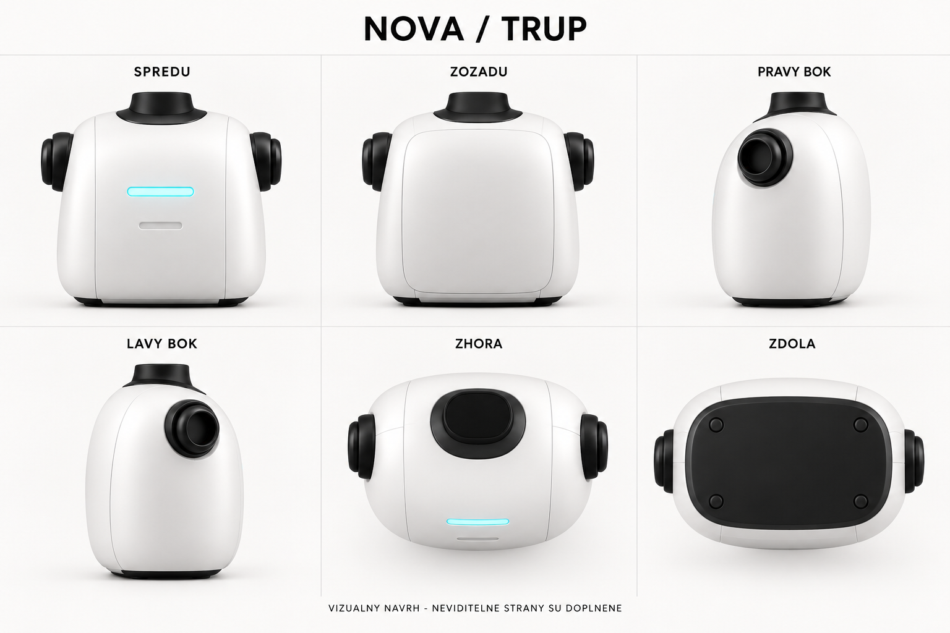
referencie/R05_trup.png
