2jkbr252t7-debug/Robot/referencie/R06_kryty_hlavy.png

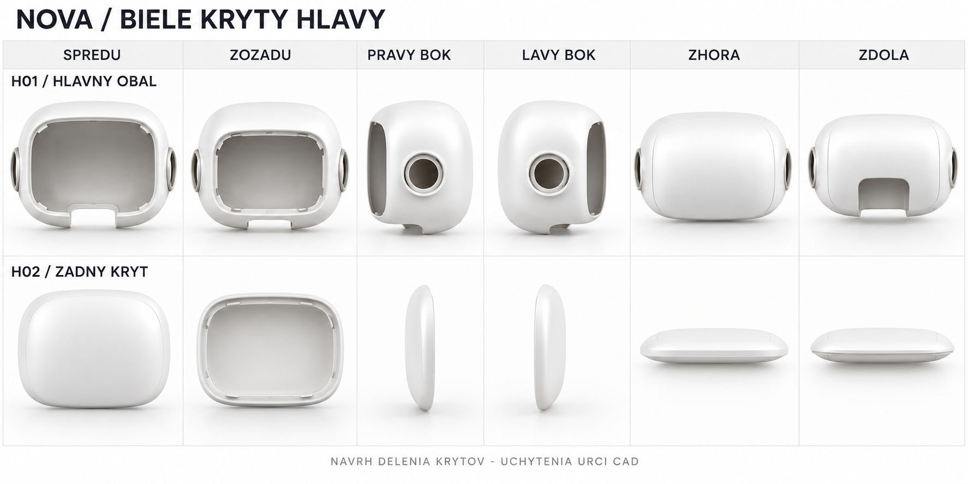
referencie/R06_kryty_hlavy.png
