2jkbr252t7-debug/Robot/referencie/R07_kryty_krku.png

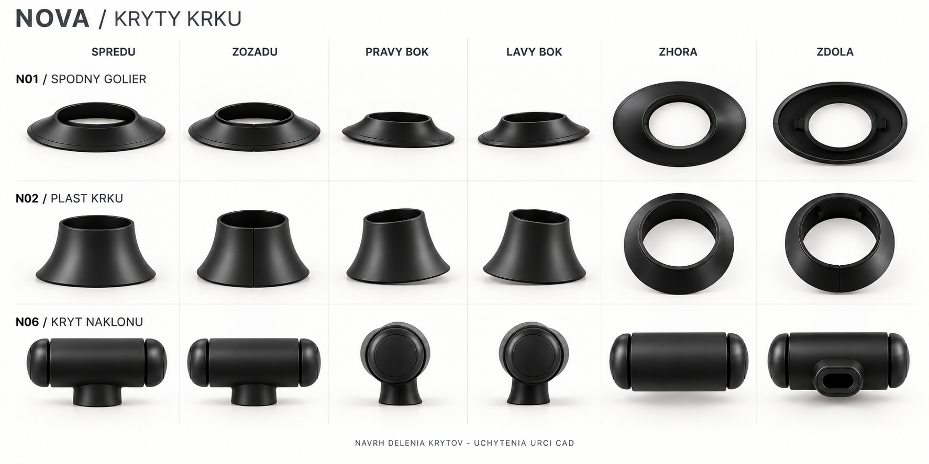
referencie/R07_kryty_krku.png
