2jkbr252t7-debug/Robot/referencie/R08_ramenny_klb.png

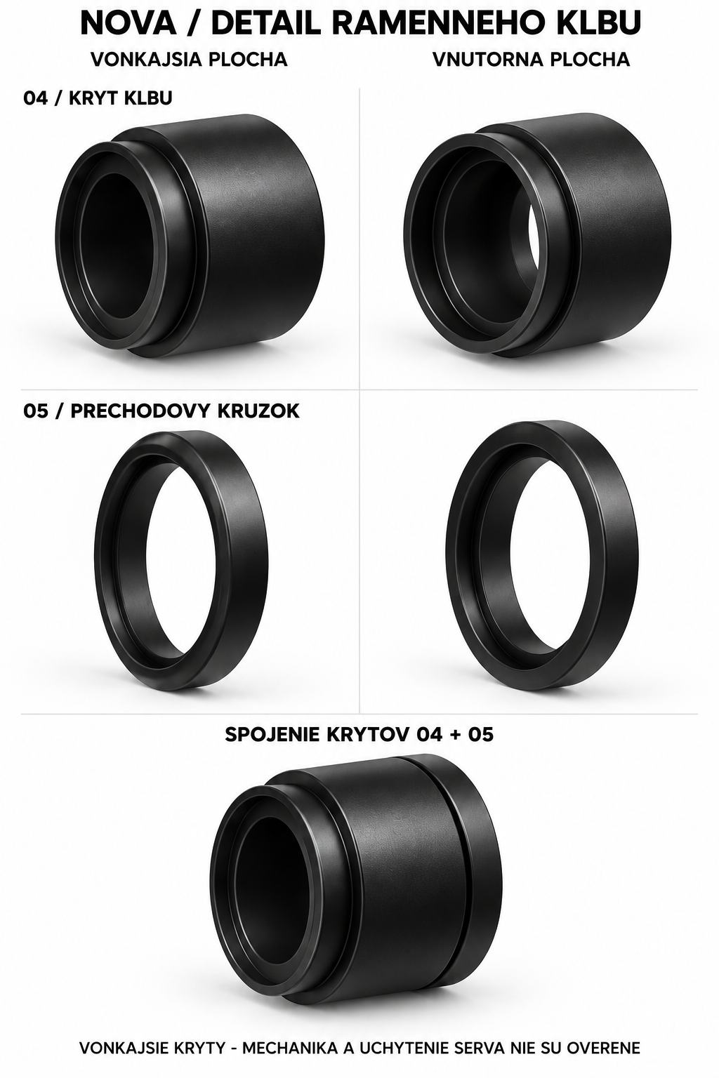
referencie/R08_ramenny_klb.png
