2jkbr252t7-debug/Robot/referencie/R09_diely_ruky_a.png

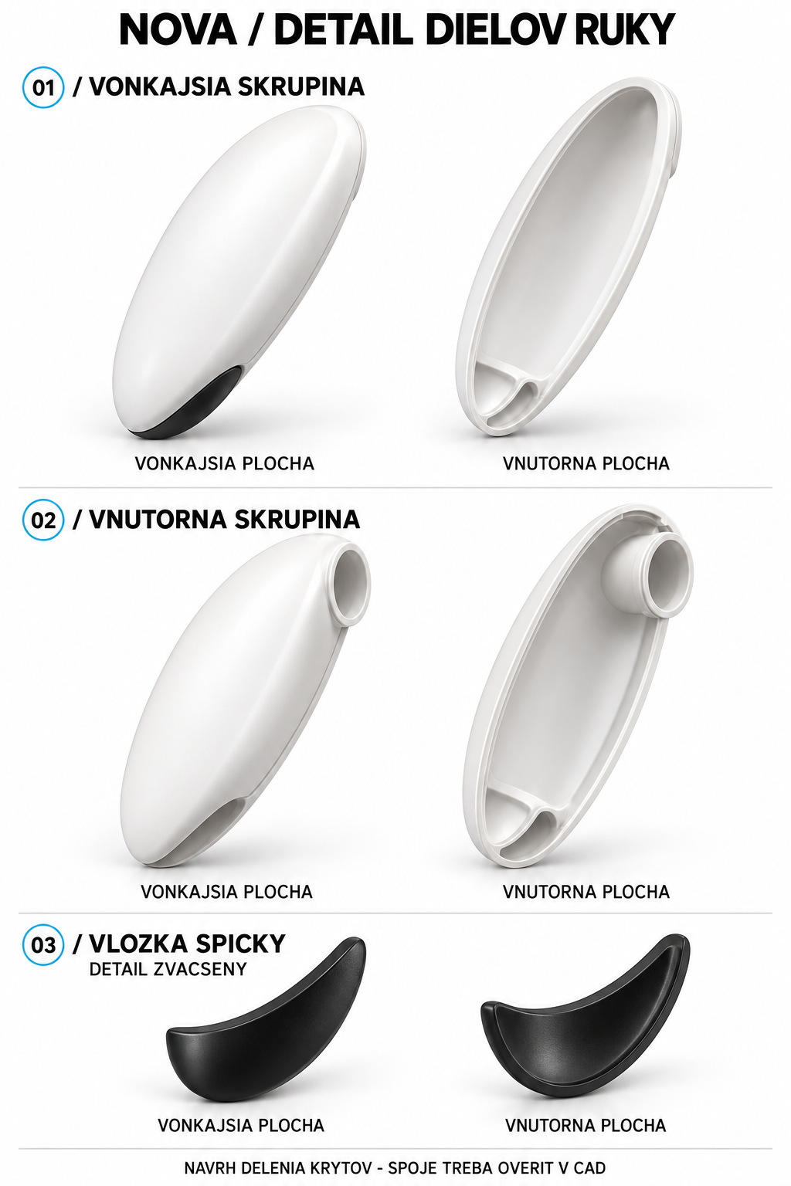
referencie/R09_diely_ruky_a.png
