2jkbr252t7-debug/Robot/referencie/R11_ruka_rameno_explod.png

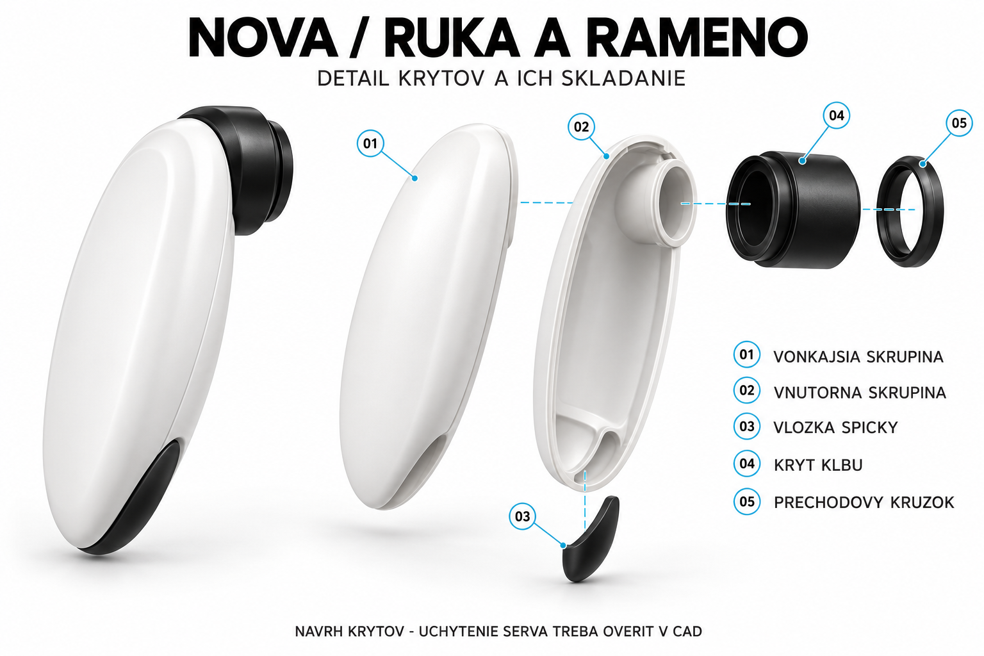
referencie/R11_ruka_rameno_explod.png
