2jkbr252t7-debug/Robot/referencie/R12_lava_ruka_vs_v6.png

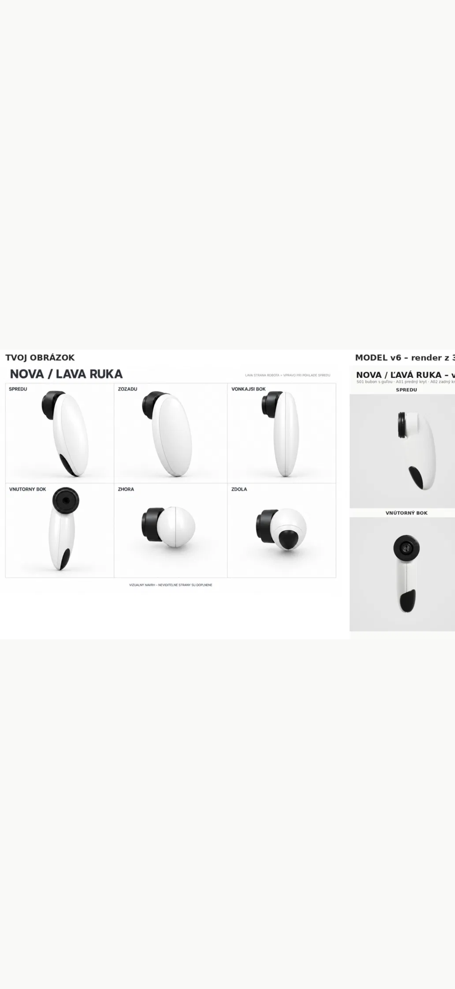
referencie/R12_lava_ruka_vs_v6.png
