2jkbr252t7-debug/Robot/obrazky/postupne/01_hlava_skrupina/NOVA_mini_01_hlava_skrupina_navrh5.step

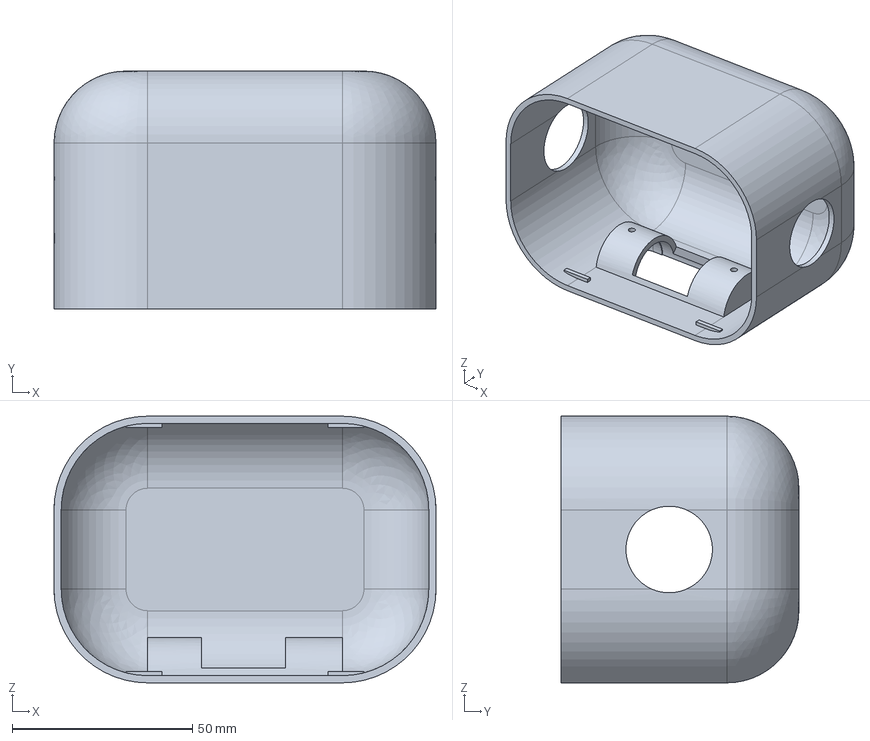
[picture p131: CAD file, 2026-11-04]
obrazky/postupne/01_hlava_skrupina/NOVA_mini_01_hlava_skrupina_navrh5.step
106.0 x 66.0 x 74.0 mm
