2jkbr252t7-debug/Robot/obrazky/postupne/02_krk/NOVA_mini_N1_krk_jeden_diel.step

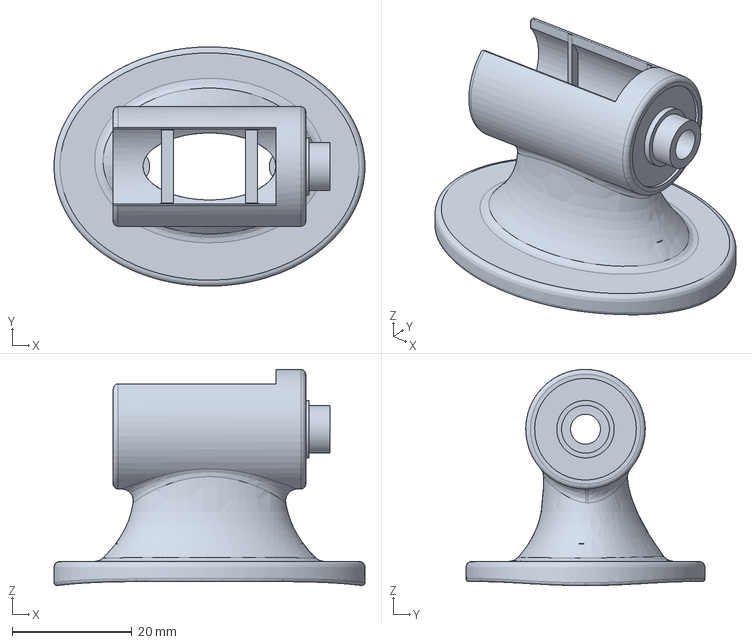
[picture p132: CAD file, 2026-11-04]
obrazky/postupne/02_krk/NOVA_mini_N1_krk_jeden_diel.step
52.0 x 40.0 x 36.2 mm
