2jkbr252t7-debug/Robot/obrazky/postupne/02_krk_r04/NOVA_mini_N02_plast_krku.step

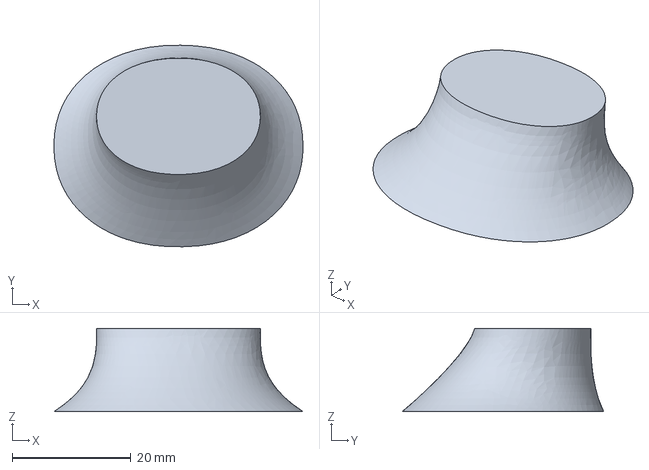
[picture p133: CAD file, 2026-11-03]
obrazky/postupne/02_krk_r04/NOVA_mini_N02_plast_krku.step
42.0 x 34.0 x 14.0 mm
