2jkbr252t7-debug/Robot/obrazky/postupne/03_koncept_otocny_krk/stl/B_servo_v_krku/krk_predna_polovica.stl

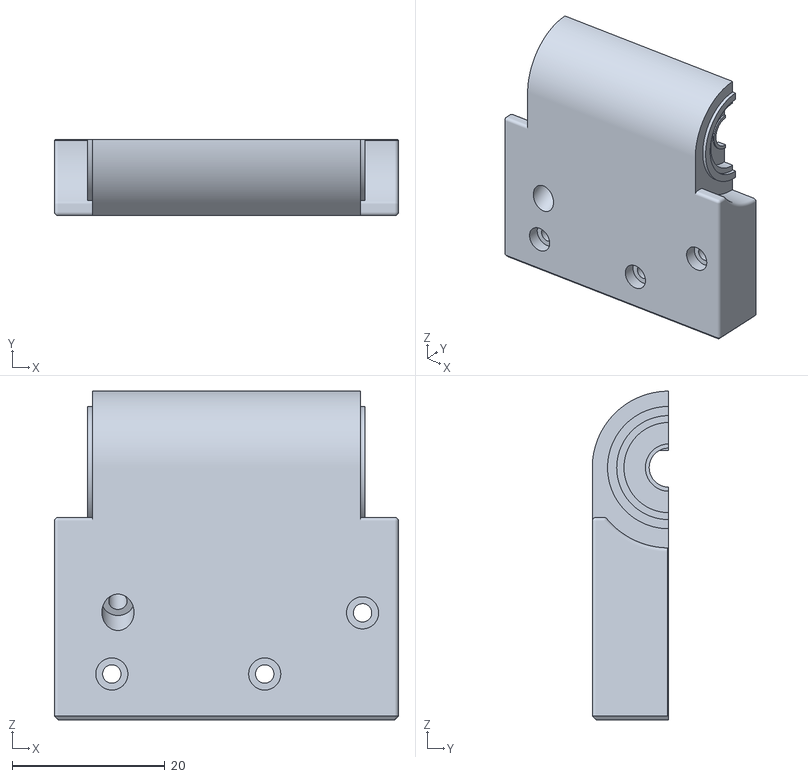
[picture p134: CAD file, 2026-11-11]
obrazky/postupne/03_koncept_otocny_krk/stl/B_servo_v_krku/krk_predna_polovica.stl
45.0 x 10.0 x 43.0
