2jkbr252t7-debug/Robot/obrazky/postupne/02_krk/NOVA_mini_N3_unasac_spodny.step

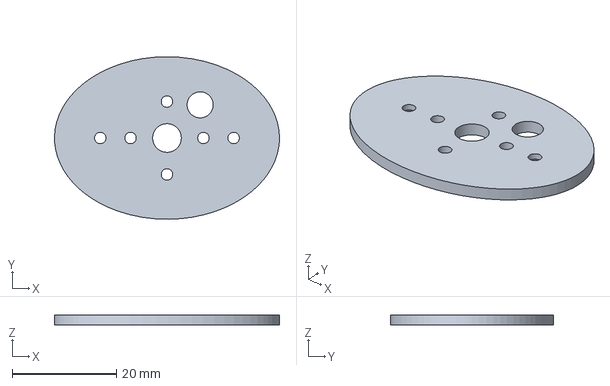
[picture p135: CAD file, 2026-11-04]
obrazky/postupne/02_krk/NOVA_mini_N3_unasac_spodny.step
43.2 x 31.2 x 2.00 mm
