2jkbr252t7-debug/Robot/obrazky/postupne/02_krk_r04/NOVA_mini_N06_kryt_naklonu.step

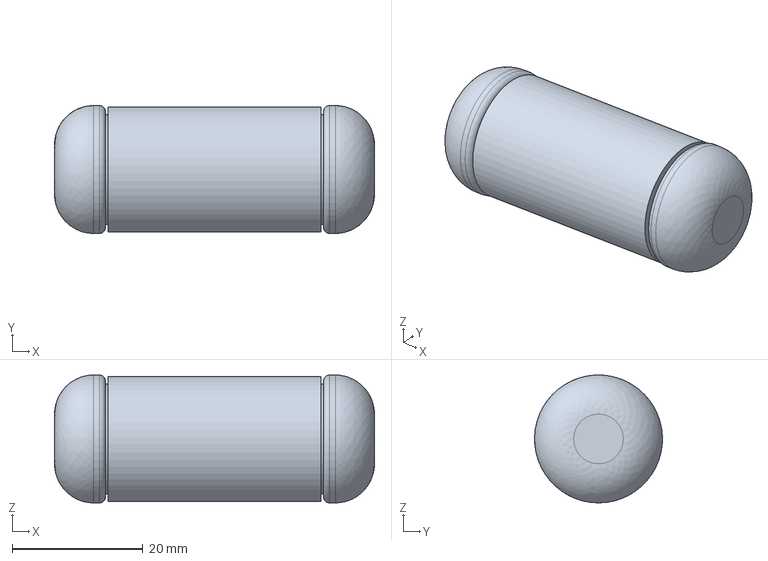
[picture p136: CAD file, 2026-11-03]
obrazky/postupne/02_krk_r04/NOVA_mini_N06_kryt_naklonu.step
49.0 x 19.6 x 19.6 mm
