2jkbr252t7-debug/Robot/obrazky/postupne/03_koncept_otocny_krk/stl/B_servo_v_krku/pena_serva.stl

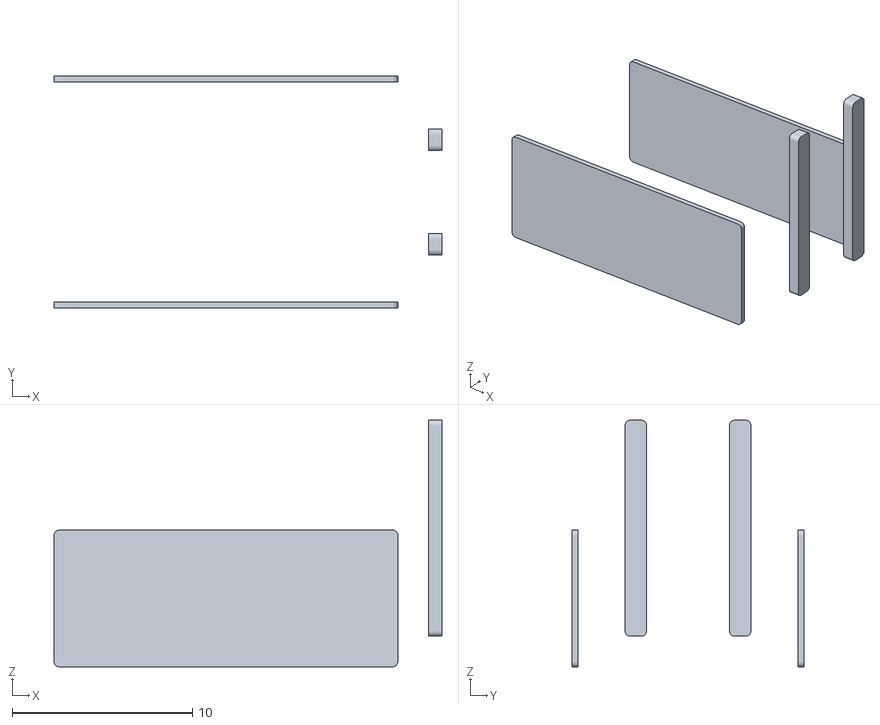
[picture p137: CAD file, 2026-11-11]
obrazky/postupne/03_koncept_otocny_krk/stl/B_servo_v_krku/pena_serva.stl
21.6 x 12.9 x 13.7
