2jkbr252t7-debug/Robot/obrazky/postupne/01_hlava_skrupina/NOVA_mini_krk_navrh1.step

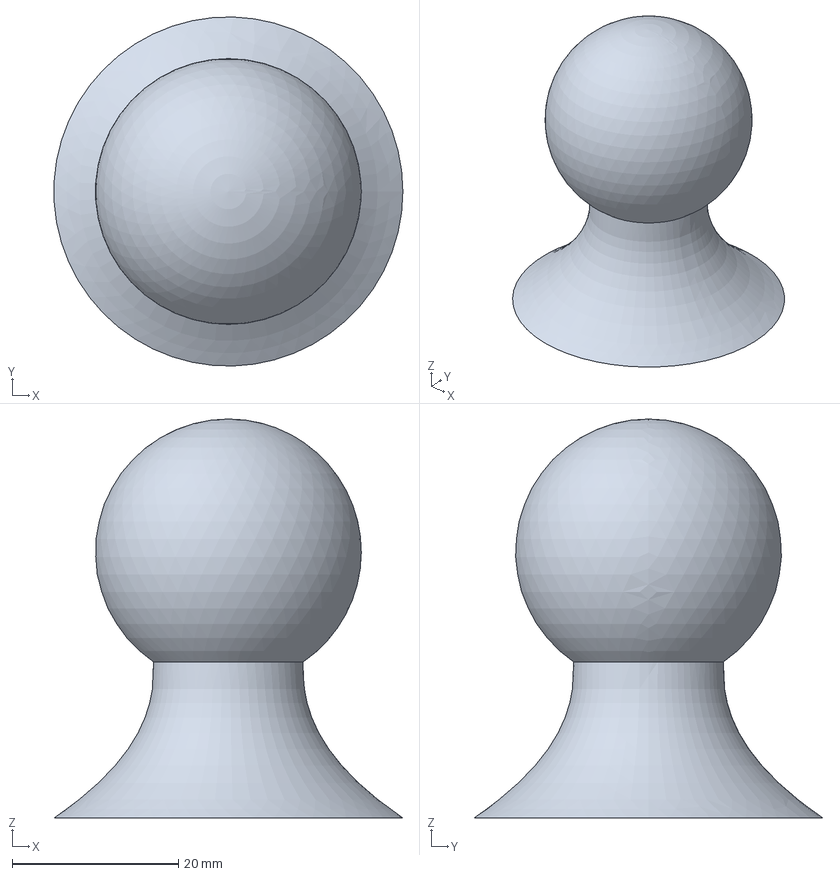
[picture p138: CAD file, 2026-11-02]
obrazky/postupne/01_hlava_skrupina/NOVA_mini_krk_navrh1.step
42.0 x 42.0 x 48.0 mm
