2jkbr252t7-debug/Robot/obrazky/postupne/02_krk/NOVA_mini_N2-P_viecko_prave.step

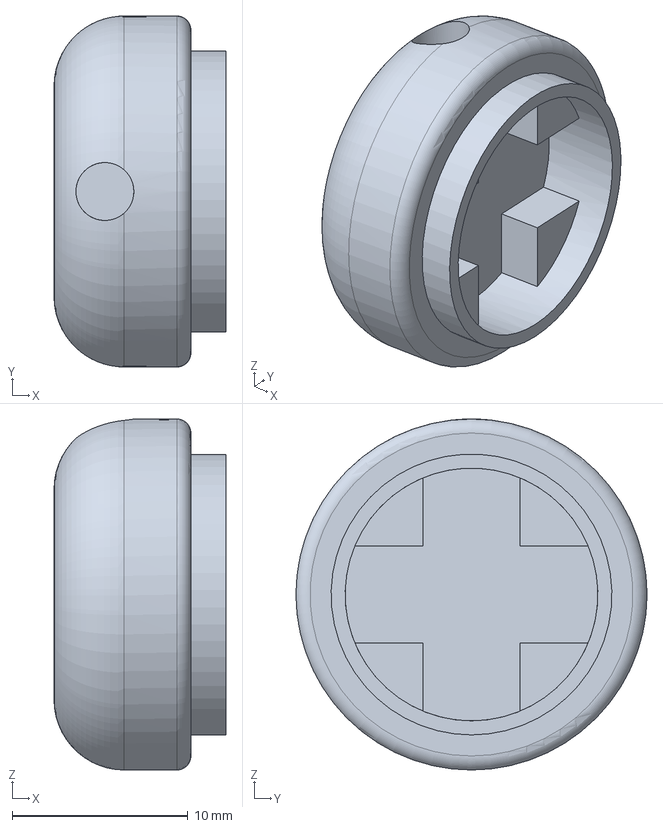
[picture p139: CAD file, 2026-11-04]
obrazky/postupne/02_krk/NOVA_mini_N2-P_viecko_prave.step
9.80 x 20.0 x 20.0 mm
