2jkbr252t7-debug/Robot/obrazky/postupne/02_krk_r04/NOVA_mini_N01_golier.step

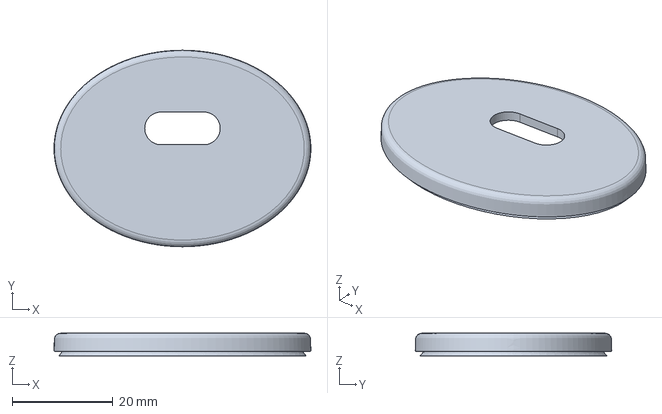
[picture p140: CAD file, 2026-11-03]
obrazky/postupne/02_krk_r04/NOVA_mini_N01_golier.step
51.1 x 39.1 x 4.50 mm
