2jkbr252t7-debug/Robot/obrazky/postupne/03_koncept_otocny_krk/stl/B_servo_v_krku/servo_MG90S.stl

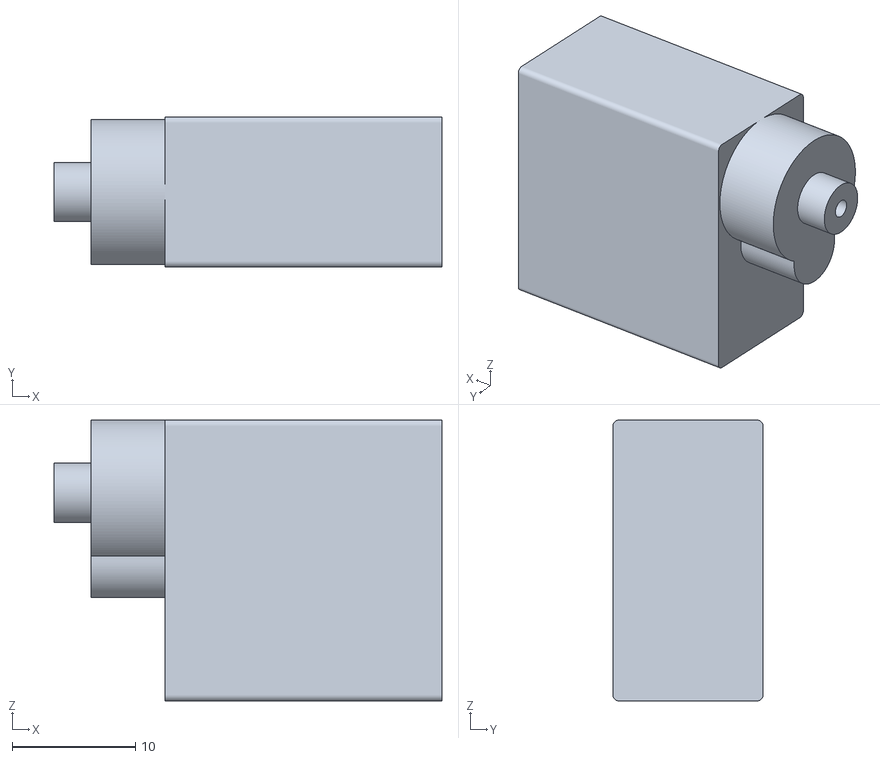
[picture p141: CAD file, 2026-11-11]
obrazky/postupne/03_koncept_otocny_krk/stl/B_servo_v_krku/servo_MG90S.stl
31.5 x 12.2 x 22.8
