2jkbr252t7-debug/Robot/obrazky/postupne/01_hlava_skrupina/NOVA_mini_01_hlava_skrupina_navrh3.step

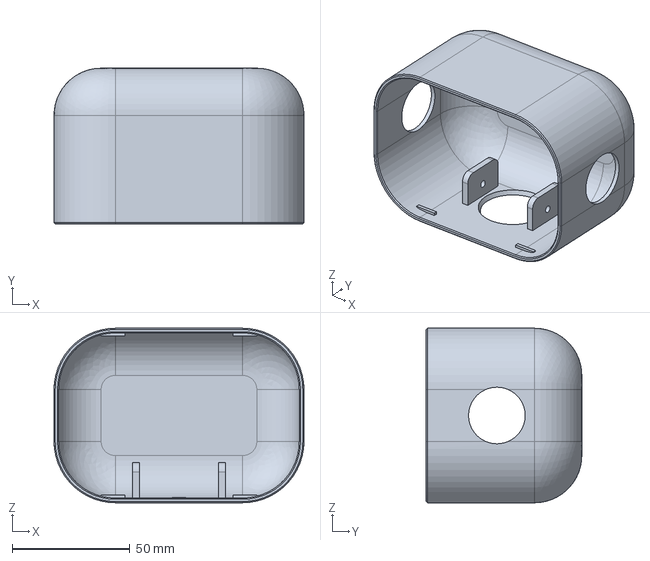
[picture p142: CAD file, 2026-11-02]
obrazky/postupne/01_hlava_skrupina/NOVA_mini_01_hlava_skrupina_navrh3.step
106.0 x 66.0 x 74.0 mm
