2jkbr252t7-debug/Robot/obrazky/postupne/02_krk/NOVA_mini_N2-L_viecko_lave.step

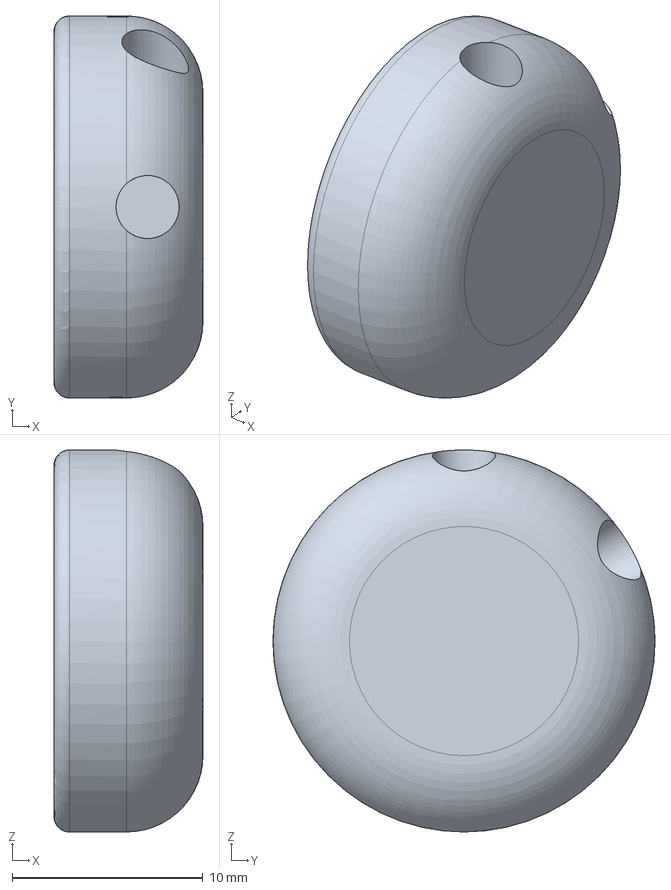
[picture p143: CAD file, 2026-11-04]
obrazky/postupne/02_krk/NOVA_mini_N2-L_viecko_lave.step
7.80 x 20.0 x 20.0 mm
