2jkbr252t7-debug/Robot/obrazky/postupne/03_koncept_otocny_krk/stl/B_servo_v_krku/kabel.stl

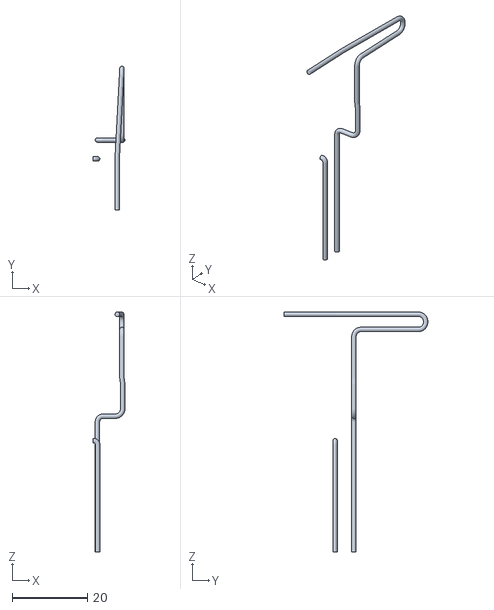
[picture p144: CAD file, 2026-11-11]
obrazky/postupne/03_koncept_otocny_krk/stl/B_servo_v_krku/kabel.stl
8.47 x 38.1 x 63.6
