2jkbr252t7-debug/Robot/obrazky/postupne/03_koncept_otocny_krk/stl/B_servo_v_krku/hlava_skrupina.stl

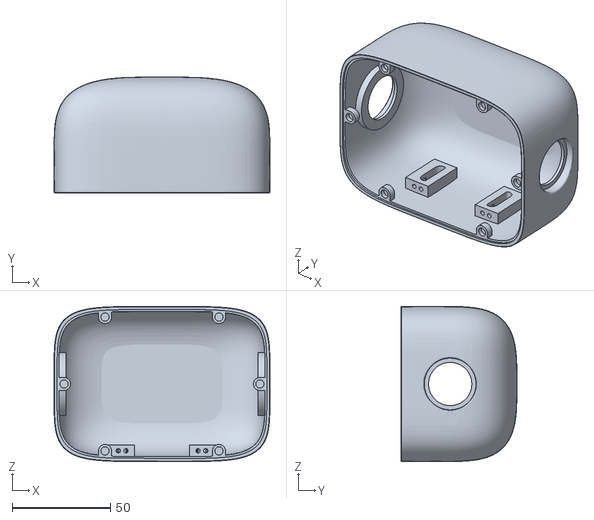
[picture p145: CAD file, 2026-11-11]
obrazky/postupne/03_koncept_otocny_krk/stl/B_servo_v_krku/hlava_skrupina.stl
110.0 x 59.0 x 79.0
