2jkbr252t7-debug/Robot/obrazky/postupne/03_koncept_otocny_krk/stl/B_servo_v_krku/usko_lozisko.stl

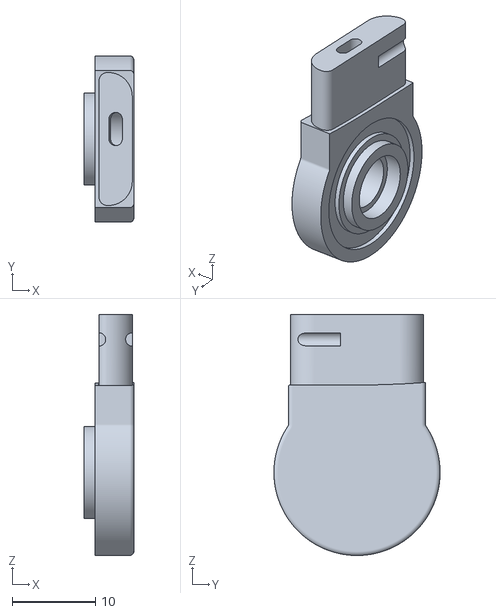
[picture p151: CAD file, 2026-11-11]
obrazky/postupne/03_koncept_otocny_krk/stl/B_servo_v_krku/usko_lozisko.stl
6.00 x 20.0 x 29.0
