2jkbr252t7-debug/Robot/obrazky/postupne/03_koncept_otocny_krk/stl/B_servo_v_krku/golier_kotuc.stl

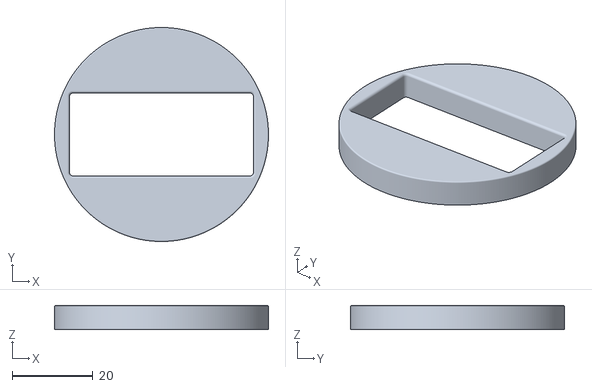
[picture p154: CAD file, 2026-11-11]
obrazky/postupne/03_koncept_otocny_krk/stl/B_servo_v_krku/golier_kotuc.stl
53.0 x 53.0 x 6.00
