2jkbr252t7-debug/Robot/obrazky/postupne/03_koncept_otocny_krk/stl/B_servo_v_krku/golier_prstenec.stl

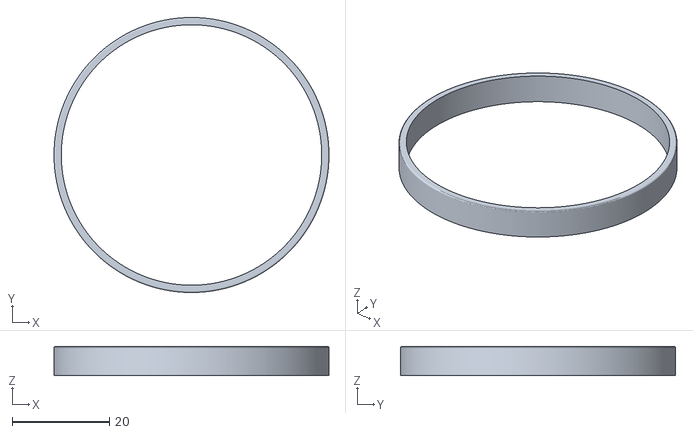
[picture p157: CAD file, 2026-11-11]
obrazky/postupne/03_koncept_otocny_krk/stl/B_servo_v_krku/golier_prstenec.stl
56.5 x 56.5 x 6.00
