2jkbr252t7-debug/Robot/obrazky/postupne/03_koncept_otocny_krk/stl/B_servo_v_krku/klzny_kruzok.stl

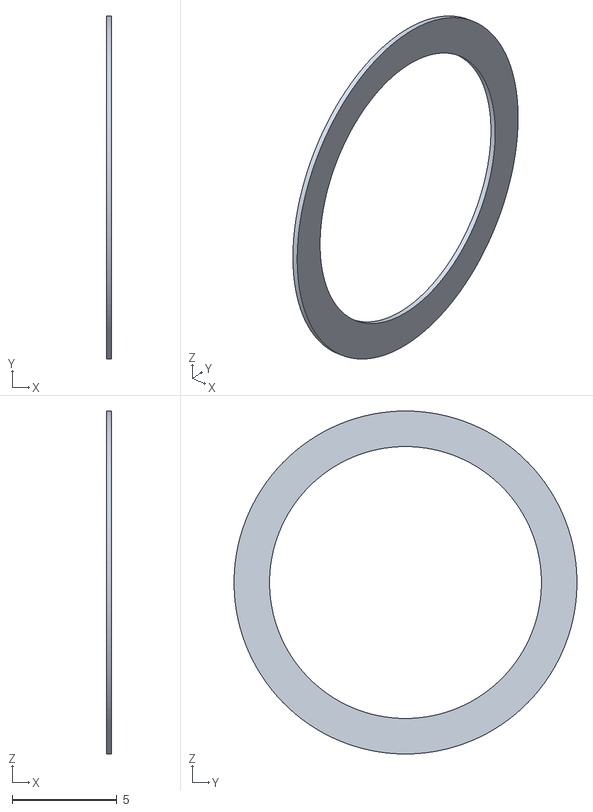
[picture p159: CAD file, 2026-11-11]
obrazky/postupne/03_koncept_otocny_krk/stl/B_servo_v_krku/klzny_kruzok.stl
0.25 x 16.4 x 16.4
