2jkbr252t7-debug/Robot/obrazky/postupne/03_koncept_otocny_krk/stl/B_servo_v_krku/loziska_MR85.stl

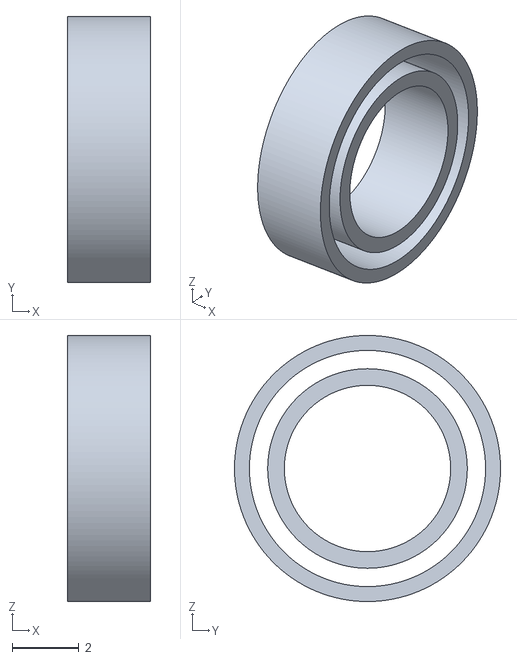
[picture p162: CAD file, 2026-11-11]
obrazky/postupne/03_koncept_otocny_krk/stl/B_servo_v_krku/loziska_MR85.stl
2.50 x 8.00 x 8.00
