2jkbr252t7-debug/Robot/obrazky/postupne/03_koncept_otocny_krk/stl/B_servo_v_krku/drziak_displeja.stl

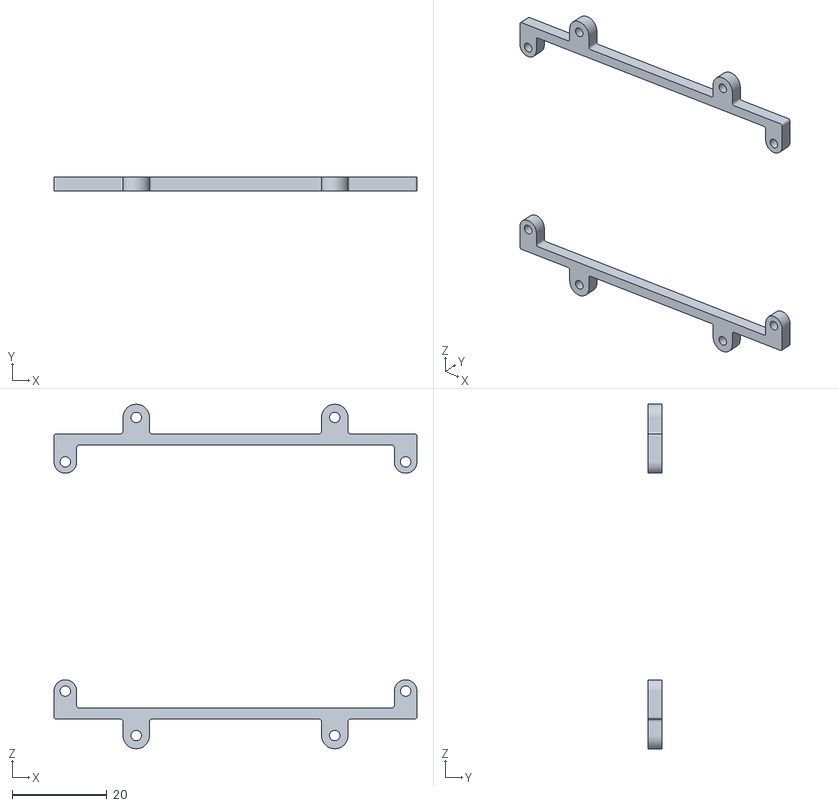
[picture p164: CAD file, 2026-11-11]
obrazky/postupne/03_koncept_otocny_krk/stl/B_servo_v_krku/drziak_displeja.stl
76.8 x 3.00 x 72.9
