2jkbr252t7-debug/Robot/obrazky/postupne/03_koncept_otocny_krk/stl/B_servo_v_krku/oci_len_vizualizacia.stl

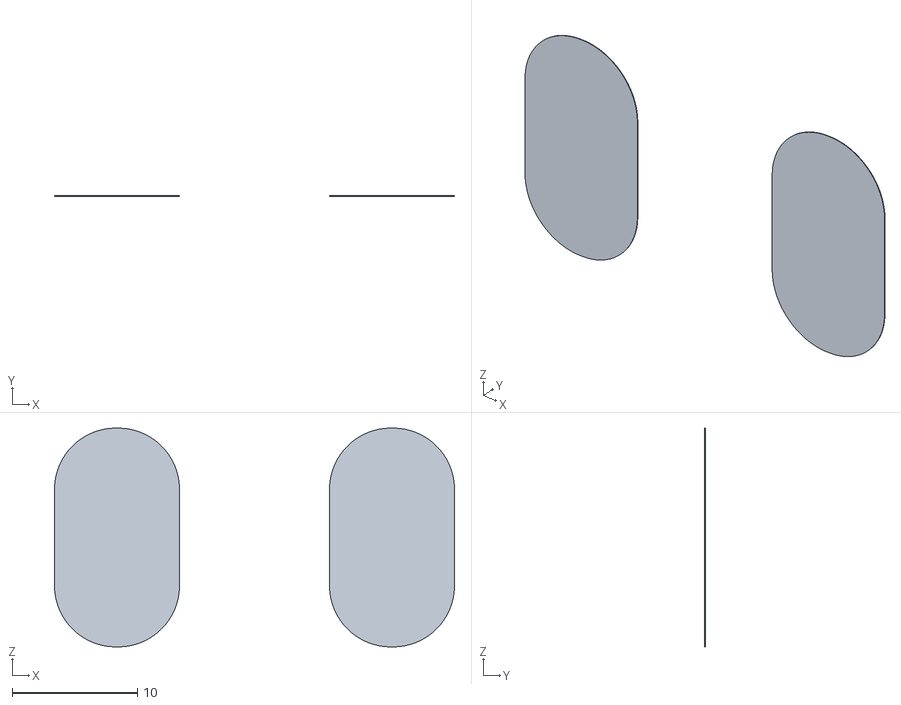
[picture p166: CAD file, 2026-11-11]
obrazky/postupne/03_koncept_otocny_krk/stl/B_servo_v_krku/oci_len_vizualizacia.stl
32.0 x 0.05 x 17.5
