2jkbr252t7-debug/Robot/(list of files, cad)

Other CAD files:
obrazky/postupne/01_hlava_skrupina/NOVA_mini_01_hlava_skrupina_navrh4.step
obrazky/postupne/01_hlava_skrupina/NOVA_mini_01_hlava_skrupina_navrh2.step
nova_v8/sklo/HB03F_blank.dxf
nova_v8/sklo/HB03_mould_rib.dxf
nova_v8/sklo/HP04F_prirez.dxf
nova_v8/sklo/HP04M_maska.dxf
nova_v8/sklo/HP04_forma_rebro.dxf
obrazky/postupne/01_hlava_skrupina/NOVA_mini_01_hlava_skrupina_navrh2.stl
obrazky/postupne/01_hlava_skrupina/NOVA_mini_01_hlava_skrupina_navrh3.stl
obrazky/postupne/01_hlava_skrupina/NOVA_mini_01_hlava_skrupina_navrh4.stl
obrazky/postupne/01_hlava_skrupina/NOVA_mini_01_hlava_skrupina_navrh5.stl
obrazky/postupne/01_hlava_skrupina/NOVA_mini_krk_navrh1.stl
obrazky/postupne/02_krk/NOVA_mini_N1_krk_jeden_diel.stl
obrazky/postupne/02_krk/NOVA_mini_N2-L_viecko_lave.stl
obrazky/postupne/02_krk/NOVA_mini_N2-P_viecko_prave.stl
obrazky/postupne/02_krk/NOVA_mini_N3_unasac_spodny.stl
obrazky/postupne/02_krk_r04/NOVA_mini_N01_golier.stl
obrazky/postupne/02_krk_r04/NOVA_mini_N02_plast_krku.stl
obrazky/postupne/02_krk_r04/NOVA_mini_N06_kryt_naklonu.stl
obrazky/postupne/03_koncept_otocny_krk/NOVA_mini_B.blend
