2jkbr252t7-debug/Robot/(commit log)

2026-11-01 NOVA v7: master spec, CAD/render pipeline, base module, first sheets
    - nova/spec.py: single source of truth (dimensions, materials, joints)
    - docs/SPEC.md: design intent, part list, electronics BOM (Slovak)
    - nova/cad: build123d helpers + base subassembly (B01-B05)
    - nova/render: Blender Cycles renderer, sheet composer, final sheet generator
    - referencie: user's reference images
    Claude-Session: https://claude.ai/code/session_01N8NysgmBVvUJuw9UGwdpKH
2026-11-01 Spec v7.2: merge mechatronics and design-fidelity reviews; WIP modules
    - base 42 mm tall, 166x128 R24; tilt barrel D40 with on-axis servo; head
    shallower with larger bezel/eyes; torso centre band + side shells +
    visible black tray; arm tip on the inner side; 8 deg arm splay
    - electronics: no FPC across joints (ESP32-S3 drives the display in the head)
    - docs/SPEC.md rewritten for v7.2; sheet generator updated
    - work-in-progress head/neck/torso modules from the build agents
    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
2026-11-01 Spec v7.3: manufacturing/assembly review (barrel D42, hub joint, battery hatch B08, T01 aprons, review notes)
    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
2026-11-01 CAD subassemblies: head, neck, torso, arms, internals (52 internal parts); R01-matched tweaks
    - torso plan exponent 2.7, longer/wider arm paddles (R01 matched-camera comparison)
    - darker studio world (deep black glass), warmer eyes, saturated LEDs
    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
2026-11-01 Internals/BOM sheet, CM5 compute module in docs
    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
2026-11-01 Draft image set (all sheets), README image index, CAD export script
    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
2026-11-01 QA fixes: ID-pass callout anchors, shared-scale part matrices, reworked dims/sections/x-ray/kinematics/compare, B05 holes
    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
2026-11-01 Fix portrait ortho scale, ID colour decoding, matrix scale, hero crop, LED colour
    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
2026-11-01 CAD export (STEP zip + BOM CSV), section/x-ray crops, LED colour
    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
    [NOVA_v7.3_kusovnik.csv]
2026-11-01 NOVA mini v8.0 spec (head A, wheels, torso yaw servo in torso, China BOM)
    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
2026-11-01 v8 head variants A+ (curved R180) and B (visor R100) with laser blanks + bending mould files; v7.3 STEP re-export (STEP before STL), all 90 STEP verified
    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
    [HB03F_blank.dxf, HB03_mould_rib.dxf, HP04F_prirez.dxf]
2026-11-01 NOVA mini v8.1 spec: hidden wheels, underglow, dead-front chest strip, nothing visible; v8.0 module builds
    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
2026-11-01 v8.1 WIP: base (hidden wheels, underglow) reviewed, head A modernized, internals + BOM built
    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
2026-11-01 v8 sheet generator for all three head variants; renderer per-robot joint axes
    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
2026-11-01 v8 kinematics sheet: tighter iso framing
    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
2026-11-01 v8 arm sheet: right arm only
    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
2026-11-01 v8.1: torso + head A reviewed (agents); internals re-exported; BOM OCA film + firmware limits; spec notes
    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
    [HP04F_prirez.dxf, HP04M_maska.dxf, HP04_forma_rebro.dxf]
2026-11-02 v8.1 WIP: head variant agent progress
    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
    [HP04F_prirez.dxf, HP04M_maska.dxf, HP04_forma_rebro.dxf]
2026-11-02 display sheet: v8.1 symmetric mask, hidden camera
    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
2026-11-02 v8 exploded view: base cover stays, upper body lifts 95 mm
    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
2026-11-02 v8 sheets: never draw the optional camera placeholder (hidden behind the mask)
    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
2026-11-02 head A/A+: flush white cover plugs over the two underside screws (counterbore 2.5, pad +0.8) – no screw visible
    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
2026-11-02 v8 sheets QA fixes: word-boundary callouts, deepest-pixel anchors, dims label column, PETG material notes, B-B one label per pair, section plane x=0.4, explode ring/tub, head subtitles, Slovak wrap; 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
2026-11-02 head A+: cover plugs HP12 rebuilt
    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
    [HP04F_prirez.dxf, HP04M_maska.dxf, HP04_forma_rebro.dxf]
2026-11-02 v8.1 WIP: head B review agent progress
    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
    [HB03F_blank.dxf, HB03_mould_rib.dxf]
2026-11-02 proportion study (render-only group transforms in render.py): current vs taller torso vs taller+wider torso with lower base
    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
    [HB03F_blank.dxf, HB03_mould_rib.dxf]
2026-11-02 v8.1 head B independently reviewed (27 parts: own neck cable HB18, cover plugs HB19, pocket R7, mask dot); arm soft limits in spec/BOM
    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
2026-11-02 spec v8.2 'B+' proportions: torso 94x76x82, base 124x104x35 (wheels Ø30), arms +20 %, head +13 mm, overall 204 mm
    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
2026-11-02 v8 sheets: cameras for the 204 mm v8.2 robot
    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
2026-11-02 v8.2 WIP: base rebuilt to 124x104x35 with Ø30 wheels (reviewed numbers); torso partially reworked (agent hit usage limit)
    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
2026-11-02 v8.3 soft forms: pebble-plate base + bulb torso in a dish (nova_v8/forms.py, spec form dicts, collar 44x34); prototype render
    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
2026-11-02 spec: KLASIK arm span; archive the chosen concept model
    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
2026-11-02 step-by-step design: part 1 head shell (STL + views) for user review
    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
    [NOVA_mini_01_hlava_skrupina.stl]
2026-11-02 step-by-step: head shell proposal 2 – no screws, one small oval neck opening, clip-in front frame (nova_mini/hlava_skrupina.py)
    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
    [NOVA_mini_01_hlava_skrupina_navrh2.step, NOVA_mini_01_hlava_skrupina_navrh2.stl]
2026-11-02 step-by-step: head shell proposal 3 – ball neck (spherical opening, constant 0.5 mm gap while tilting), context renders
    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
    [NOVA_mini_01_hlava_skrupina_navrh3.step, NOVA_mini_01_hlava_skrupina_navrh3.stl]
2026-11-02 step-by-step: shaped neck proposal 1 (trumpet flare + ball joint, tilt clearance checked)
    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
    [NOVA_mini_krk_navrh1.step, NOVA_mini_krk_navrh1.stl]
2026-11-02 step-by-step: neck that bends at its base (ball hidden in the torso top) and flows into the head – white/black; tilt sheet direction fix
    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
2026-11-02 step-by-step: neck per user's R04 reference (oval collar N01, trumpet shell N02, tilt barrel N06 with caps), tilt ±40° verified to ±45°; STL/STEP + sheets
    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
    [NOVA_mini_N01_golier.step, NOVA_mini_N01_golier.stl, NOVA_mini_N02_plast_krku.step, NOVA_mini_N02_plast_krku.stl, NOVA_mini_N06_kryt_naklonu.step, NOVA_mini_N06_kryt_naklonu.stl]
2026-11-02 neck remodelled faithfully to the user's R04 image (two-tier oval collar, bell neck with front sweep, barrel with domed caps); side-by-side comparison sheet
    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
    [NOVA_mini_N01_golier.step, NOVA_mini_N01_golier.stl, NOVA_mini_N02_plast_krku.step, NOVA_mini_N02_plast_krku.stl, NOVA_mini_N06_kryt_naklonu.step, NOVA_mini_N06_kryt_naklonu.stl]
2026-11-02 neck matched to the R04 front silhouette (overlay check): barrel Ø19.6, neck 14 tall; tilt ±45° clear
    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
    [NOVA_mini_N01_golier.step, NOVA_mini_N02_plast_krku.step, NOVA_mini_N02_plast_krku.stl, NOVA_mini_N06_kryt_naklonu.step, NOVA_mini_N06_kryt_naklonu.stl]
2026-11-03 neck per R04: bell flare left-right, long front ramp front-back, thin oval plate; side-by-side with the user's image
    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
    [NOVA_mini_N01_golier.step, NOVA_mini_N01_golier.stl, NOVA_mini_N02_plast_krku.step, NOVA_mini_N02_plast_krku.stl, NOVA_mini_N06_kryt_naklonu.step, NOVA_mini_N06_kryt_naklonu.stl]
2026-11-03 neck as ONE piece (collar + neck + barrel core), rotating end caps fixed in the head, tilt servo on the barrel axis standing up into the head; head návrh 4 bottom; fine STL/STEP
    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
    [NOVA_mini_01_hlava_skrupina_navrh4.step, NOVA_mini_01_hlava_skrupina_navrh4.stl, NOVA_mini_N1_krk_jeden_diel.step, NOVA_mini_N1_krk_jeden_diel.stl, NOVA_mini_N2-L_viecko_lave.step, NOVA_mini_N2-L_viecko_lave.stl, NOVA_mini_N2-P_viecko_prave.step, NOVA_mini_N2-P_viecko_prave.stl]
2026-11-03 neck after review: head bottom 1 mm above axis (opening hidden to ±45°), cap-shaped head pockets, exact smooth servo sweep, servo crush ribs + end stop, cable through the left cap axis, flatter caps,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
    [NOVA_mini_01_hlava_skrupina_navrh4.step, NOVA_mini_01_hlava_skrupina_navrh4.stl, NOVA_mini_N1_krk_jeden_diel.step, NOVA_mini_N1_krk_jeden_diel.stl, NOVA_mini_N2-L_viecko_lave.step, NOVA_mini_N2-L_viecko_lave.stl, NOVA_mini_N2-P_viecko_prave.step, NOVA_mini_N2-P_viecko_prave.stl]
2026-11-03 neck round 2: smooth collar lip (even loft sections), servo 2 mm to -X with the arm sunk in the right cap (3.9 mm cable passage), cable hole inside the left cap, thrust pads (head axial play ±0.1), N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
    [NOVA_mini_01_hlava_skrupina_navrh4.step, NOVA_mini_01_hlava_skrupina_navrh4.stl, NOVA_mini_N1_krk_jeden_diel.step, NOVA_mini_N1_krk_jeden_diel.stl, NOVA_mini_N2-L_viecko_lave.step, NOVA_mini_N2-L_viecko_lave.stl, NOVA_mini_N2-P_viecko_prave.step, NOVA_mini_N2-P_viecko_prave.stl]
2026-11-03 neck: loft sections share one spline parametrisation -> compact smooth surfaces, N1 STEP 92 MB -> 8 MB (geometry unchanged, re-verified)
    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
    [NOVA_mini_01_hlava_skrupina_navrh4.step, NOVA_mini_N1_krk_jeden_diel.step, NOVA_mini_N1_krk_jeden_diel.stl, NOVA_mini_N2-L_viecko_lave.step, NOVA_mini_N2-P_viecko_prave.step, NOVA_mini_N3_unasac_spodny.step, NOVA_mini_N3_unasac_spodny.stl]
2026-11-04 concept: tilt axis options A (ear pivots + U yoke, axis at head centre) vs B (axis 12 mm in the head, drum Ø42); smooth cone neck on the domed torso
    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
2026-11-04 neck: realistic tilt-axis comparison (axis under the head vs 8 mm in the head, the max that fits the display and head shape); krk_b WIP
    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
2026-11-04 neck v3 WIP: one smooth collar+bell loft (underside on the torso dome), MR128 bearing in the left cap on a hollow stub, right cap carried by the servo, inserts, head bottom through the axis (50/50), 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
2026-11-04 neck v3: parts exported (fine STL/STEP), head návrh 5 (bottom through the axis, 5 mm back), README v3
    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
    [NOVA_mini_01_hlava_skrupina_navrh4.step, NOVA_mini_01_hlava_skrupina_navrh4.stl, NOVA_mini_01_hlava_skrupina_navrh5.step, NOVA_mini_01_hlava_skrupina_navrh5.stl, NOVA_mini_N1_krk_jeden_diel.step, NOVA_mini_N1_krk_jeden_diel.stl, NOVA_mini_N2-L_viecko_lave.step, NOVA_mini_N2-L_viecko_lave.stl]
2026-11-04 neck v4: thin level R04 collar plate with a subtle second tier + slim bell neck (replaces the thick flared base); N3 bosses simplified
    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
    [NOVA_mini_01_hlava_skrupina_navrh5.step, NOVA_mini_N1_krk_jeden_diel.step, NOVA_mini_N1_krk_jeden_diel.stl, NOVA_mini_N2-L_viecko_lave.step, NOVA_mini_N2-P_viecko_prave.step, NOVA_mini_N3_unasac_spodny.step, NOVA_mini_N3_unasac_spodny.stl]
2026-11-04 neck v4 sheets and fine STL/STEP exports
    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
2026-11-04 neck v5: round collar disc sunk flush into the torso (Ø47 pocket), bell grows out of it with an r3 blend; README
    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
    [NOVA_mini_01_hlava_skrupina_navrh5.step, NOVA_mini_N1_krk_jeden_diel.step, NOVA_mini_N1_krk_jeden_diel.stl, NOVA_mini_N2-L_viecko_lave.step, NOVA_mini_N2-P_viecko_prave.step, NOVA_mini_N3_unasac_spodny.step, NOVA_mini_N3_unasac_spodny.stl]
2026-11-04 Revert "neck v5: round collar disc sunk flush into the torso (Ø47 pocket), bell grows out of it with an r3 blend; README"
    This reverts commit 65624a21a592cf60885d15f6ba9373a30e30d140.
    [NOVA_mini_01_hlava_skrupina_navrh5.step, NOVA_mini_N1_krk_jeden_diel.step, NOVA_mini_N1_krk_jeden_diel.stl, NOVA_mini_N2-L_viecko_lave.step, NOVA_mini_N2-P_viecko_prave.step, NOVA_mini_N3_unasac_spodny.step, NOVA_mini_N3_unasac_spodny.stl]
2026-11-04 neck README: collar plate + N3 will be sunk flush into the torso (round pocket, torso step)
    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
2026-11-04 neck: no head pan (only tilt) – N1 fixed in the torso via N3, oval torso pocket; README + docstrings
    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
2026-11-04 neck v6: no second tier (plate top 4.0, flush in the torso), bell turned 180° (long ramp at the back); README
    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
2026-11-04 neck v6: N1 STL/STEP (no second tier, bell turned 180°)
    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
    [NOVA_mini_N1_krk_jeden_diel.step, NOVA_mini_N1_krk_jeden_diel.stl]
2026-11-04 concept: head pan with a separate round two-tier collar and a fixed saddle plate (quick renders)
    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
2026-11-04 concept per sketch: fixed torso-mock hole, 4 views
    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
2026-11-04 concept per sketch: x-ray of the pan drive (bearing + vertical servo under the neck)
    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
2026-11-04 concept per the user's latest sketch: barrel mostly in the head, joint centred, taller conical neck, camera
    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
2026-11-04 concept v2: previous neck, smaller head-torso gap (14 mm), black visor visible from the side
    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
2026-11-04 concept: neck option 3 with 10/14/18 mm head-torso gaps, side/front/3-4 views
    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
2026-11-04 concept: six more neck variants at a 10 mm gap (joint style, neck width, collar), with zoomed details
    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
2026-11-04 concept: narrow cone with hidden / half-in-head joint x three bevelled collars blending into the shoulders
    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
2026-11-04 concept: round (axisymmetric) collars without a front point, 3 sizes x hidden / half joint
    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
2026-11-04 concept: yoke neck with bearing hubs per the user's reference photos (A/B) + own refined variant (C), tilt ±30°
    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
2026-11-04 concept: design 2 (narrow cone, joint in the head, round collar) in four views
    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
2026-11-04 concept: design C1 (bell neck, joint in the head, flush collar) in four views
    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
2026-11-04 NOVA mini: odporúčaný návrh krku (zvon, okrúhly golier, medzera 16 mm, náklon ±40°)
    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
2026-11-05 NOVA mini: viditeľný kĺb náklonu – guľa a ležatá olivka (bez diery v hlave, náklon ±40°)
    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
2026-11-05 NOVA mini: nový návrh krku bez vypuklého kĺbu – A poklona trupu, B mäkký krk
    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
2026-11-05 NOVA mini: vysúvací krk – v pokoji hlava na tele, pri náklone sa krk vysunie (bez dier, všetko zo živice)
    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
2026-11-05 NOVA mini: vysúvací krk – priehľadný obrázok mechaniky (servá, tyčky, ložiská, pánt)
    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
2026-11-05 NOVA mini: model hlavy s vysúvacím krkom (servo náklonu v hlave, pánt na 2 ložiskách, dutý krk)
    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
2026-11-05 NOVA mini: hlava s krkom – servo náklonu presunuté nad pánt, displej podľa tvaru hlavy (nič nevyčnieva)
    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
2026-11-05 NOVA mini: hlava 108×77 (zmestí sa displej 3,5" 86×56), servo náklonu za displejom, presný otvor pre tiahlo v pánte
    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
2026-11-05 NOVA mini: porovnanie servo náklonu v hlave vs. v krku (rovnaká mierka)
    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
2026-11-05 NOVA mini: porovnanie servo v hlave vs. v krku s ilustračným trupom (100 mm)
    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
2026-11-05 NOVA mini: 3D modely oboch verzií (A servo v hlave, B servo v krku) s trupom + prehliadač s prepínačom
    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
2026-11-05 NOVA mini: STL modely oboch verzií (A, B) + zip; golier B okrúhly a zarovno s prstencom ako pri A
    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
    [NOVA_mini_A_CELOK_naklon_40_dole.stl, NOVA_mini_A_CELOK_v_pokoji.stl, NOVA_mini_A_golier_kotuc.stl, NOVA_mini_A_golier_prstenec.stl, NOVA_mini_A_hlava.stl, NOVA_mini_A_krk.stl, NOVA_mini_A_sklo.stl, NOVA_mini_A_trup.stl]
2026-11-05 NOVA mini: krk B – pánt bez dier (uško zvonka zatvorené), krk z 2 plných polovíc, upevnenie serva
    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
2026-11-05 NOVA mini: STL + 3D model – pánt bez dier aj pre A, krk B z dvoch polovíc so skrutkami a kolíkmi
    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
    [NOVA_mini_A_CELOK_naklon_40_dole.stl, NOVA_mini_A_CELOK_v_pokoji.stl, NOVA_mini_A_hlava.stl, NOVA_mini_A_krk.stl, NOVA_mini_A_vnutro_cable.stl, NOVA_mini_A_vnutro_pins.stl, NOVA_mini_B_CELOK_naklon_40_dole.stl, NOVA_mini_B_CELOK_v_pokoji.stl]
2026-11-11 NOVA mini B rev. E2: hlava a krk podľa skutočného displeja a serva, hladký povrch
    - displej Waveshare ESP32-S3-Touch-LCD-3.5B podľa oficiálneho výkresu (sklo 92,44 × 61, stĺpiky M2 72 × 48,5);
    sklo displeja je tvárou robota v čiernom ráme, predný modul drží na 6 magnetoch
    - hlava 110 × 79 (N 5), rovnaké predné zaoblenie dookola, rám zarovno so škrupinou, klenuté uši
    - servo MG90S podľa obrázka: vežička s dvoma rovnako vysokými výstupkami, kábel pri hriadeli ide hore do hlavy,
    ušká sa odrežú, kapsa s penou prijme rozsah rozmerov 12,0–12,3 × 22,4–22,8 × 22,4–23,0
    - pánt so škárou 0,3 a PTFE krúžkom, uši pántu bez zásteriek, krk R3, golier s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
    [CELOK_naklon40.stl, CELOK_pokoj.stl, CELOK_vysunute.stl, NOVA_mini_A_CELOK_naklon_40_dole.stl, NOVA_mini_A_CELOK_v_pokoji.stl, NOVA_mini_A_golier_kotuc.stl, NOVA_mini_A_golier_prstenec.stl, NOVA_mini_A_hlava.stl]
2026-11-11 NOVA mini B rev. E2: hranatý krk, kolíska pod pántom, hladké STL na prezeranie
    - krk a uši pántu s hranami R0.5 (na želanie); pod ušami kolíska – sedlo R10.5 zrezané rovno na z = 10
    (celé sedlo by nechalo 0.3 mm klin); golier R0.75, šachta v trupe R1.5
    - všetky kontroly E1–E10 + integrácia, montáž, STL: PASS (aj viditeľnosť vnútra)
    - STL viditeľných dielov s presnosťou povrchu 0.005 mm; celky na prezeranie ako GLB (vyhladené, vyfarbené)
    namiesto zjednodušených CELOK STL, ktoré v Blenderi vyzerali hranato
    - README: ako vyhladiť STL v Blenderi
    Claude-Session: https://claude.ai/code/session_01N8NysgmBVv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
    [CELOK_naklon40.stl, CELOK_pokoj.stl, CELOK_vysunute.stl, NOVA_mini_B.blend, displej.stl, golier_kotuc.stl, golier_prstenec.stl, hlava_skrupina.stl]
2026-11-11 NOVA mini B rev. E2: hladký zadok hlavy bez „kocky“, jemné STL, kontroly PASS
    - profil hlavy zboku plynulý (bez skokov v zakrivení): rovný úsek y -24..-6, potom squircle (exponent 3.5)
    až po malú uzatváraciu plôšku; zmizol hranol so zlomom na y = 3 aj rovná zadná doska 33 x 23 mm;
    predné zaoblenie exponent 2.4; prierezy 144 bodov rovnomerne po obvode, stanice každých 1.2 mm
    - vnútorné prvky (podložky, mostík kábla) orezané 0.4 mm vo vnútri steny (nie na vonkajšej ploche)
    - všetky kontroly E1–E10, integrácia, montáž, STL: PASS
    - Blender scéna s jemným povrchom, celky GLB (vyhladené, farebné), rendery a 3D model aktualizované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
    [NOVA_mini_B.blend, hlava_skrupina.stl, magnety.stl, ram_displeja.stl, usko_kryt.stl, usko_lozisko.stl]
2026-11-11 NOVA mini B: obrázok pántu – čo je čo, čo drží čo a ako je to uchytené
    Rozložený pánt pozdĺž osi a rez osou pántu s popiskami v slovenčine, súhrn
    „čo drží čo“ a „ako je čo uchytené“ (lepené / skrutky / nasunuté / nelepiť).
    Popisky overené nezávislou kontrolou voči montážnemu návodu a CAD.
    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
2026-11-11 NOVA mini B rev. E2f: vodiče serva dole krkom do trupu, hlava zospodu zatvorená
    - servo sa upraví: pôvodný kábel sa odspájkuje, 3 vodiče AWG30 vyjdú zárezom 2 × 2 mm
    na okraji spodného veka a idú drážkou v prednej polovici krku dole do trupu
    - zrušené: drážka vo vrchu kĺbu, penová zátka, drážka v podlahe hlavy, klenba, mostík,
    kábel v hlave; podlaha hlavy je zatvorená, pri náklone nič netrčí
    - servo sa zapája v trupe (prúd serva už nejde cez displej); montážny návod s postupom
    úpravy serva; kontroly E1–E10, X, A, T, S, R5: všetky PASS
    - rendery, rezy, obrázok pántu, Blender, celky GLB a 3D model aktualizované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
    [NOVA_mini_B.blend, hlava_skrupina.stl, kabel.stl, krk_predna_polovica.stl, krk_zadna_polovica.stl, pena_serva.stl, servo_MG90S.stl]
2026-11-11 NOVA mini: trup a podstavec – rozpracované (vnútro K2, tvary f1/f2), zastavené
    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
